F-JJTH/aeropi/www/v1/settings.txt

{"map":{"display":{"asi":true,"alt":true,"compass":true,"track":true},"overlays":{"vac":{"app":false,"lnd":true}},"layer":"oaci"},"efis":{"asi":{"tickspacing":6,"source":"gps","speed":{"vne":260,"vno":170,"vfe":110,"vso":65,"vs":90},"color":{"vne":"red","caution":"orange","normal":"green","flaps":"white"}},"alt":{"tickspacing":6,"maxalt":25000,"qnh":1018,"source":"baro"},"ai":{"color":{"ground":"#BF8144","sky":"#4C78A9"}},"compass":{"magneticdeclinaison":0,"source":"gps"},"attitude":{"pitchoffset":24.9,"rolloffset":-0.25},"timezone":{"summer":false,"offset":1},"etaType":"wp","dstType":"wp"},"general":{"lastposition":{"lat":44.11122,"lng":5.107401667},"unit":{"altitude":"ft","elevation":"ft","distance":"nm","speed":"kmh"}}}
