F-JJTH/aeropi/resources/LM2596 BUCK DC DC module schematic.jpg

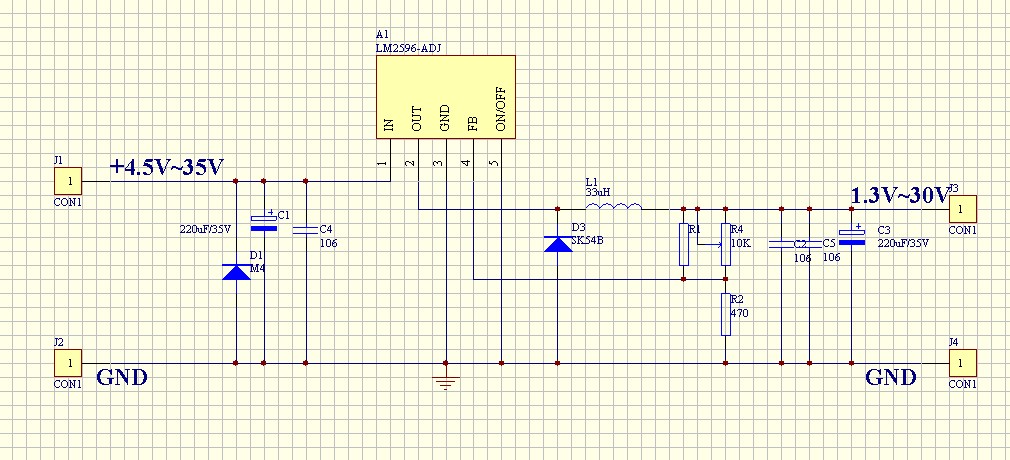
resources/LM2596 BUCK DC DC module schematic.jpg
