F-JJTH/aeropi/resources/circuit/aeroPi.ods

Reference | Value | Footprint | Datasheet | Mouser Part No. | Dispo
U3 | BME280 | aeroPi:BME280 |  |  | OK
U6 | FGPMMOPA6H | aeroPi:PA6H |  |  | OK
BT1 | Battery_Cell | Battery_Holders:Keystone_3000_1x12mm-CoinCell |  |  | OK
C1 | 0.1u | Capacitors_SMD:C_0603 |  |  | OK | https://www.aliexpress.com/item/0603-SMD-Capacitor-assorted-kit-36values-20pcs-720pcs-1pF-10uF-Samples-Kit-electronic-diy-kit/32817046315.html
C5 | 0.1u | Capacitors_SMD:C_0603 |  |  | OK
C13 | 0.1u | Capacitors_SMD:C_0603 |  |  | OK
C12 | 0.1u | Capacitors_SMD:C_0603 |  |  | OK
C11 | 0.1u | Capacitors_SMD:C_0603 |  |  | OK
C19 | 0.1u | Capacitors_SMD:C_0603 |  |  | OK
C4 | 0.1u | Capacitors_SMD:C_0603 |  | 810-C1005X5R1H104K | OK
C17 | 10n | Capacitors_SMD:C_0603 |  |  | OK
C20 | 10n | Capacitors_SMD:C_0603 |  |  | OK
C10 | 10n | Capacitors_SMD:C_0603 |  |  | OK
C9 | 10u | Capacitors_SMD:C_0603 |  |  | OK
C7 | 10u | Capacitors_SMD:C_0603 |  |  | OK
C3 | 10u | Capacitors_SMD:C_0603 |  |  | OK
C14 | 1u | Capacitors_SMD:C_0603 |  |  | OK
C16 | 1u | Capacitors_SMD:C_0603 |  |  | OK
C24 | 22n | Capacitors_SMD:C_0603 |  |  | OK
C21 | 470p | Capacitors_SMD:C_0603 |  |  | OK
C23 | 47p | Capacitors_SMD:C_0603 |  |  | OK
J1 | CONN_COAXIAL | Connectors_Molex:Molex_Microcoaxial_RF |  |  | OK
J2 | DB15_FEMALE | Connectors:DB15FC |  |  | OK | https://www.aliexpress.com/item/10pcs-DB15-D-SUB-Angle-Angled-15-Pin-Female-PCB-Mount-Socket-Connector/32709683735.html
D2 | 3D FIX | Diodes_SMD:D_0603 |  |  | OK
D4 | Diode | Diodes_SMD:D_SOD-323 |  |  | OK | https://www.aliexpress.com/item/New-1N4007-SOD-323-Silkscreen-T7-Rectifier-Diode-1A-1000V-4007-SOD323/32814032254.html
D5 | 5.6V | Diodes_SMD:D_SOD-323 |  |  | OK | https://www.aliexpress.com/item/New-Patch-Zener-Diode-BZT52C5V6S-5-6V-W9-Silkscreen-SOD-323-0805-Volume/32813876507.html
U7 | MPU-9250 | Housings_DFN_QFN:QFN-24_3x3mm_Pitch0.4mm |  |  | OK
U12 | LM358 | Housings_SOIC:SOIC-8_3.9x4.9mm_Pitch1.27mm |  |  | OK
U9 | ADS7828 | Housings_SSOP:TSSOP-16_4.4x5mm_Pitch0.65mm |  |  | OK
P1 | CONN_01X02 | Pin_Headers:Pin_Header_Straight_1x02_Pitch2.54mm |  |  | OK
P2 | CONN_01X02 | Pin_Headers:Pin_Header_Straight_1x02_Pitch2.54mm |  | 651-1904383 | OK
P4 | CONN_01X02 | Pin_Headers:Pin_Header_Straight_1x02_Pitch2.54mm |  | 651-1904383 | OK
J4 | CONN_01X04 | Pin_Headers:Pin_Header_Straight_1x04_Pitch2.54mm |  |  | OK
R20 | 220 | Resistors_SMD:R_0603 |  |  | OK | https://www.aliexpress.com/item/Free-shipping-0603-SMD-Resistor-Kit-1-10ohm-to-910Kohm-80-values-25pcs-2000pcs-Chip-Resistor/32694000352.html
R15 | 220 | Resistors_SMD:R_0603 |  |  | OK
R23 | 220 | Resistors_SMD:R_0603 |  |  | OK
R13 | 470 | Resistors_SMD:R_0603 |  |  | OK
R16 | 100k | Resistors_SMD:R_0603 |  |  | OK
R26 | 100k | Resistors_SMD:R_0603 |  |  | OK
R21 | 10k | Resistors_SMD:R_0603 |  |  | OK
R22 | 10k | Resistors_SMD:R_0603 |  |  | OK
R24 | 10k | Resistors_SMD:R_0603 |  |  | OK
R25 | 10k | Resistors_SMD:R_0603 |  |  | OK
R30 | 10k | Resistors_SMD:R_0603 |  |  | OK
R31 | 10k | Resistors_SMD:R_0603 |  |  | OK
R28 | 10k | Resistors_SMD:R_0603 |  |  | OK
R29 | 10k | Resistors_SMD:R_0603 |  |  | OK
R14 | 10k | Resistors_SMD:R_0603 |  |  | OK
R27 | 10k | Resistors_SMD:R_0603 |  |  | OK
R11 | 10k | Resistors_SMD:R_0603 |  | 71-CRCW0402-10K-E3 | OK
R1 | 1k | Resistors_SMD:R_0603 |  | 754-RR0510P-102D | OK
R3 | 3.9k | Resistors_SMD:R_0603 |  | 71-CRCW04023K90FKED | OK
R5 | 3.9k | Resistors_SMD:R_0603 |  | 71-CRCW04023K90FKED | OK
R17 | 47k | Resistors_SMD:R_0603 |  |  | OK
R12 | 47k | Resistors_SMD:R_0603 |  | 667-ERJ-2RKF4702X | OK
R19 | 51k | Resistors_SMD:R_0603 |  |  | OK
JP1 | JUMPER | Resistors_SMD:R_0603 |  |  | OK
L2 | Ferrite | Resistors_SMD:R_0805 |  |  | OK
U8 | Airspeed | SMD_Packages:SOIC-8-N |  |  | OK
U11 | MAP Pressure | SMD_Packages:SOIC-8-N |  |  | OK
Q2 | BSS138 | TO_SOT_Packages_SMD:SOT-23 |  |  | OK
Q3 | BSS138 | TO_SOT_Packages_SMD:SOT-23 |  |  | OK
Q5 | BSS138 | TO_SOT_Packages_SMD:SOT-23 |  |  | OK
Q4 | BSS138 | TO_SOT_Packages_SMD:SOT-23 |  |  | OK
Q1 | BSS138 | TO_SOT_Packages_SMD:SOT-23 |  | 621-DMG2305UX-13 | OK
U1 | MIC5219-3.3BM5 | TO_SOT_Packages_SMD:SOT-23-5 |  |  | OK | https://www.aliexpress.com/item/10PCS-MIC5219-3-3BM5-MIC5219-3-3-MIC5219-SOT23-5/32240921827.html
P3 | Raspberry_Pi_+_Conn | w_pin_strip:pin_socket_20x2 |  | 517-30340-6002 | OK
U2 | CAT24C32HU4I-GT3 | w_smd_dil:tssop-8 |  | 698-CAT24C32YI-GT3 | OK
U5 | DMMT5401 | w_smd_trans:sot23-6 |  | 621-DMMT5401-7-F | OK | https://www.aliexpress.com/item/FREE-SHIPPING-DMMT5401-7-F-DMMT5401-150V-0-2A-SOT26-50PCS/32799505824.html
