F-JJTH/aeropi/www/utils/basulm_1130.csv

Obsolète | Code terrain | Toponyme | Type | Date creation | Dernière modification | Date validation | Position | Latitude | Longitude | Altitude | Consignes | Nombre de pistes | Nature première piste | Axe préférentiel première piste | Largeur première piste | Longueur première piste | Orientation première piste | Nature deuxième piste | Axe préférentiel deuxième piste | Largeur deuxième piste | Longueur deuxième piste | Orientation deuxième piste | Radio | Carburant | Facilités | Facilités en clair | Email de contact | Téléphone | Informations complémentaires
 | LF0121 | La Tranclière | Base ULM Accès privé | 8/03/2011 | 18/02/2017 | 19/02/2017 | 46.095759195808945, 5.286019507934611 | N 46 05 45 | E 005 17 10 | 820 ft | Tour de piste impératif du côté autoroute.Ne pas voler au dessus du village de la Tranclière.Brume presque toujours dégagée. | 1 | herbe | '36 | 40 | 640 | '18-36 | herbe |  |  |  | 'Inconnue | 123.5 | à 4.5 kms | 6,4 | Restauration à proximité, Gîte à proximité | roger.emeriat@wanadoo.fr | +33 4 74 46 84 34 | Attention région très brumeuse altiport de Corlier à 15 km presque toujours dégagéTél du terrain 04 74 39 19 77Village le plus proche essence, Hôtels Pont D'ain à 4, 5 km.Auberge du Mas Pommier à Druillat direction, Pont d'Ain tel 04 74 39 17 40
 | LF0125 | Lavours | Base ULM Autorisation OBLIGATOIRE | 8/03/2011 | 18/02/2017 | 19/02/2017 | 45.795718117737, 5.773954322753866 | N 45 47 45 | E 005 46 26 | 768 ft | TDP à l'EstEviter les villages en rouge sur la photofaire la vent-arrière sur le Rhône.Attention aux rouleaux par vent de travers | 1 | herbe |  | 20 | 450 | '01-19 | herbe |  |  |  | 'Inconnue | 123.5 |  |  |  |  | +33 4 79 42 11 57 | attention, base Hydro ULM club de Lavours à proximité
 | LF0151 | Corbonod Seyssel | Aérodrome Privé Avec Restrictions Autorisation OBLIGATOIRE | 6/09/2011 | 7/10/2017 | 9/10/2017 | 45.961435318008235, 5.817990303039551 | N 45 57 41 | E 005 49 05 | 1175 ft | Arrivée dans axe de la piste puis, du centre vent arrière main gauche Suivre le plan imperatif (photo jointe) | 1 | dur | '01 | 15 | 400 | '01-19 | herbe |  |  |  | 'Inconnue | 123.5 |  | 6,4 | Restauration à proximité, Gîte à proximité | dudunoyer@yahoo.fr | +33 6 07 38 20 15 | PPR obligatoire pour tous, ULM et avion (arrêté préfectoral). Contacter le Pdt de l'AAC gestionnaire.Radio obligatoire pour tous + qualif montagne souhaitée pour avion. Interdit ULM classe 1Survol interdit à l'Est du Rhône entre Seyssel et Culoz: Zone Biotope Natura 2000Interdit en école sauf découverte du terrain pour nouveau locataire . .Radio 123.5 car piste légèrement convexe.Camping 1.5 KMResto + hôtel : 2Km
 | LF0152 | Crottet Le Bief | Base ULM Autorisation OBLIGATOIRE | 2/12/2011 | 18/02/2017 | 19/02/2017 | 46.28512660120123, 4.886040687561035 | N 46 17 06 | E 004 53 10 | 597 ft | Atterrissage en 19Décollage en 01 uniquementTDP à l'Est, intégration vent arrière 19 par le travers du seuil 01 afin d'éviter le survol des habitations au Sud. | 1 | herbe | '19 | 10 | 320 | '01-19 | herbe |  |  |  | 'Inconnue | Auto info 123.500 |  |  |  | club.ulm.crottet@gmail.com | +33 3 85 31 59 99 | Tél. Club: 03 85 31 59 99Tél. mobile : 06.52.38.01.88
 | LF0153 | Izenave | Base ULM Accès privé | 8/03/2011 | 18/02/2017 | 19/02/2017 | 46.027364325662, 5.524019645507792 | N 46 01 39 | E 005 31 26 | 2280 ft | Piste située en contrebas à l'est de l'altisurface de CORLIER qui est à survoler après auto-information en 130.00. Il est préférable d'appeler avant Pierre PELISSON pour consignes. Accueil chaleureux garanti. | 1 | herbe |  | 20 | 300 | '16-34 | herbe |  |  |  | 'Inconnue | 130.00 |  |  |  |  | +33 4 74 76 30 63 | AD - LFJD Corlier à proximité
 | LF0154 | Polliat | Base ULM Autorisation OBLIGATOIRE | 8/03/2011 | 26/12/2015 | 23/02/2016 | 46.25588282694129, 5.149563785736063 | N 46 15 21 | E 005 08 58 | 718 ft |  | 1 | herbe |  | 20 | 400 | '16-34 | herbe |  |  |  | 'Inconnue | 123.5 |  |  |  | alainbenonnier@orange.fr | +33 6 11 32 68 47
oui | LF0155 | Sergy | Base ULM fermée définitivement | 8/03/2011 | 7/07/2015 | 24/08/2017 | 46.25377556022431, 6.015897735412636 | N 46 15 14 | E 006 00 57 | 1509 ft | Plateforme fermée (temporairement), son utilisation est strictement interdite. A 2,3km la frontière suisse: ULMs interdits en Suisse ! A 500m au SE, la limite de la CTR de classe 'D' de Genève.... A 800m au Nord, un petit lac qui est le point de report 'N | 1 | herbe |  |  | 500 | '04-22 | herbe |  |  |  | 'Inconnue |  |  |  | invalid | vbujard@freesurf.ch | +41 78 711 21 35 | Consultez: http://www.agcna.org/images/Arr.VFR.jpg. Plateforme située le long de l'ancienne voie unique ferrée qui allait jadis de Bellegarde (Ain) à Nyon (Vaud).
 | LF0157 | Mionnay | Base ULM Privé Avec Restrictions Autorisation OBLIGATOIRE | 28/10/2011 | 20/03/2017 | 22/03/2017 | 45.90046192366156, 4.896061420440674 | N 45 54 02 | E 004 53 46 | 900 ft | TDP Ouest (Coté autoroute) 1300 ft ATTENTION CONTACT PREALABLE ET AUTORISATION ECRITE OBLIGATOIREterrain courtFortes turbulences possibles en courte finale 19 | 1 | herbe | '01 | 40 | 230 | '01-19 | herbe |  |  |  | 'Inconnue | 123.500 | non |  |  | eric.delachambre@orange.fr | +33 6 80 53 32 48 | Plateforme difficileCONTACT PREALABLE ET AUTORISATION ECRITE OBLIGATOIRE
 | LF0158 | Rhône Lavours | HydroSurface Libre Ouvert aux ULM Autorisation OBLIGATOIRE | 26/12/2011 | 9/04/2017 | 11/04/2017 | 45.81087630653, 5.781319903369194 | N 45 48 39 | E 005 46 53 | 767 ft | Surveiller trafic fluvial et plaisance.Lignes haute tension au-dessus du barrage. Le survol à basse altitude de la réserve naturelle du Marais de Lavours et de l'ile Malourdie à proximité de la plate forme est interdit. | 1 | eau |  |  |  | 'omnidir | herbe |  |  |  | 'Inconnue | Auto-info 123.5 |  | 3 | Restauration sur place | Carton_r@hotmail.com | +33 4 79 42 11 57 | Ponton du restaurant disponibleHydroULM Club de Lavours.L'hydrosurface est réservée aux ULMHydro.
 | LF0159 | Montrevel en Bresse | HydroSurface Libre Ouvert aux ULM Autorisation OBLIGATOIRE | 11/04/2012 | 29/03/2016 | 31/03/2016 | 46.344989833094, 5.142219161987327 | N 46 20 42 | E 005 08 32 | 620 ft |  | 1 | eau |  |  | 1000 | 'omnidir | herbe |  |  |  | 'Inconnue | Auto-info 123.5 |  | 3 | Restauration sur place |  | +33 4 74 42 72 88
 | LF0160 | Tallissieu | Aérodrome Privé Ouvert aux ULM | 14/12/2013 | 28/08/2017 | 30/08/2017 | 45.871696857606, 5.726961498355877 | N 45 52 18 | E 005 43 37 | 1433 ft | main gauche à 300 ft | 1 | herbe | '34 | 10 | 150 | '16-34 | herbe |  |  |  | 'Inconnue |  |  |  | invalid |  | +33 6 69 19 20 64 | Aérodrome privé de type altisurface.Aérologie difficile, même quand c'est calme ! plateforme supérieure étroite, bon état de surface mais devers à gauche dans le sens atterrissage, éviter le survol des riverains.
 | LF0221 | Azur Ulm | Base ULM Accès privé | 26/07/2011 | 20/10/2017 | 22/10/2017 | 49.461067531545, 3.8483798503875732 | N 49 27 40 | E 003 50 54 | 240 ft | Piste 'technique' pour les débutants. En montée vers le Nord.Aérologie parfois 'déconcertante' sur les 2 finales.Tour de piste à 700 ft QNH à l'Est des installations.Merci de ne pas survoler le village de CORBENY. | 1 | herbe |  | 20 | 235 | '18-36 | herbe |  |  |  | 'Inconnue | auto-info 123.5 | Non | 6,2,4,5 | Restauration à proximité, Hangar possible, Gîte à proximité, Camping possible | contact@azur-ulm.fr | +33 6 18 57 94 56 | Arnaud GILOTIN, propriétaire-gestionnaire est instructeur paramoteur, pendulaire, multiaxe, autogire.Contacter Arnaud au 06.18.57.94.56Consignes sur www.azur-ulm.frPour le hangar contacter Arnaud.
 | LF0223 | Mosloy | Règles spécifiques d'accès | 27/04/2011 | 20/08/2017 | 21/08/2017 | 49.174761423663, 3.154671284357846 | N 49 10 29 | E 003 09 17 | 453 ft | Téléphoner au gestionnaire (06 82 31 98 82) pour connaitre l'état de la piste avant de se poser, sauf urgence ou cas de force majeure.Posez plutôt en partie haute de la piste 11 (meilleur état) | 1 | herbe | '29 | 50 | 350 | '11-29 | herbe |  |  |  | 'Inconnue | 123.5 | A 5 kms Super U | 6,4,5 | Restauration à proximité, Gîte à proximité, Camping possible | ofjpeca@orange.fr | +33 3 23 85 24 02 | Piste située au sud, et parallèle au hameau de Mosloy.Propriétaire très sympa, abris (hangar) possible.Village à visiter, ancien château
 | LF0225 | Ployart | Base ULM Accès privé | 23/10/2011 | 22/12/2015 | 2/01/2016 | 49.503888888889, 3.7380555555555475 | N 49 30 14 | E 003 44 17 | 580 ft |  | 1 | herbe |  | 40 | 450 | '05-23 | herbe |  |  |  | 'Inconnue | auto-info 123.5
 | LF0226 | Brochot | Aérodrome Privé Ouvert aux ULM | 8/03/2011 | 25/12/2015 | 17/02/2016 | 48.976617705649, 3.373195474868794 | N 48 58 36 | E 003 22 24 | 574 ft | Tour de piste au NordEviter le survol du Village | 1 | herbe |  | 30 | 300 | '07-25 | herbe |  |  |  | 'Inconnue | Auto info 123.5 | Sur demande | 2,4,5 | Hangar possible, Gîte à proximité, Camping possible | champagne.petit@orange.fr | +33 6 80 65 93 74 | Téléphoner avant visite ULM bienvenus
oui | LF0251 | Besny-Loizy | Base ULM fermée définitivement | 8/03/2011 | 16/12/2013 | 17/12/2013 | 49.586389, 3.575833 | N 49 35 11 | E 003 34 33 | 262 ft | ATTENTION. PLATEFORME REMISE EN CULTURE QUI N'EXISTE PLUS. | 1 | herbe |  |  | 340 | '13-31 | herbe |  |  |  | 'Inconnue
 | LF0253 | Neuflieux | Base ULM Autorisation OBLIGATOIRE | 23/10/2011 | 22/12/2015 | 30/12/2015 | 49.6110714430628, 3.1485486030578613 | N 49 36 40 | E 003 08 55 | 195 ft |  | 2 | herbe |  | 20 | 200 | '17-35 | herbe |  | 20 | 200 | '06-24 | auto-info 123.5 |  |  |  | ulm@chauny.com | +33 6 75 64 54 02
oui | LF0255 | Thiérache - Vigneux | Base ULM fermée définitivement | 23/10/2011 | 23/10/2011 | 12/12/2013 | 49.728529529831, 4.008035659790039 | N 49 43 43 | E 004 00 29 | 600 ft | Circuit au sud à 500ft QFE de préférence la 26 qui est en légère montée.TERRAIN FERME | 1 | herbe |  | 0 | 600 | '08-26 |  |  |  |  |  | auto-info 123.5 |  |  |  |  | +33 6 60 12 43 54 | TERRAIN FERME.
 | LF0256 | Corbeny | Base ULM Autorisation OBLIGATOIRE | 8/03/2011 | 22/12/2015 | 30/12/2015 | 49.45763852316789, 3.8545103227538675 | N 49 27 27 | E 003 51 16 | 230 ft | Strict PPR : plateforme privée. Il s'agit d'un terrain privatif, avec un accès strictement réservé (donc accès réservé aux personnes autorisées par le propriétaire). | 1 | herbe |  |  | 400 | '18-36 | herbe |  |  |  | 'Inconnue |  |  |  |  |  |  | Ne pas confondre avec azur ulm à 500 m au Nord Ouest
 | LF0257 | Taillefontaine | Base ULM Autorisation OBLIGATOIRE | 23/10/2011 | 21/05/2017 | 22/05/2017 | 49.30708209517026, 3.0651940687865817 | N 49 18 25 | E 003 03 55 | 475 ft |  | 1 | herbe |  | 25 | 600 | '03-21 | herbe |  |  |  | 'Inconnue | auto-info 123.5 |  |  |  |  | +33 3 23 96 00 11
 | LF0258 | La Flamengrie | Base ULM Accès privé | 5/07/2011 | 22/12/2015 | 30/12/2015 | 50.000250186864, 3.944821357727051 | N 50 00 01 | E 003 56 41 | 642 ft | en 01 : arbres et haieen 19 : route et haie | 1 | herbe | '01 | 40 | 300 | '01-19 | herbe |  |  |  | 'Inconnue | 123.45 |  |  |  |  | +33 3 23 97 23 12 | Téléphoner avant de venir. Très accueillant.
 | LF0259 | Base Ulm du Val de l'Ailette | Base ULM Accès privé | 3/03/2014 | 22/12/2015 | 30/12/2015 | 49.56744269009908, 3.2303074391684206 | N 49 34 03 | E 003 13 49 | 184 ft | verticale 300m solcircuit de piste par l'est, à 150 m sol, côté hangarAu sud des installations,le seuil de piste est décalé , il se situe à 105 m de la route. | 1 | herbe |  |  | 250 | '18-36 | herbe |  |  |  | 'Inconnue |  |  |  |  |  | +33 6 88 18 07 66
 | LF0324 | Veauce | Base ULM Autorisation OBLIGATOIRE | 23/10/2011 | 29/08/2017 | 30/08/2017 | 46.173333333333, 3.0588888888888732 | N 46 10 24 | E 003 03 32 | 1570 ft | Plateforme privée. C'est ce qui reste de l'ancien aérodrome (pour avions) de Veauce. | 1 | herbe |  | 30 | 300 | '12-30 | herbe |  |  |  | 'Inconnue | auto-info 123.5 |  |  | invalid | nicole_lagoutte@orange.fr | +33 6 81 91 79 07
oui | LF0352 | Deneuille les Chanteille | Base ULM fermée définitivement | 8/03/2011 | 16/06/2012 | 17/12/2013 | 46.25046204786897, 3.145910232788083 | N 46 15 02 | E 003 08 45 | 1105 ft | Plateforme privée occasionnelle, PPR à Mr Berton Alain, phone: 04 70 56 61 90. | 1 | herbe |  |  |  | '18-36 | herbe |  |  |  | 'Inconnue |  |  |  |  |  | +33 4 70 56 61 90
 | LF0353 | Saint Fargeol Les Fougères | EPISODIQUE | 23/10/2011 | 22/02/2016 | 28/02/2016 | 46.141666666667, 2.6113888888888823 | N 46 08 30 | E 002 36 41 | 1706 ft | Seuil à 200m au sud du hangar au 30 ouestchamp agri : si manche air et balises posées, atterrissage possible. Faire un passage bas pour assurerMaison seule à 500m à l'ouest.tél. 06 20 35 05 24 avant si possible ! | 1 | herbe |  | 50 | 280 | '01-19 | herbe |  |  |  | 'Inconnue | Auto info 123.5 |  | 6 | Restauration à proximité | jm.ducros@wanado.fr | +33 1 06 20 35 05 24 | Possibilité de poser à partir de juin (herbe basse) tél. auparavant Resto à 4 km. Zone de vol basse altitude R-143.
 | LF0354 | Verneuil en Bourbonnais | Base ULM Autorisation OBLIGATOIRE | 23/10/2011 | 24/12/2015 | 19/01/2016 | 46.359903509900356, 3.268334505293069 | N 46 21 36 | E 003 16 06 | 885 ft |  | 1 | herbe |  | 20 | 250 | '02-20 | herbe |  |  |  | 'Inconnue | auto-info 123.5 |  |  |  |  | +33 4 70 45 36 16 | site : à 800m au nord du carrefour D34/D18, en bordure est de la D18.
 | LF0355 | Banelle | Base ULM Autorisation OBLIGATOIRE | 8/03/2011 | 13/09/2015 | 3/10/2015 | 46.125213945438745, 3.2869030343932764 | N 46 07 31 | E 003 17 13 | 355 ft | Seuil décalé de 50m cote nord car route proximité entrée de piste. Circuit de piste recommandé à l'est . | 1 | herbe |  | 20 | 300 | '01-19 | herbe |  |  |  | 'Inconnue | Auto-info 123.5
 | LF0369 | La Tuilière | Aérodrome Privé Ouvert aux ULM | 23/10/2011 | 24/12/2015 | 19/01/2016 | 46.532689906287835, 3.1183697265785213 | N 46 31 58 | E 003 07 06 | 860 ft | Atterrissage obligatoire en 20 face au bois, à cause du léger dénivelé et de la hauteur des arbres. Attention : piste situé dans le couloir LF-R144 (800-2000ft ASFC). Consulter l'activité avant de venir. | 1 | herbe | '20 | 20 | 550 | '02-20 | herbe |  |  |  | 'Inconnue | 123.5 | SP95 (réserver) |  |  | domaine-la-tuiliere@orange.fr | +33 4 70 46 53 59 | Webcam : http://domainelatuiliere.noip.me:1651Station méteo sur place :http://www.weatherlink.com/user/tuiliere03/index.php?view=main&headers=1
 | LF0421 | Clamensane les 3 Fontaines | AltiSurface temporairement fermée. | 8/03/2011 | 4/09/2017 | 5/09/2017 | 44.314318784384, 6.071526201036249 | N 44 18 52 | E 006 04 17 | 2933 ft | Atterrissage en 22, décollage en 04Piste 22 en pente montante de 13% sur les 200 premiers mètresLes 200m restants sont quasi horizontauxLe haut de la piste est à 2945ft. Attention à la vélisuface de La-Motte-du-Caire toute proche dans la vallée. | 1 | herbe | '22 | 20 | 400 | '04-22 | herbe |  |  |  | 'Inconnue | 123.5 |  | 3,4,5 | Restauration sur place, Gîte à proximité, Camping possible | les-3-fontaines@wanadoo.fr | +33 4 92 68 36 16 | Avions : Qualification Montagne obligatoire.ULM : Libre d'accès.PILOTES ULM : Pour votre sécurité et pour obtenir les dernières consignes, veuillez contacter le PNVM (Pôle National Vol Montagne) au 0698282850 ou 0683512668.PPR au propriétaire (Mr Bruhl) exploitant le centre de loisirstél 04 92 68 36 16 fax: 04 92 68 38 90Conditions particulières pour les pilotes:Accès WIFI
oui | LF0422 | Plateau de l'Alp | Altisurface fermée | 8/03/2011 | 6/12/2013 | 10/12/2013 | 44.350556, 6.724166999999966 | N 44 21 02 | E 006 43 27 | 7150 ft |  | 1 | neige |  |  | 600 | '12-30 |  |  |  |  |  |  |  |  |  |  | +33 4 92 62 60 75
 | LF0426 | Thorame Haute Les Serres | AltiSurface en service | 8/03/2011 | 27/02/2016 | 29/02/2016 | 44.12305555555555, 6.559999999999945 | N 44 07 23 | E 006 33 36 | 6129 ft |  | 1 | herbe | '31 |  |  | '13-31 | herbe |  |  |  | 'Inconnue |  |  |  |  |  | +33 4 92 62 60 75 | Avions : Qualification Montagne requise.ULM : Libre d'accès.PILOTES ULM : Pour votre sécurité et pour obtenir les dernières consignes, veuillez contacter le PNVM (Pôle National Vol Montagne) au 0698282850 ou 0683512668.
 | LF0429 | Sainte Croix sur Verdon | Aérodrome Privé Ouvert aux ULM | 8/03/2011 | 30/08/2017 | 31/08/2017 | 43.778675716043, 6.159635219573829 | N 43 46 43 | E 006 09 35 | 2190 ft | circuits obligatoirement à l'Est -- ne jamais survoler le petit bois des grandes antennes RMC -- 4 lignes électriques à 500m au N/O -- seuils décalés cause clôture électrique -- environnement sensible : Parc Regional -- survol campings, maisons interdit | 1 | herbe |  | 30 | 650 | '13-31 | herbe |  |  |  | 'Inconnue | 123.5 |  | 6,4,5 | Restauration à proximité, Gîte à proximité, Camping possible | aeromartin@free.fr | +33 6 80 40 97 08 | Aérodrome privé, PPR obligatoire au locataire du champ, Mr André Martin, Président de l'Aéro-Club du Lys, club de Motoplaneurs basé sur l'aérodrome de Persan-Beaumont LFPA, mobile 06 80 40 97 08.site internet : http://www.aeroclub-sainte-croix-du-verdon.comRoute de Ste-Croix à Moustiers traverser la ferme des Roux (située à l'écart de cette route), au delà: 150m à droite: la piste
 | LF0430 | Seyne les Alpes | Aérodrome Privé Avec Restrictions Autorisation OBLIGATOIRE | 8/03/2011 | 26/12/2015 | 22/02/2016 | 44.341944, 6.372778000000039 | N 44 20 31 | E 006 22 22 | 3937 ft |  | 1 | herbe |  | 50 | 900 | '13-31 | herbe |  |  |  | 'Inconnue |  |  |  |  |  | +33 2 92 35 25 13 | Aérodrome privé, exclusivement réservé au vol à voile. Utilisation du treuil.
 | LF0431 | La Motte du Caire | Aérodrome Privé Avec Restrictions Autorisation OBLIGATOIRE | 8/03/2011 | 19/12/2015 | 27/12/2015 | 44.322860248510864, 6.031285560851984 | N 44 19 22 | E 006 01 53 | 2132 ft | Aérodrome privé, exclusivement réservé au vol à voile. Utilisation du treuil. | 1 | herbe | '36 | 50 | 1170 | '18-36 | herbe |  |  |  | 'Inconnue | 123.5 |  |  |  | cvvmc04@wanadoo.fr | +33 4 92 68 35 11 | Aérodrome privé, réservé exclusivement au Vol à Voile. Aucun aéronef à moteur n'est autorisé à décoller. Les lancements s'effectuent exclusivement au treuil. Un pilote de planeur qui atterrit à La Motte du Caire devra effectuer un vol de double avec un instructeur avant d'être autorisé à décoller son planeur même s'il a déjà une pratique du décollage au treuil.
 | LF0434 | Thorame Haute Les Serres 2 | AltiSurface en service | 8/03/2011 | 27/02/2016 | 29/02/2016 | 44.115, 6.538610999999946 | N 44 06 54 | E 006 32 19 | 6398 ft |  | 2 | herbe |  | 20 | 350 | '02-20 | herbe |  | 20 | 300 | '05-23 |  |  |  |  |  | +33 4 92 62 60 75 | Avions : Qualification Montagne requise. Contactez l'AFPM pour de plus amples renseignements sur ce terrain.ULM : Libre d'accès. Pilotes, pour votre sécurité et pour obtenir les dernières consignes, veuillez contacter le PNVM (Pôle National Vol Montagne) au 06 98 28 28 50 ou 06 83 51 26 68.
 | LF0451 | Hippodrome Oraison | Base ULM Accès privé | 4/10/2011 | 9/06/2017 | 11/06/2017 | 43.92143620352292, 5.904078483581543 | N 43 55 17 | E 005 54 15 | 1100 ft | Activité Aéromodélisme, faire verticale 450ft pour se faire voir, tour de piste obligatoire coté Ouest sur la Durance. Emplacement biroute à gauche en entrée de piste face Nord. L'axe de piste est délimité par 4 plaques blanches. Radio 123.50 | 1 | herbe | '36 | 10 | 150 | '18-36 | herbe |  |  |  | 'Inconnue | Auto-info 123.5 | à 200m | 6 | Restauration à proximité | lemasdetheo@gmail.com | +33 6 32 59 34 15 | 250m utilisable le matin face Nord par brise descendante. 150m l'après midi en face Sud compte tenu des obstacles (ligne HT et hangar).Activité aéromodélisme, il est impératif de faire une verticale afin de se signaler.Piste fermée sur Arrêté Préfectoral pour courses hippiques:Dates à retenir pour 2017 : 2 juillet 2017, 3 septembre 2017.
 | LF0452 | Ségriès | Base ULM accès libre Utilisation EPISODIQUE | 8/03/2011 | 26/12/2015 | 22/02/2016 | 43.86777800000001, 6.178256767211906 | N 43 52 04 | E 006 10 42 | 2657 ft | Attention, piste dans le TdP de Puimoisson !! ... | 1 | herbe |  | 20 | 400 | '06-24 | herbe |  |  |  | 'Inconnue | Auto info 123.5
 | LF0453 | Cruis Mas Des Grailles | Base ULM Accès privé | 27/09/2011 | 26/05/2016 | 27/05/2016 | 44.060283097367, 5.853009223937988 | N 44 03 37 | E 005 51 11 | 2270 ft | Terrain ULM de type altisurface.PPR : Contact préalable obligatoire, merci.L'atterrissage se fait obligatoirement en 35, la piste a une pente de 6 %. Possibilité de forts rabattants, en été, l'après midi. | 1 | herbe | '35 | 8 | 300 | '17-35 | herbe |  |  |  | 'Inconnue | 123.5 |  | 6 | Restauration à proximité | masdesgrailles@gmail.com | +33 4 92 77 04 83 | Le mas des Grailles est un Gîte de France, pourvu d'une piste ULM de 300mChambres avec petit déjeuners, ou gite en gestion libre pour plusieurs jours.Restaurants 1 ou 3 km .
 | LF0456 | Banon | AltiSurface en service | 8/03/2012 | 23/08/2017 | 24/08/2017 | 44.07228112077565, 5.639221763610976 | N 44 04 20 | E 005 38 21 | 3723 ft | Tour de piste main gauche, atterrissage face au nord, décollage face au sud,aérologie délicate.Ne pas utiliser la piste est-ouest pour cause de nuisances et son état de surface. | 1 | herbe | '35 | 15 | 500 | '17-35 | herbe |  |  |  | 'Inconnue | 130.00 | néant |  | invalid | pierrelouisbremond@gmail.com | +33 4 92 73 21 09 | Avions : Qualification Montagne requise.PILOTES ULM : Pour votre sécurité et pour obtenir les dernières consignes, veuillez contacter le PNVM (Pôle National Vol Montagne) au 0698282850 ou 0683512668.Localité la plus proche (Banon) à 6 km à pied.
 | LF0458 | Thorame-Haute Chamatte | AltiSurface en service | 13/04/2015 | 6/02/2016 | 25/02/2016 | 44.139722222222225, 6.548333333333403 | N 44 08 23 | E 006 32 54 | 6827 ft |  | 1 | neige |  | 20 | 350 | '01-19 | herbe |  |  |  | 'Inconnue |  |  |  |  |  | +33 4 92 62 60 75 | Avions : Qualification Montagne requise. Contactez l'AFPM pour de plus amples renseignements sur ce terrain.ULM : Libre d'accès. Pilotes, pour votre sécurité et pour obtenir les dernières consignes, veuillez contacter le PNVM (Pôle National Vol Montagne) au 06 98 28 28 50 ou 06 83 51 26 68.
 | LF0459 | Thorame Basse | Base ULM ouverte tous types | 1/12/2013 | 26/12/2015 | 22/02/2016 | 44.076944444444, 6.47361111111104 | N 44 04 37 | E 006 28 25 | 3609 ft | Terrain de type altisurface situé à 300m au NW du hameau de la-BâtieAtterrissage en 31, tour de piste côté NETalus au seuil 31, fossé au bout de champ, rotors et turbulence par vent de NW. | 1 | herbe | '31 | 20 | 300 | '13-31 | herbe |  |  |  | 'Inconnue
oui | LF0522 | Col Saint Jean | Altisurface fermée | 10/04/2011 | 6/12/2013 | 10/12/2013 | 44.413889, 6.373056 | N 44 24 50 | E 006 22 23 | 6201 ft | Altisurface utilisable en hiver par neige avec skis. Présence fréquente de skieurs et de randonneurs. | 1 | neige | '07 | 25 | 450 | '07-25 |  |  |  |  |  |  |  |  |  |  | +33 4 92 05 04 36
 | LF0523 | Glacier Lombard | AltiSurface en service | 8/03/2011 | 27/02/2016 | 29/02/2016 | 45.108333333333334, 6.322222222222194 | N 45 06 30 | E 006 19 20 | 10695 ft | Reco E en W. Approche verticale Torrent de Maurian puis N Aiguille de Goléon.Finale cap 310. Remise des gaz impossible en courte finale. | 1 | neige |  |  |  | '13-31 | herbe |  |  |  | 'Inconnue |  |  |  |  |  |  | Avions : Qualification Montagne obligatoireULM : Libre d'accèsPILOTES ULM : Pour votre sécurité et pour obtenir les dernières consignes, veuillez contacter le PNVM (Pôle National Vol Montagne) au 06982828 ou le Président du club au 0609681122
 | LF0524 | Grand Terrus | AltiSurface en service | 8/03/2011 | 28/08/2017 | 30/08/2017 | 44.422777777778, 5.644166666666706 | N 44 25 22 | E 005 38 39 | 2871 ft | Piste de montagne : pente 15 %atterrissage en 02 décollage en 20. Seuil de piste 02 à 2700'. Arbres et ligne électrique en courte finale 02. Tour de piste main droite,clotures éléctriques autour du terrain protection contre les sangliers | 1 | herbe | '02 | 25 | 295 | '02-20 | herbe |  |  |  | 'Inconnue |  |  |  | invalid |  | +33 4 92 62 60 75 | Avions : Qualification Montagne obligatoireULM : Libre d'accèsPILOTES ULM : Pour votre sécurité et pour obtenir les dernières consignes, veuillez contacter le PNVM (Pôle National Vol Montagne) au 0698282850 ou 0683512668.
oui | LF0535 | Le Buzon Gap | Base ULM fermée définitivement | 8/03/2011 | 8/03/2011 | 2/03/2014 | 44.603333, 6.106111 | N 44 36 12 | E 006 06 22 |  |  | 1 | herbe |  |  |  | 'Inconnue | herbe |  |  |  | 'Inconnue
 | LF0538 | Saint Etienne en Devoluy | AltiSurface en service | 11/07/2011 | 26/12/2015 | 22/02/2016 | 44.66803430605305, 5.90482365078401 | N 44 40 05 | E 005 54 17 | 6201 ft | Tour de piste 21 à main droite. Piste fort caillouteuse : dégâts possibles à l'aéronef (volets, hélice, profondeur)Pente de 10 à 17%, bas de la pente 6037', sommet 6201'. Après décollage en 03, virage à droite en passant au Nord de Super-Dévoluy. | 1 | terre | '21 | 40 | 445 | '03-21 | herbe |  |  |  | 'Inconnue |  |  | 4 | Gîte à proximité |  |  | Avions : Qualification Montagne obligatoireULM : Libre d'accèsPILOTES ULM : Pour votre sécurité et pour obtenir les dernières consignes, veuillez contacter le PNVM (Pôle National Vol Montagne) au 0698282850 ou 0683512668.Live webcams de la station : http://www.ledevoluy.com/fr/direct-devoluy/webcam.htmlChalet pour la nuit à disposition des membres de l'AFPM
 | LF0551 | Crots | Base ULM Autorisation OBLIGATOIRE | 8/03/2011 | 26/12/2015 | 22/02/2016 | 44.53657313242666, 6.43500720962345 | N 44 32 12 | E 006 26 06 | 2600 ft |  | 1 | terre |  | 40 | 450 | '06-24 | herbe |  |  |  | 'Inconnue | 123.500 |  |  |  | rolland.jame@wanadoo.fr | +33 4 92 43 40 82 | Contact et informationsDominique Morettidoumemoretti@gmail.comPort: 06 52 39 42 48
 | LF0553 | Colombe d'Eyguians | AltiSurface en service | 23/07/2012 | 7/11/2015 | 9/11/2015 | 44.365007359327, 5.786721801757835 | N 44 21 54 | E 005 47 12 | 2410 ft | Pente 10% en montée sur 04.Atterrissage en 04Décollage en 22 | 1 | terre | '04 | 25 | 320 | '04-22 | herbe |  |  |  | 'Inconnue | 130.00 |  |  |  |  | +33 4 92 62 60 75 | Avions : Qualification Montagne requise.ULM : Libre d'accès.PILOTES ULM : Pour votre sécurité et pour obtenir les dernières consignes, veuillez contacter le PNVM (Pôle National Vol Montagne) au 0698282850 ou 0683512668.(Nota: La longueur utile de la piste est de 280m)
 | LF0621 | Isola 2000 | AltiSurface en service | 8/03/2011 | 18/07/2016 | 23/07/2016 | 44.171667, 7.163055999999983 | N 44 10 18 | E 007 09 47 | 7620 ft | Tours de piste main droite, en restant au dessus de la vallée, sans aller sur la crête au nord (frontière), la branche finale est donc courte, atterrissage en 17, décollage en 35. Seuil de piste 17 à gauche d'un petit lac et du téléski du Plateau. | 1 | herbe | '17 | 20 | 250 | '17-35 | herbe |  |  |  | 'Inconnue | 130.00 |  |  |  |  | +33 4 93 23 14 78 | Altisurface située à 1km au Sud d'Isola 2000, Live Webcams : http://www.webcamski.com/interfaces/isola/interface.php?pk_interface=61&m=images&r=zooms Territoire devenu français en 1947.Qualification Montagne requise pour les avions.Libre d'accès pour les ULM.PILOTES ULM : Pour votre sécurité et pour obtenir les dernières consignes, veuillez contacter le PNVM (Pôle National Vol Montagne) au 0698282850 ou 0683512668.
 | LF0651 | Juan Les Pins | HydroSurface Libre Ouvert aux ULM Autorisation OBLIGATOIRE | 8/03/2011 | 27/02/2016 | 29/02/2016 | 43.565547558903006, 7.102468582031181 | N 43 33 56 | E 007 06 09 |  | Plan d'eau uniquement accessible aux hydro ulm et à eux seuls. Des renseignements utiles sont a prendre au site internet suivant www.ulm-fayence.comSe munir d'une carte aéronautique et d'une radio. | 1 | eau |  | 0 | 0 | 'omnidir | herbe |  |  |  | 'Inconnue | Auto-info 123.5 |  | 6 | Restauration à proximité | pascalesautel@hotmail.com | +33 6 09 52 03 80 | Attention la mairie d'Antibes refuse que l'on utilise ses chenaux.
 | LF0652 | Cipières Alpes d'Azur ULM | AltiSurface en service | 8/03/2011 | 15/10/2017 | 17/10/2017 | 43.779102294802, 6.862965551559455 | N 43 46 45 | E 006 51 47 | 3723 ft | ULM et avions tour de piste différents, voir fiche altisurface. .LIGNE HAUTE TENSION au Sud et 800m avant le seuil de piste dans l'axe. turbulences possibles en finale | 1 | herbe | '09 | 18 | 380 | '09-27 | herbe |  |  |  | 'Inconnue | 130.00 | non | 5 | Camping possible | aropion@wanadoo.fr | +33 6 99 54 53 33 | Altisurface accessible aux pilotes avion qualifiés montagne.Pour les ULM formation montagne conseillée.PILOTES ULM : Pour votre sécurité et pour obtenir les dernières consignes, veuillez contacter le PNVM (Pôle National Vol Montagne) au 06982828 ou le Président du club au 0699545333Se référer à la fiche de piste éditée par AFPM mise a jour août 2017Webcam : http://www.solarcam.fr/ALPES_DAZUR_ULM/Pioupiou 275, tel 09 72 47 71 41
 | LF0654 | Valberg | AltiSurface en service | 8/03/2011 | 7/11/2015 | 10/11/2015 | 44.106944444444, 6.939444444444462 | N 44 06 25 | E 006 56 22 | 5680 ft | Seuil décalé car piste rallongée mais l'herbe pousse... Arrivée par les gorges de Daluis. Ne pas survoler la station de Valberg ne pas survoler la bergerie au nord de l'altisurface. limité à 2 tours de piste. | 1 | terre | '14 | 35 | 410 | '14-32 | herbe |  |  |  | 'Inconnue |  |  |  |  |  | +33 6 09 51 25 78 | Avions : Qualification Montagne requise.ULM : Libre d'accès.PILOTES ULM : Pour votre sécurité et pour obtenir les dernières consignes, veuillez contacter le PNVM (Pôle National Vol Montagne) au 0698282850 ou 0683512668.
oui | LF0721 | Annonay | Base ULM fermée définitivement | 8/03/2011 | 24/06/2015 | 17/07/2015 | 45.209444, 4.669444 | N 45 12 34 | E 004 40 10 | 1148 ft |  | 1 | herbe |  |  | 350 | 'Inconnue | herbe |  |  |  | 'Inconnue
oui | LF0722 | Gilhoc sur Ormèze | Base ULM fermée définitivement | 8/03/2011 | 24/06/2015 | 17/07/2015 | 44.97286149033867, 4.6612564047545675 | N 44 58 22 | E 004 39 41 | 2145 ft | suite visite sur place de 'pillou'hangar servant d'étable, ligne Electrique travers centre piste, fort deversapparemment jamais activedangereuse | 1 | herbe |  |  |  | 'Inconnue | herbe |  |  |  | 'Inconnue
 | LF0723 | Notre-Dame-des-Neiges-Abbaye | AltiSurface en service | 8/03/2011 | 30/10/2015 | 1/11/2015 | 44.600669640398, 3.9267480317382706 | N 44 36 02 | E 003 55 36 | 3760 ft |  | 1 | herbe | '35 | 25 | 300 | '17-35 | herbe |  |  |  | 'Inconnue |  |  |  |  |  | +33 4 66 69 00 90 | Avions : Qualification Montagne requise.ULM : Libre d'accès.PILOTES ULM : Pour votre sécurité et pour obtenir les dernières consignes, veuillez contacter le PNVM (Pôle National Vol Montagne) au 0698282850 ou 0683512668.
oui | LF0724 | Mont Gerbier de Jonc | Altisurface fermée | 8/03/2011 | 5/04/2015 | 28/11/2016 | 44.84790023284271, 4.194184608459409 | N 44 50 52 | E 004 11 39 | 4300 ft | ATT en 32, DEC en 14 TDP main gauchePente : 100 m à 15% + 150 m à 10% +170 m à 4% - attention au bétailpiste définitivement fermée source AFPM 01-2015 | 1 | herbe | '32 | 25 | 520 | '14-32 | herbe |  |  |  | 'Inconnue | 130.00 |  | 6,4 | Restauration à proximité, Gîte à proximité |  | +33 4 75 38 80 34 | Il est indispensable de téléphoner avant d'utiliser cette piste car présence possible d'animaux sur la piste.Avions : Qualification Montagne requise.ULM : Libre d'accès.Restauration et gite sur sur réservation à M. Jarlutsource AFPM 07-01ALa piste est définitivement fermée source AFPM 01-2015
 | LF0725 | Le Bez | AltiSurface en service | 8/03/2011 | 8/09/2015 | 21/09/2015 | 44.63372418472167, 4.046093753936702 | N 44 38 01 | E 004 02 46 | 4320 ft | Main gauche. Décollage 05, atterrissage 23. Pente 18% régulier. Sol naturel non aménagé. | 1 | herbe |  | 25 | 320 | '05-23 | herbe |  |  |  | 'Inconnue | 130.00 |  | 6,4 | Restauration à proximité, Gîte à proximité |  | +33 6 86 98 14 81 | Avions : Qualification Montagne requise.ULM : Libre d'accès.PILOTES ULM : Pour votre sécurité et pour obtenir les dernières consignes, veuillez contacter le PNVM (Pôle National Vol Montagne) au 0698282850 ou 0683512668.Auberge du Bez (500 m ): 04 66 46 60 54
oui | LF0751 | Echamps | Base ULM Autorisation OBLIGATOIRE | 8/03/2011 | 8/03/2011 | 13/01/2014 | 44.8475, 4.194999999999936 | N 44 50 51 | E 004 11 42 | 3772 ft | Tour de piste à gauche, atterrissage en 33, décollage en 15,Pente montante de 17% sur les premiers 100m après le seuil 33, puis la pente diminue et s'annule. | 1 | herbe | '33 | 25 | 500 | '15-33 | herbe |  |  |  | 'Inconnue | 130.000 |  | 1 | Atelier ULM |  | +33 4 45 38 80 34 | PPR obligatoire car du bétail peut paître Mont Gerbier-de-Jonc, Domaine de Villevieille, indiquée sur la carte Michelin au 1/200 Terrain de type altisurfacehttp://www.jeuneloiremezenc.com/aphp/prncs.php?numress=R00053 http://www.sourcesetvolcans-ardeche.com/hebergement_chambres.aspx?Id=675
 | LF0752 | Saint Sauveur de Cruzière | Base ULM fermée définitivement | 8/03/2011 | 23/05/2017 | 25/05/2017 | 44.2667622269815, 4.258169218246394 | N 44 16 00 | E 004 15 29 | 480 ft | Piste orientée 13/31, la 31 recommandée à l'atterrissage (semi-montante). Dégager par le nord au décollage, éviter le survol des habitations. Contact radio obligatoire à Orange approche pour le décollage. | 1 | herbe | '31 | 40 | 400 | '13-31 | herbe |  |  |  | 'Inconnue | 123.5 |  | 4 | Gîte à proximité | aschoer@nordnet.fr | +33 4 75 36 00 22 | PPR :Téléphoner au propriétaire pour l'accueil et connaitre l'état de la piste. Située dans la zone d'Orange R55B. Piste dans la partie la plus méridionale du département de l'Ardèche.à 1,5km, gîte dans Mas provençal avec piste appartenant à Armand Schoer.gîtes uniquement location à la semaine. Pas de repas sur placeSite internet du gîte - www.larbrequichante.comDe St Jean de Maruéjols, prendre la D350-A direction St Geniès
 | LF0753 | Deyras Saint Victor | Base ULM Accès limité Autorisation OBLIGATOIRE | 15/03/2015 | 9/09/2017 | 11/09/2017 | 45.093272319456, 4.706864452362083 | N 45 05 36 | E 004 42 25 | 1425 ft | préf 34: VAR. à L'EST, base av village, long. finale adapt. à votre finesse pour éviter virage dessus ligne ERDF.TDP répétés, passages bas, survols habitation INTERDITS Piste encadrée/vergers, fort gradient vent. montée vers le Nord + dévers vers l'Est. | 1 | herbe | '34 | 40 | 341 | '16-34 | herbe |  |  |  | 'Inconnue | 123.5 | Non | 6,4,5 | Restauration à proximité, Gîte à proximité, Camping possible | airdeschoix@gmail.com | +33 6 08 78 87 09 | Respect impératif des consignes de TDP. Fort rabattants et gradient en courte finale 34 prise de vitesse impérative et décaler le seuil au nord. Repère futs blancs à la mi-piste: remise de gaz si pas posé ou stop si pas décollé.
oui | LF0823 | Givet | Base ULM Accès privé | 8/03/2011 | 8/03/2011 | 28/02/2014 | 50.136111, 4.823333000000048 | N 50 08 10 | E 004 49 24 |  |  | 1 | herbe |  |  |  | 'Inconnue | herbe |  |  |  | 'Inconnue
 | LF0851 | Avaux - Les Bourdons | Base ULM Autorisation OBLIGATOIRE | 8/03/2011 | 23/12/2015 | 5/01/2016 | 49.480556, 4.0750000000000455 | N 49 28 50 | E 004 04 30 | 374 ft | PPR: demande préalable Tour de piste par le NordObstacle: antenne rouge et blanche de mesures des vents, au Nord Ouest du QFU 11. | 1 | herbe |  | 20 | 430 | '11-29 | herbe |  |  |  | 'Inconnue |  | essence à 6 kms |  |  | gacoin.jean.marieclaire@wanadoo.fr | +33 6 23 25 33 83 | Plateforme située sur la commune d'Asfeld.pour utilisation : Mr J. Gacoin au 03 24 72 94 07 Accès : du centre du bourg d'Avaux, prendre dir. Nord rue Léo Lagrange, continuer tout droit à 2.5 kms
 | LF0921 | Aleu | AltiSurface en service | 8/03/2011 | 23/11/2016 | 24/11/2016 | 42.90035366895571, 1.2752682209014665 | N 42 54 01 | E 001 16 31 | 3445 ft | Piste situé au sommet du Taus (1069m), concave de 11 à 12%, atterrissage en 10, décollage en 28. Utilisable en toutes saisons (sauf neige). Attention : possibilité d'ornières profondes, vérification nécessaire à pied de la viabilité de cette surface. | 2 | herbe | '10 | 15 | 250 | '10-28 | herbe |  | 10 | 115 | '17-35 | Auto info 130.000 | Aucun |  |  | danielserres@sfr.fr | +33 6 88 23 79 26 | Avions : Qualification Montagne requise.ULM : Libre d'accès.La deuxième piste 17/35 est en cours d'aménagement par les bénévoles (été 2016). Elle est surtout destinée aux décollages.Notre bénévole Jean-Louis Vidal (06 78 78 94 64) est le plus au courant de l'état de la plate-forme.En haut sur la plate forme, on est le long d'un talus vertical.Attention aux grandes envergures.
 | LF0922 | Artigat - Martin Gu'air | Base ULM Autorisation OBLIGATOIRE | 10/09/2011 | 25/12/2015 | 16/02/2016 | 43.146777013176, 1.43996000289917 | N 43 08 48 | E 001 26 24 | 730 ft | Seuils de pistes bien dégagés. Évitez de survoler le pâté de maison à l'ouest. | 1 | herbe |  | 25 | 200 | '16-34 | herbe |  |  |  | 'Inconnue |  |  |  |  |  | +33 6 72 21 92 57 | Ulm Ariege serviceFigarol Pierre.06 08 94 19 34
oui | LF0923 | Bethmale | Aérodrome fermé. | 8/03/2011 | 25/12/2015 | 23/09/2016 | 42.883522365886, 1.0812115899352648 | N 42 53 01 | E 001 04 52 | 3960 ft | situé sur une crête | 1 | herbe |  |  | 230 | '09-27 | herbe |  |  |  | 'Inconnue |  |  |  |  |  | +33 5 61 66 65 23
 | LF0924 | La Plagne Bouirex | AltiSurface en service | 8/03/2011 | 17/10/2015 | 22/10/2015 | 42.866667, 1.138333 | N 42 52 00 | E 001 08 18 | 5249 ft | Piste peu en pente, mais dévers sensible à droite à l'atterrissage. Trous de sangliers et taupinières.Présence d'une bosse 30 mètres après l'entrée de piste, il est préférable de toucher après. Une rubalise en haut de la piste tient lieu de biroute. | 1 | herbe | '28 | 20 | 200 | '08-26 | herbe |  |  |  | 'Inconnue |  |  |  |  |  | +33 6 78 78 94 64 | Avions : Qualification Montagne requise.ULM : Libre d'accès.PILOTES ULM : Pour votre sécurité et pour obtenir les dernières consignes, veuillez contacter le PNVM (Pôle National Vol Montagne) au 0698282850 ou 0683512668.Notre bénévole Jean-Louis Vidal (06 78 78 94 64) est le plus au courant de l'état de la plate-forme, sur laquelle il travaille assidûment.
 | LF0925 | Villeneuve du Latou | Aérodrome Privé Ouvert aux ULM | 9/07/2011 | 25/12/2015 | 16/02/2016 | 43.204409420925614, 1.4191460609436035 | N 43 12 16 | E 001 25 09 | 1330 ft | Aérodrome privé réservé à l'utilisation du propriétaire de sa famille et de ses invités. | 1 | herbe |  | 0 | 300 | '05-23 | herbe |  |  |  | 'Inconnue |  |  |  |  |  | +33 5 61 34 93 96 | Aérodrome privé réservé à l'utilisation du propriétaire de sa famille et de ses invités.
 | LF0926 | Cérizols | Hélistation privée. Autorisation OBLIGATOIRE | 8/03/2011 | 25/12/2015 | 16/02/2016 | 43.128888888889, 1.0694444444445708 | N 43 07 44 | E 001 04 10 |  | EXCLUSIVEMENT RESERVE AUX BALLONSaires agréées par l'Aviation Civile à CERIZOLS (09) ou LAFFITE-TOUPIERE (31), sont pour le moment les terrains d'où nous décollons | 1 | herbe |  |  | 200 | 'omnidir | herbe |  |  |  | 'Inconnue |  |  |  |  | contact@ballon-bleu-horizon.fr | +33 6 98 19 30 00 | TERRAIN DE LA SOCIETE 'BALLON BLEU HORIZON'INTERDIT AUX ULMRESERVE AUX BALLONS
 | LF0927 | Troye d'Ariège | Base ULM Accès privé | 17/07/2011 | 25/12/2015 | 16/02/2016 | 43.02004293475569, 1.8775087594985962 | N 43 01 12 | E 001 52 39 | 1377 ft | Tour de piste au sud. | 1 | herbe |  | 30 | 220 | '11-29 | herbe |  |  |  | 'Inconnue | 123.550 |  |  |  | partagair@gmail.com | +33 6 88 50 60 85
 | LF0928 | Ferme de Bon repos - Régat | Base ULM ouverte tous types | 8/03/2011 | 21/09/2016 | 22/09/2016 | 42.983909248608, 1.8935475767211756 | N 42 59 02 | E 001 53 37 | 1341 ft | Nous n'avons pas de fréquence Sol. En vol local notre fréquence est 123.450 Mhz.Par vent faible, Décollage, privilégier piste 10 en légère descente.et 28 pour atterrissage10 longer la colline par le sud. Att. ligne ULM rapide expérience exigé | 1 | herbe | '10 | 30 | 400 | '10-28 | herbe |  |  |  | 'Inconnue |  | Dépannage | 6,4,5 | Restauration à proximité, Gîte à proximité, Camping possible | funrunner3000@sfr.fr | +33 6 47 03 57 92 | Si possible, par politesse, prévenir pour être accueillis ou dépannés en carburant.Resto en été, weekend hors saison et Gite à LERAN 2 km. Camping et restauration au lac de Montbel à 5 kms en été. Camping possible sur le terrain sans commodités.Si vous n'êtes pas trop nombreux, possibilité transport et organisation des repas sur demande (demander Laurent 06 84 52 42 53).
 | LF0951 | Sarrat | Base ULM Autorisation OBLIGATOIRE | 8/03/2011 | 25/12/2015 | 14/10/2017 | 43.20859536023596, 1.708676322753945 | N 43 12 31 | E 001 42 31 | 846 ft | Par le sud Ligne PTT à 40 mètres seuil de piste ESTAttention : le terrain est très près de la D59, raccourcir la finale en 11. | 1 | herbe |  | 30 | 300 | '11-29 | herbe |  |  |  | 'Inconnue | 123.500 |  |  | invalid | gaston.dejean@orange.fr | +33 5 61 69 41 91 | Aéromodélisme sur site (activité 9075, plafond 500ft) et à proximité (activité [en cours], plafond 500ft ASFC)
 | LF0952 | Fabas | AltiSurface en service | 27/05/2013 | 22/10/2015 | 24/10/2015 | 43.110407844557, 1.1159371058146235 | N 43 06 37 | E 001 06 57 | 1299 ft | Tour de piste au sud, main gauche.Atterrissage possible uniquement en 31. Pente montante entre 1 et 6 %.Ligne électrique surplombant le seuil 13 et le haut de la plate-forme. | 1 | herbe | '31 | 20 | 400 | '13-31 | herbe |  |  |  | 'Inconnue | 130.00 | Aucun |  |  |  | +33 5 61 04 60 19 | Avions : Qualification Montagne requise.ULM : Libre d'accès.PILOTES ULM : Pour votre sécurité et pour obtenir les dernières consignes, veuillez contacter le PNVM (Pôle National Vol Montagne) au 0698282850 ou 0683512668.Se renseigner sur le fauchage avant de se poser.
 | LF0953 | Ustou | AltiSurface en service | 4/12/2013 | 25/12/2015 | 16/02/2016 | 42.781388833333, 1.2258328333334703 | N 42 46 53 | E 001 13 33 | 5896 ft |  | 1 | neige |  | 30 | 250 | '16-34 | herbe |  |  |  | 'Inconnue |  |  |  |  |  | +33 6 78 78 94 64 | Avions : Qualification Montagne requise.ULM : Libre d'accès.PILOTES ULM : Pour votre sécurité et pour obtenir les dernières consignes, veuillez contacter le PNVM (Pôle National Vol Montagne) au 0698282850 ou 0683512668.
 | LF0954 | Ercé | Base ULM ouverte tous types | 4/02/2014 | 11/02/2017 | 13/02/2017 | 42.851111111111, 1.2972222222222172 | N 42 51 04 | E 001 17 50 | 3000 ft | Piste de type altisurface.Après passage parallèle à la piste pour vérifier la présence éventuelle d'animaux, suivre l'axe de la vallée pour s'intégrer en longue finale 13.Possibilité de remise des gaz pour dégagement vers la vallée. | 1 | herbe | '13 | 20 | 280 | '13-31 | herbe |  |  |  | 'Inconnue | 130.00 |  | 4 | Gîte à proximité | c.koch@klima.fr | +33 6 25 89 70 84 | Piste ULM (INTERDITE AUX AVIONS)Expérience Montagne impérative.Très bon état de surface. Axe de la piste décalé. Faire une approche avec du moteur jusqu'au seuil de piste. Pente de 5% sur la première partie de la piste puis de 15% sur les 100 derniers mètres. Nos gîtes: (http://ariege-gite.com). Nous fournissons un véhicule pour les locataires arrivés par ulm.
 | LF1021 | Montardoise | Aérodrome Privé Ouvert aux ULM | 22/09/2011 | 24/12/2015 | 26/01/2016 | 48.468027334654145, 4.1977643966674805 | N 48 28 05 | E 004 11 52 | 580 ft | Tour de piste au Sud avions 700 ft ULM 500 ft Le seuil 24 est préférentiel (piste en pente). | 1 | herbe | '24 | 40 | 800 | '05-23 | herbe |  |  |  | 'Inconnue | auto-info 123.5 |  |  |  |  | +33 3 25 37 50 28 | PPR par tél. 03 25 37 50 28 - fax 03 25 37 50 27
 | LF1022 | Ville sur Arce | Aérodrome Privé Ouvert aux ULM | 8/03/2011 | 24/12/2015 | 26/01/2016 | 48.088211340842, 4.4359163438721225 | N 48 05 18 | E 004 26 09 | 910 ft |  | 1 | herbe |  |  | 650 | '11-29 | herbe |  |  |  | 'Inconnue |  |  |  |  |  | +33 3 25 38 76 46
oui | LF1052 | Plancy - La Caroline | Base ULM Autorisation OBLIGATOIRE | 9/03/2011 | 9/03/2011 | 0/00/0000 | 48.588056, 3.993333 | N 48 35 17 | E 003 59 36 | 276 ft |  | 1
 | LF1054 | Viapres le petit | Base ULM Autorisation OBLIGATOIRE | 22/09/2011 | 5/08/2015 | 25/08/2015 | 48.572778, 4.035556 | N 48 34 22 | E 004 02 08 | 250 ft |  | 1 | herbe |  | 0 | 850 | '02-20 | herbe |  |  |  | 'Inconnue | 123.5 |  |  |  | dmaitrot@gmail.com | +33 3 25 37 71 09 | Attention : Nouvelle Plateforme, pas encore validee ...
 | LF1055 | Romilly | Base ULM Autorisation OBLIGATOIRE | 25/09/2011 | 24/12/2015 | 26/01/2016 | 48.500113859894, 3.7542343139648438 | N 48 30 00 | E 003 45 15 | 256 ft | TDP au sud 500 ft. Attention: paramoteurs majoritaires sur la plateforme. Évitez le survol des communes avoisinantes.Aéromodélisme à 800m au sud-est de la piste: 1500 ft ASFC | 1 | herbe |  | 40 | 350 | '10-28 | herbe |  |  |  | 'Inconnue | 123.5 | 95:600m,98:2 km | 6,2,5 | Restauration à proximité, Hangar possible, Camping possible | ulm.romilly@free.fr | +33 6 60 50 70 83 | Avoir autorisation du président ou son représentant légal. PPR obligatoire, demande sur le site internet du club.(http://altitude10000.free.fr) ATTENTION, importants travaux autour de la plateforme.
 | LF1056 | Amance | HydroSurface Restreinte Autorisation OBLIGATOIRE | 1/06/2014 | 24/02/2016 | 29/02/2016 | 48.350833333333, 4.5049999999999955 | N 48 21 03 | E 004 30 18 | 430 ft | Eviter survol barrage et villages voisins.L'arrêté précise : Bande d'envol : forme rectangulaire de 150 m par 40 m orientée sensiblement 050°/230° inscrite dans une zone de 600 m de diamètre. | 1 | eau |  | 40 | 150 | '05-23 | herbe |  |  |  | 'Inconnue | Auto info 123.5 |  | 3,4,5 | Restauration sur place, Gîte à proximité, Camping possible | aube.ulm@wanadoo.fr | +33 6 08 24 19 06 | Autorisation requise auprès du responsable de l'école Aube ULM-Ecole des Lacs : Salvatore Rusciani. Posé à Brienne-le-Château préalable pour briefing spécifique.Ouverture avril à octobre.Cale dans le port de Dienville, large et accessible pour remontée à sec.Sur place : restauration, Camping avec possibilité location bungalows.
 | LF1123 | Baraigne | Base ULM Accès privé | 2/08/2011 | 25/12/2015 | 4/02/2016 | 43.323429352646, 1.833643913269043 | N 43 19 24 | E 001 50 01 | 920 ft | Tour de piste au sud, éviter le survol des villages de Baraigne et Molleville.Vent fréquent. Fortes turbulences par vent d'autan piste 11 | 1 | herbe |  | 15 | 280 | '11-29 | herbe |  |  |  | 'Inconnue | 123.45 |  | 6 | Restauration à proximité | ballester.pc@orange.fr | +33 6 49 20 46 77 | Extrémité piste 11 inclinée, prudence !Turbulences piste 11 par vent d'autan.Prudence renforcée si arrosage des terrains agricoles en prolongement pistes en raison des rampes et tuyauteries.
 | LF1125 | Nébias | Base ULM Autorisation OBLIGATOIRE | 8/03/2011 | 22/05/2017 | 24/05/2017 | 42.89174527056504, 2.123718399471727 | N 42 53 30 | E 002 07 25 | 1830 ft | Tour de piste au sud des installations non survol du village. Aérodrome à usage restreint PUIVERT (123.50) à proximité. | 1 | herbe |  | 25 | 370 | '11-29 | herbe |  |  |  | 'Inconnue | Auto info 123.50 |  | 6,4 | Restauration à proximité, Gîte à proximité | bostvironnois.m@orange.fr |  | La piste est à 800m du village.
 | LF1151 | Fleury d'Aude | Base ULM Accès privé | 28/09/2011 | 25/12/2015 | 4/02/2016 | 43.21356380866496, 3.129965469572312 | N 43 12 49 | E 003 07 48 | 100 ft | Eviter le survol à basse altitude des domaines et de la zone industrielle de Fleury.La Base est implantée au sud de la TMA 7 de Montpellier (zone D 1500/FL 115).Verticale installations à 1400ft QNH avant intégration en tour de piste à 600 ft QNH | 2 | herbe | '30 | 20 | 320 | '12-30 | herbe |  | 15 | 270 | '14-32 | 123.5 | NON |  |  | michel-tomas@orange.fr | +33 5 61 76 38 91 | Intégration verticale terrain à 1400ft/QNH, rejoindre début vent arrière dans l'ouest du tour de piste, descendre à 600ft/QNH en virage retour vers vent arrière (voir photos 2 et 3)Avant de venir vous poser, informez le propriétaire gestionnaire pour autorisation et conseils (voir infos administratives).Les pistes sont bordées de fossés, soyez prudents.Évitez le survol des domaines et de la zone artisanale.
 | LF1153 | Limoux | Base ULM Autorisation OBLIGATOIRE | 8/03/2011 | 25/12/2015 | 4/02/2016 | 43.057088147281, 2.226425216918983 | N 43 03 26 | E 002 13 35 | 660 ft | Tours de piste côté Est. Ne pas survoler la ville. Attention fortes turbulences par vent d'ouest. | 1 | herbe |  | 40 | 300 | '01-19 | herbe |  |  |  | 'Inconnue | 123.450 |  |  |  |  | +33 6 62 21 23 90
 | LF1156 | Ulm Saint Couat | Base ULM Accès privé | 15/08/2011 | 13/02/2016 | 15/02/2016 | 43.211181528418, 2.64646053314209 | N 43 12 40 | E 002 38 47 | 307 ft | Tour de piste 500ft AAL (800 ft QNH)au NordPas de survol d'agglomérations ou d'habitation isolée. Reconnaissance verticale 1000 ft AAL (1300 ft QNH) obligatoire. Approches directes interdites. Auto information radio recommandée | 1 | herbe |  | 20 | 240 | '08-26 | herbe |  |  |  | 'Inconnue | 123.5 | Sur demande | 2,5,1 | Hangar possible, Camping possible, Atelier ULM | jeanpierre.ferchal@nordnet.fr | +33 4 68 77 51 16 | Avant de venir : prévenir Mr FERCHAL Jean-Pierre, propriétaire gestionnaire (voir infos administratives).Le site est très agréable. Atelier mécanique sur place.
oui | LF1157 | Quéribus 900 | Base ULM fermée définitivement | 4/04/2012 | 25/12/2015 | 19/06/2016 | 42.85125228048874, 2.5893644735548316 | N 42 51 05 | E 002 35 22 | 950 ft |  | 1 | terre |  | 22 | 215 | '14-32 | herbe |  |  |  | 'Inconnue | Auto-info 123.5 |  |  |  |  | +33 6 28 63 55 26 | Attention, très difficile d'accès (encaissé au fond de la vallée).Impératif : Se renseigner auprès du gestionnaire sur l'état de la piste avant de venir.
 | LF1158 | Beaugaillard | Aérodrome Privé Ouvert aux ULM | 23/05/2014 | 25/12/2015 | 4/02/2016 | 43.178611111111, 1.951666666666597 | N 43 10 43 | E 001 57 06 | 930 ft | Circuit à 700 ft sol. Ce terrain est situé sous la R46 N1.Inutilisable pendant les heures d'activité de la zone.Eviter le survol des zones habitées cerclées de rouge sur la carte. | 1 | herbe |  | 30 | 600 | '16-34 | herbe |  |  |  | 'Inconnue |  | Aucun | 2 | Hangar possible |  | +33 4 68 24 74 18 | Accord impératif du propriétaire Mr Gabriel Blanc.
 | LF1159 | Argeliers | Base ULM Privé Avec Restrictions Autorisation OBLIGATOIRE | 9/08/2014 | 19/03/2017 | 12/10/2017 | 43.308333333333, 2.8933333333333167 | N 43 18 30 | E 002 53 36 | 140 ft | Le circuit d'aérodrome s'effectue impérativement au sud de la piste et à une hauteur de 500 ft ASFCLa plate forme ULM est située dans un espace aérien de classe G, mais sous la zone TBA R46 E2 dont les limites vont de 800 ft ASFC à 2800 ft QNH. | 1 | herbe |  | 20 | 400 | '09-27 | herbe |  |  |  | 'Inconnue | 123.5 auto information | non | 6,4,5,1 | Restauration à proximité, Gîte à proximité, Camping possible, Atelier ULM | jp.sedent@free.fr | +33 4 68 65 34 93 | De classe UA, la plateforme d'Argeliers est réservée aux membres des associations ULM 'Les Ailes Argeliésoises' et Aéromodélisme 'Les Ailes du Sud' (activité 9546) ainsi qu'à leurs invités autorisés.Intense activité parapentiste à proximité de la piste : voir et éviter !Survol des habitations d'Argeliers interdit en dessous de 1700ft ASFC.Piste ULM fermée lorsque les zones E1 et E2 de la R46 sont actives.Consultez le site du SIA avant le vol.
 | LF1222 | La Brousse Golinhac | Aérodrome Privé Ouvert aux ULM | 8/03/2011 | 10/12/2016 | 12/12/2016 | 44.581002244498, 2.591360481506399 | N 44 34 52 | E 002 35 29 | 2185 ft | La piste présentant un dénivelé d'environ 5%, par vent nul ou faible l'atterrissage se fera en 31.la piste est en bordure Est (et non Ouest) du chemin. | 1 | herbe | '31 | 25 | 550 | '13-31 | herbe |  |  |  | 'Inconnue |  |  | 4 | Gîte à proximité | airmike@wanadoo.fr | +33 5 65 44 63 79 | A 500 m à l'est du hameau de la Brousse, au lieu-dit 'La Lande'Hébergement 'cabanes' dans les arbres à 300 mhttp://www.lescabanesdelo.fr/ réservation 06 71 62 32 40 - lescabanesdelo@gmail.com
oui | LF1224 | Saint Rome du Tarn | Base ULM fermée définitivement | 8/03/2011 | 8/03/2011 | 12/12/2013 | 44.038056, 2.903332999999975 | N 44 02 17 | E 002 54 12 | 1818 ft |  | 1 | herbe |  | 0 | 350 | 'Inconnue |  |  |  |  |  |  |  |  |  | campingdelacascade@wanadoo.fr | +33 6 08 98 16 91
 | LF1225 | Graissac le Faula | Aérodrome Privé Ouvert aux ULM | 8/03/2011 | 18/07/2016 | 21/07/2016 | 44.770830202424534, 2.788560074096722 | N 44 46 15 | E 002 47 19 | 2800 ft | Aérodrome privé de type altisurface.Att. 13 - Déco. 31 - TDP main GauchePas d'atterrissage si pas de manche à air (piste non praticable)Attention :seuil 13. ligne PTT seuil 31.Ligne HT à 300 m au sud | 1 | herbe | '13 | 20 | 550 | '13-31 | herbe |  |  |  | 'Inconnue | 123.5 |  |  |  | emazard@club-internet.fr | +33 5 65 66 43 66 | PPR obligatoire + contact la veille pour vérifier la disponibilité de la piste.Possibilité de visiter le moulin à eau du XVème siècle sur place.
 | LF1226 | Thérondels Douzalbats | Aérodrome Privé Ouvert aux ULM | 8/03/2011 | 24/09/2016 | 25/09/2016 | 44.892996521416, 2.718152740722644 | N 44 53 35 | E 002 43 05 | 3068 ft | Tour de piste de préférence au sud face au hangaratterrissage 08 main droitedécollage en 26 | 1 | herbe | '08 | 75 | 600 | '08-26 | herbe |  |  |  | 'Inconnue |  |  | 6,2,4 | Restauration à proximité, Hangar possible, Gîte à proximité |  | +33 6 11 81 88 50 | pente 3 %voie militaire basse altitude fréquents (R593)gite et repas chez mr Jean-François Miquel à 4 km membre du clubAiles du Carladez tél 05 65 66 02 72 fax 05 65 66 19 84(au 20/09/2016 , fermeture pour 3 mois )
 | LF1231 | Villefranche de Panat | HydroSurface Restreinte Autorisation OBLIGATOIRE | 8/03/2011 | 12/03/2016 | 14/03/2016 | 44.09926473604485, 2.6951764603271613 | N 44 05 57 | E 002 41 43 | 2385 ft | Eviter survol habitations et camping | 1 | eau |  |  |  | 'omnidir | herbe |  |  |  | 'Inconnue | Auto-info 123.5 | SP95/98 500m | 3,4 | Restauration sur place, Gîte à proximité | paul.dellac@wanadoo.fr | +33 6 76 08 34 79 | Ponton et plage disponibles, slip étroit réservé Wheed de l'association Air des Lacs.Accès réservé usagers ou aéronefs autorisés par gestionnaire Paul Dellac.Vérifier auprès gestionnaire si niveau du barrage compatible avec activité avant tout vol.Gîte pour 6 personnes disponible à proximité, renseignements auprès de l'association Air des Lacs.Bar restaurant sur place au bord du lac ouvert en saison.
 | LF1232 | Ste Croix | Base ULM Autorisation OBLIGATOIRE | 17/08/2011 | 19/12/2015 | 27/12/2015 | 44.413888888889, 1.9433333333333849 | N 44 24 50 | E 001 56 36 | 1128 ft |  | 1 | herbe |  | 0 | 265 | '12-30 | herbe |  |  |  | 'Inconnue |  |  |  |  | Marie-josee.ricard@wanadoo.fr
 | LF1233 | Sarrans Cantoin | Base ULM Autorisation OBLIGATOIRE | 18/05/2011 | 24/09/2016 | 26/09/2016 | 44.82610843303149, 2.8432059288024902 | N 44 49 34 | E 002 50 36 | 3140 ft | Merci de bien respecter les seuils de pistes décalés.Merci de faire le tour de piste par le nord Attention à l'activation de la LF-R590B | 1 | herbe | '08 | 30 | 460 | '08-26 | herbe |  |  |  | 'Inconnue | Auto info 123.5 | SP98 S/demande | 6,2,4,5 | Restauration à proximité, Hangar possible, Gîte à proximité, Camping possible | basc@sfr.fr | +33 6 78 37 72 44 | Nous pouvons vous proposer de l?essence sur demande.Hangar possibleIl y a une table de pique nique avec un barbecueOn peut vous proposer des vélos pour de petits déplacements (restaurants, épicerie à 1500 mètres, gite à partir de 500 mètres).Ecole d'attelage de l'AubracNicolas et Pascale Perrain +33 6 88 12 30 34Pour plus d'infos, n'hésitez pas contacter Olivier au 06.78.377.244 ou à consulter www.basc.fr
 | LF1251 | Bozouls | Base ULM Autorisation OBLIGATOIRE | 25/08/2011 | 24/08/2017 | 26/08/2017 | 44.478112739021185, 2.747279405593872 | N 44 28 41 | E 002 44 50 | 1991 ft | Tour de piste au nord entre 600 et 800Ft/sol éviter de survoler les villages à basse altitude.Roulage sur les pistes et taxiway uniquement (sinon risque de crevaison). | 2 | herbe |  | 25 | 375 | '11-29 | herbe | '36 | 22 | 210 | '18-36 |  | sur demande | 3,2,4,5 | Restauration sur place, Hangar possible, Gîte à proximité, Camping possible | laissac.utilitaire@wanadoo.fr | +33 06 80 26 65 31 | Restauration et gîtes en ville (Bozouls).Si vous voulez ravitailler en carburant : prévenir par téléphone.
 | LF1254 | Saint Félix de Lunel | Base ULM Autorisation OBLIGATOIRE | 8/03/2011 | 18/07/2016 | 22/07/2016 | 44.562558342778, 2.5420103227538675 | N 44 33 45 | E 002 32 31 | 1900 ft | Contact téléphonique OBLIGATOIREAtterrissage uniquement en 18Expérience montagne indispensableTour de piste à l'Est. | 1 | herbe | '18 | 50 | 290 | '18-36 | herbe |  |  |  | 'Inconnue |  |  | 6 | Restauration à proximité |  | +33 5 65 44 64 90 | Plateforme privée, PPR à Mr Didier Quintard, Maison longue,12320 St-Félix-de-Lunelphone : 05 65 44 64 90.
 | LF1255 | Barrage de Pareloup | HydroSurface Restreinte Autorisation OBLIGATOIRE | 1/08/2011 | 25/02/2016 | 29/02/2016 | 44.207865351665, 2.722806930541992 | N 44 12 28 | E 002 43 22 | 2635 ft | Accès réservé aux pilotes ayant obtenu l'accord du gestionnaire Paul Dellac.Forte activité nautique en saison.Vérifier niveau lac avant tout amerrissage. | 1 | eau |  | 0 | 0 | 'omnidir | herbe |  |  |  | 'Inconnue | auto-info 123.5 |  | 3 | Restauration sur place | paul.dellac@wanadoo.fr | +33 6 76 08 34 79
 | LF1301 | Martigues-Henri Fabre | HydroSurface Restreinte Autorisation OBLIGATOIRE | 11/11/2013 | 27/02/2016 | 29/02/2016 | 43.420833333333334, 5.077777777777783 | N 43 25 15 | E 005 04 40 |  |  | 1 | eau |  |  | 1000 | 'omnidir | herbe |  |  |  | 'Inconnue |  |  | 6 | Restauration à proximité | yves.kerherve@hydroclubdefrance.fr |  | Interdit aux aéronefs non autorisés par l'Hydro-Club de France suivant le protocole SNA-SSE/Mairie de Martigues. Demande à adreser à Yves Kerhervé (mail rubrique 'infos administratives').Transpondeur et radio obligatoires.
oui | LF1351 | Tarascon | Base ULM Fermée temporairement | 8/03/2011 | 7/07/2015 | 6/08/2015 | 43.779167, 4.688889 | N 43 46 45 | E 004 41 20 |  |  | 1 | herbe |  |  |  | 'Inconnue | herbe |  |  |  | 'Inconnue
 | LF1352 | Jouques Bèdes | Base ULM Accès limité Autorisation OBLIGATOIRE | 27/07/2011 | 16/06/2017 | 17/06/2017 | 43.66141709774461, 5.686849056879737 | N 43 39 41 | E 005 41 13 | 1378 ft | TdP 02 & 20 main gauche.Ligne HT à 680 m du seuil 20, venir à la hauteur de la ligne, le pylône est dans l?axe pour la finale.En finale 20 ne pas avoir peur de descendre dans la trouée des arbres.En 02, seuil décalé, poser juste avant la bosse. | 1 | herbe | '20 | 30 | 360 | '02-20 | herbe |  |  |  | 'Inconnue | Auto-info 123.500 | Non | 4,5 | Gîte à proximité, Camping possible | chrispiccioli@aol.com | +33 6 98 28 28 50 | Cause voisinage, nbre de mouvements limités. Contact OBLIGATOIRE avec le gestionnaire avant utilisation au 06 98 28 28 50 (Christian PICCIOLI, APUJ).06 03 68 08 17 (André ADAOUST, propriétaire)Attention: Zone P10 Cadarache à proximité. Pénétration interdite (voir cartes aéronautiques).Éviter le survol de la ferme de la Grande Séouve (vignoble, voir photos).Pour pilotes confirmés, utilisation de la piste sous leur entière responsabilité.
 | LF1353 | La Ciotat | HydroSurface Restreinte Autorisation OBLIGATOIRE | 7/06/2012 | 27/02/2016 | 29/02/2016 | 43.173717155752, 5.641388888888855 | N 43 10 25 | E 005 38 29 |  |  | 2 | eau |  |  | 1500 | 'omnidir | eau |  |  | 1500 | 'omnidir | Auto info 123.500 |  |  |  | charles.schmitt@bbox.fr |  | Contacter Charles Schmitt avant toute utilisation.Ne pas pénétrer la zone des 300m du rivage.
 | LF1354 | Meyrargues | Base ULM Privé Avec Restrictions Autorisation OBLIGATOIRE | 9/07/2014 | 16/06/2017 | 17/06/2017 | 43.65258903944826, 5.525111571417938 | N 43 39 09 | E 005 31 30 | 650 ft | Tour de piste au Nord pour les deux QFU.Si activité paramoteur en cours atterrissage interdit sauf si contact établi avec paramotoristes, si des voiles sont au sol faire un.passage verticale et début de vent arrière pour indiquer vos intentions | 1 | herbe | '27 | 25 | 400 | '09-27 | herbe |  |  |  | 'Inconnue | 123.5 |  | 6,4 | Restauration à proximité, Gîte à proximité | chrispiccioli@aol.com | +33 6 98 28 28 50 | Haie d'arbres avec trouée de 20m de large à l'entrée de piste 09. Seuil décalé de 20m au QFU 09. Après atterrissage en 27 soit remonter la piste soit dégager par la droite en longeant la piste pour venir vers le parking.Ligne HT à 500m au Nord de la piste, parallèle à celle ci et à l'autoroute.SECOURS : Sapeurs à Meyrargues (3Km) tél 18 ou112 coordonnées DFCI KD 44 K7/5.Gendarmerie à PEYROLLES (5Km).Essence et vélos possibles sur PPR.
 | LF1355 | Marseille Hydro | HydroSurface Réglementé Ouvert aux ULM Utilisation EPISODIQUE | 24/08/2015 | 27/02/2016 | 29/02/2016 | 43.299090809831, 5.3476119995117415 | N 43 17 57 | E 005 20 51 |  |  | 1 | eau |  | 1000 | 1000 | 'omnidir | herbe |  |  |  | 'Inconnue |  |  | 3,6,4 | Restauration sur place, Restauration à proximité, Gîte à proximité | jfmonier@hydroclubdefrance.fr | +33 6 70 27 50 40 | Usage occasionnel, réservé aux participants de manifestations aériennes, interdit le reste du temps.Contacter le gestionnaire pour plus d'information.
 | LF1422 | Bonneville la Louvet | Base ULM Autorisation OBLIGATOIRE | 6/07/2011 | 23/04/2017 | 24/04/2017 | 49.263435841602, 0.3717219829559326 | N 49 15 48 | E 000 22 18 | 361 ft | Piste en légère montée vers l'Est. Utiliser la '09' en priorité. Parking au seuil de la 09Participation aux frais d'entretien de la plateforme : 5 euros (interdit) | 1 | herbe |  | 0 | 300 | '08-26 | herbe |  |  |  | 'Inconnue | auto-info 123.5 |  |  |  | claude.billiau@yahoo.fr | +33 2 31 65 43 55 | PPR : Téléphoner obligatoirement avant à Claude BILLIAU pour prévenir de votre passage : 02.31.65.43.55.
oui | LF1423 | Les Goudris | Base ULM fermée définitivement | 11/10/2011 | 18/12/2013 | 24/04/2014 | 48.972893240438, -0.4210853576660156 | N 48 58 22 | W 000 25 16 | 574 ft | piste légèrement montante en 20. Ne pas survoler le village atterrir uniquement direction nord ligne téléphone au seuil de piste 20 | 1 | herbe | '20 | 25 | 230 | '02-20 | herbe |  |  |  | 'Inconnue | 123.5 | 5 km |  |  |  | +33 2 31 82 21 02
 | LF1451 | Courseulles sur Mer | Base ULM Autorisation OBLIGATOIRE | 3/08/2011 | 17/08/2016 | 19/08/2016 | 49.314136253969, -0.4532071534423494 | N 49 18 51 | W 000 27 12 | 150 ft | Tour de piste au sud. Piste 09-27 de 360m en légère montée au début.QFU préférentiel 09. above). Circuits to the South at 500'sfc. 3 grass runways, with little or no wind, use rwy 09. Petrol station 600 meters 24hrs/a day with a pin card. | 2 | herbe | '09 | 0 | 350 | '09-27 | herbe |  | 0 | 200 | '06-24 | 123.5 | à proximité | 6 | Restauration à proximité | martial.hulmel@wanadoo.fr | +33 6 75 02 48 14 | Tel si possible à Martial HULMEL (06 75 02 41 18) pour annoncer votre passage. Zone sensible car touristique (beaucoup de résidences secondaires), soyez discrets. Survol de Courseulles interdit. Respectez la hauteur de vol sur les plages. Ne pas approcher de trop près la commune de Reviers (au sud-ouest de la base), en ne passant pas au sud des lagunages.Participation aux frais d'entretien de la plateforme : 5 euros (interdit)
 | LF1452 | La Boissière | Aérodrome Privé Avec Restrictions Autorisation OBLIGATOIRE | 8/03/2011 | 4/06/2017 | 6/06/2017 | 49.125, 0.14250000000004093 | N 49 07 30 | E 000 08 33 | 540 ft |  | 1 | herbe |  | 20 | 900 | '04-22 | herbe |  |  |  | 'Inconnue |  |  |  |  |  | +33 9 77 84 93 65 | Stricte autorisation préalable du propriétaire pour venir y atterrir. Un aérodrome privé est une 'propriété privée'. Tous ceux qui respectent rigoureusement ces consignes y seront fort bien accueillis.fax 09 77 84 93 65
 | LF1454 | Rouvres | Base ULM Autorisation OBLIGATOIRE | 8/03/2011 | 15/11/2015 | 22/11/2015 | 49.019909074562, -0.19828818518067237 | N 49 01 12 | W 000 11 54 | 345 ft | Tours de piste côté est, hangar, manche à air. | 1 | herbe |  |  | 280 | '02-20 | herbe |  |  |  | 'Inconnue |  |  |  |  |  | +33 2 31 78 11 48 | Propriétaire Mr Pierre Michel, 14190 St-Sylvain, phone: 02 31 78 11 48. Visiteurs ULM bienvenus.
oui | LF1455 | Victot Bouttemont | !! Type de terrain mal défini !! | 24/06/2012 | 1/03/2014 | 3/03/2014 | 49.16771991092875, 0.00025281906130203424 | N 49 10 04 | E 000 00 01 | 33 ft | Cet aérodrome privé n'existe plus, le propriétaire a vendu son domaine. | 1 | herbe | '24 | 30 | 1000 | '06-24 | herbe |  |  |  | 'Inconnue | 123.5 |  |  |  |  |  | Cet aérodrome n'existe plus, le propriétaire a vendu son domaine.
 | LF1456 | Omaha Beach | Base ULM Accès privé | 22/06/2015 | 30/01/2016 | 25/02/2016 | 49.353137534727, -0.8428861414947733 | N 49 21 11 | W 000 50 34 | 203 ft | Tour de Piste 800 Pieds QNH à l'Est des installations.Survol du Cimetière Militaire Américain à proximité à l'ouest interdit en dessous de 3000 Pieds QNH (Rassemblement de personnes).Seuil décalé en 35, arbres au Sud. | 1 | herbe | '35 | 20 | 240 | '17-35 | herbe |  |  |  | 'Inconnue | 123.500 MHz |  | 3,6,2,4,5 | Restauration sur place, Restauration à proximité, Hangar possible, Gîte à proximité, Camping possible | cavalomaha@aol.com | +33 6 89 66 52 41 | Ecole de Pilotage 3axes autogire Travail Aérien LIBAIRTY AIR CLUB 07 83 22 87 97
 | LF1457 | ZTN AIR | Base ULM Autorisation OBLIGATOIRE | 21/08/2016 | 25/08/2016 | 27/08/2016 | 49.031505248916, 0.036048495800741875 | N 49 01 53 | E 000 02 10 | 102 ft | Tour de piste au sud quelle que soit la piste utilisée | 1 | herbe | '31 | 20 | 300 | '13-31 | herbe |  |  |  | 'Inconnue | nil | nil |  |  | yberl@wanadoo.fr | +33 6 30 09 56 96 | SUR AUTORISATION PRÉALABLE SEULEMENT tour de piste impératif au sud quelle que soit la piste utilisée
oui | LF1521 | La Taillade | Altisurface fermée | 8/03/2011 | 6/12/2013 | 10/12/2013 | 44.891667, 2.956944444444389 | N 44 53 30 | E 002 57 25 | 2913 ft | Atterrissage en 23 par un tour de piste par la droite (côté Ouest). Approche et courte finale au cap 220 (donc de travers) puisque l'espace est dégagé, et à l'arrondi prendre à gauche pour l'axe 23. Pente montante en 23 sur 215m de 9 à 18%. | 1 | herbe | '21 | 30 | 255 | '05-23 |  |  |  |  |  |  |  |  |  |  | +33 4 71 23 80 13 | PPR à Mr Christophe Brun, la Taillade, 15260 Neuveglise, phone: 04 71 23 80 13, fax: ~23 86 94. Par la PPR, bien se renseigner sur la praticabilité (état de surface variable) de l'altisurface qui est d'utilisation délicate Superbe et magnifique endroit, isolé de tout, surplombant de 220m les gorges de la Truyère...
 | LF1522 | Trizac | Base ULM fermée temporairement | 8/03/2011 | 14/09/2015 | 4/10/2015 | 45.268333, 2.548055999999974 | N 45 16 06 | E 002 32 53 | 3300 ft | non praticable beaucoup de rats taupiers | 1 | herbe |  |  | 390 | '13-31 | herbe |  |  |  | 'Inconnue |  |  |  |  |  | +33 4 71 40 35 57
oui | LF1524 | Landeyrat Les Chamasses | Base ULM fermée définitivement | 8/03/2011 | 2/07/2015 | 24/07/2015 | 45.284167, 2.858333 | N 45 17 03 | E 002 51 30 | 3739 ft |  | 1 | herbe |  |  | 300 | 'Inconnue | herbe |  |  |  | 'Inconnue |  |  |  |  |  |  | pas évident sur Google Earth ?!? grande prairie
 | LF1525 | Polminhac | Base ULM Autorisation OBLIGATOIRE | 8/03/2011 | 10/11/2015 | 4/12/2015 | 44.942710294183, 2.57757320237738 | N 44 56 34 | E 002 34 39 | 2090 ft |  | 1 | herbe |  |  |  | '04-22 | herbe |  |  |  | 'Inconnue |  |  |  |  |  | +33 6 35 34 09 63
oui | LF1551 | Sion Le Vigean | Base ULM fermée définitivement | 9/03/2011 | 9/03/2011 | 18/03/2013 | 45.220556, 2.384166999999934 | N 45 13 14 | E 002 23 03 | 2460 ft |  | 1 | herbe |  |  |  | '00-00
 | LF1552 | Le Peuch | Aérodrome Privé Ouvert aux ULM | 6/11/2011 | 24/12/2015 | 19/01/2016 | 44.9002447598591, 3.10656055026584 | N 44 54 01 | E 003 06 24 | 3000 ft | Atterrissage en 35, décollage en 17. | 1 | herbe | '35 | 20 | 300 | '17-35 | herbe |  |  |  | 'Inconnue | Auto-info 123.5 |  |  |  |  | +33 6 71 92 10 65 | Alexandre Portal accueille chaleureusement avions et ULM qui lui ont téléphoné au 04 71 23 58 48 ou 06 71 92 10 65
 | LF1553 | Le Bruel | Base ULM Accès privé | 12/11/2011 | 23/08/2017 | 24/08/2017 | 44.742953649707, 2.2003555297851562 | N 44 44 35 | E 002 12 01 | 1427 ft | Atterrissage obligatoire en 36. Décollage obligatoire en 18. | 1 | herbe | '36 |  | 300 | '18-36 | herbe |  |  |  | 'Inconnue | 123.5 | Non |  | invalid |  | +33 6 23 20 03 43 | Déclivité montante de 7% dans le sens atterrissage Sud-Nord.Information à l'avance du propriétaire recommandée au 06 23 20 03 43
oui | LF1622 | Confolens | Base ULM fermée définitivement | 8/03/2011 | 25/11/2013 | 10/12/2013 | 46.024722, 0.6666669999999613 | N 46 01 29 | E 000 40 00 |  | Un pilote signale qu'il n'a pas retrouve cette plate-forme lors d'un vol récent ! ... | 1 | herbe |  | 0 | 570 | 'Inconnue
oui | LF1623 | Massignac | Base ULM Accès privé | 9/03/2011 | 9/03/2011 | 25/09/2012 | 45.766667, .641667 | N 45 46 00 | E 000 38 30 | ft |  | 1 | herbe |  |  | 840 | '00-00
oui | LF1624 | Parzac | Aérodrome Privé Interdit aux ULM Autorisation OBLIGATOIRE | 8/03/2011 | 8/03/2011 | 7/12/2013 | 45.908056, .45 | N 45 54 29 | E 000 27 00 | 480 ft | Aérodrome réservé au propriétaire compte tenu des restrictions mentionnées à la rubrique 'Piste' | 1 | herbe |  |  | 300 | '11-29 |  |  |  |  |  |  |  |  |  | jmgdu@club-internet.fr | +33 6 12 79 04 11
 | LF1625 | Pillac | Base ULM Accès privé | 29/06/2011 | 26/12/2015 | 21/02/2016 | 45.33176941035283, 0.1847076416015625 | N 45 19 54 | E 000 11 05 | 335 ft | Piste ULM privée en montée et légèrement ondulée. Utiliser comme une altisurface. Atterrissage en 15Décollage en 33. Située sous la R49A (Cognac), plafond 3000ft AMSL | 1 | herbe | '15 | 40 | 320 | '15-33 | herbe |  |  |  | 'Inconnue | Auto info 123.500 |  |  |  | lesvergersdumarais@wanadoo.fr | +33 6 80 83 11 29
 | LF1627 | Saint Maurice | Aérodrome Privé Ouvert aux ULM | 8/03/2011 | 6/09/2017 | 8/09/2017 | 45.96672665888322, 0.7396928941650458 | N 45 58 00 | E 000 44 23 | 755 ft | Tour de piste préférentiel 'main gauche'Turbulences possibles QFU 18 liées à la proximité d'arbresPiste en légère montée face au nordRisque obstacles gibier hors zone balisée (280m en 2017)Terrain agricole (fourrage) donc OK après les foins ! | 1 | herbe | '36 | 28 | 600 | '18-36 | herbe |  |  |  | 'Inconnue | Auto-info 123.5 | SP 98 dépannage |  | invalid | le.rhus@wanadoo.fr | +33 6 40 09 44 84 | Aérodrome privé : (PPR) autorisation préalable obligatoire ... sauf emergency évidemment !ATTENTION hors zone balisée, il y a des risques d'obstacles liés au gibier (lièvre, sanglier, cervidés, ...) : contact préalable avec le gestionnaire de l'aérodrome indispensable.Essence SP98 éventuellement disponible sous réserve de préavis. Station située à 12km.
 | LF1628 | Saint Même Les Carrières | Aérodrome Privé Ouvert aux ULM | 4/07/2011 | 21/12/2016 | 22/12/2016 | 45.632255850683, -0.1572418212890625 | N 45 37 56 | W 000 09 26 | 82 ft | Aérodrome situé à la limite de la CTR de classe D de Cognac. Activité TLJ même Base 709 active - Contacter 122.55Voir 'Observations'Tour de piste 12-30 côté SudPiste 01-19 réservée aux ULM et Paramoteurs (seuil 01) | 2 | herbe | '30 | 30 | 500 | '12-30 | herbe |  | 20 | 240 | '01-19 | Auto-info 123.50 | SP 98 |  |  | guy.chanrond@gmail.com | +33 5 45 81 97 11 | Autorisation par courriel guy.chanrond@gmail.com ou 06 63 34 49 57 qui envoie la procédure détaillée. Attention : travaux en cours de marquage de la piste.Contacter Cognac Approche 122.55 avant de pénétrer la CTR (D)- Base active : Entrée et Sortie : Verticale Châteauneuf à 500 ft maxi - Radio 122.55- Base inactive : Verticale terrain 1000 ft AAL - Intégration standard - Radio 123.50DANGER : Dolmen à 20 mètres nord de la piste 12-30
 | LF1629 | Saint Coutant | Base ULM Autorisation OBLIGATOIRE | 2/09/2011 | 26/12/2015 | 21/02/2016 | 46.018963066678, 0.433136522769928 | N 46 01 08 | E 000 25 59 | 600 ft |  | 1 | herbe | '21 | 15 | 330 | '03-21 | herbe |  |  |  | 'Inconnue | non |  |  |  | jmgdu@club-internet.fr | +33 6 12 79 04 11
oui | LF1630 | Messeux | Base ULM Autorisation OBLIGATOIRE | 8/03/2011 | 23/10/2015 | 3/11/2015 | 46.03531766076659, 0.3534217301635181 | N 46 02 07 | E 000 21 12 | 541 ft | Approches dégagées. Pistes courtes mais en bon état. | 1 | herbe |  |  | 230 | '13-31 | herbe |  |  |  | 'Inconnue |  |  |  |  |  |  | Pas évident sur google earth au 09.09.2015
 | LF1631 | Le Luquet | Base ULM Autorisation OBLIGATOIRE | 13/07/2011 | 26/12/2015 | 21/02/2016 | 45.6432245720101, 0.33116698265075684 | N 45 38 36 | E 000 19 52 | 400 ft | PPR : CONTACT PREALABLE IMPERATIF Jean Paul Bonnoron tél :06 70 64 23 97 Survol des habitations à éviter. Attention à la turbulence du hangar par vent d'ouest.Formation paramoteur sur la base,vérifier si piste libre. | 1 | herbe |  | 20 | 260 | '04-22 | herbe |  |  |  | 'Inconnue | Auto-info 123.5 |  |  |  | Bonnoron.jeanpaul@wanadoo.fr | +33 6 70 64 23 97
 | LF1651 | Aignes et Puyperoux | Base ULM Autorisation OBLIGATOIRE | 7/11/2011 | 17/06/2017 | 19/06/2017 | 45.46166577080965, 0.1578211784362793 | N 45 27 42 | E 000 09 28 | 619 ft | Atterrissage en 31 attention turbulences par vent de SO à N et présence d'arbres dans l'axe de piste (15 à 20 m). Piste 31 en légère descente. Tour de piste au sud à 500 pieds | 1 | herbe | '31 | 30 | 350 | '13-31 | herbe |  |  |  | 'Inconnue | auto-info 123.5 |  |  |  | baillyjf-adi@hotmail.fr | +33 9 53 28 50 97 | Terrain situé dans la LF-R 49A Cognac. Ecole de pilotage et entrainement à la votige. Plancher 900m ASL. Plafond FL 065. Activité en semaine. Contact : Cognac App 122.55.J F BAILLY (Président) 06 07 22 79 86ULM 3 axesChristophe BOREAU05 45 97 55 87 ou06 79 04 02 18Téléphone du terrain: 05 45 60 39 21.contact : alainpineau@wanadoo.fr
 | LF1652 | Brettes | Base ULM Autorisation OBLIGATOIRE | 30/06/2011 | 23/12/2015 | 5/01/2016 | 46.01124742433, 0.05255767459107119 | N 46 00 40 | E 000 03 09 | 400 ft | Vérifier l'état de la piste avant de se poser ligne électrique à l'EST en approche 25 'prudence'Piste facilement inondable après fortes pluiesÉviter impérativement le survol des habitations et du village d'Empures situé au nord du terrain. | 1 | herbe | '07 | 15 | 350 | '07-25 | herbe |  |  |  | 'Inconnue | 123.5 |  | 2 | Hangar possible | ericbaudillon@gmail.com | +33 6 51 45 56 59 | Base école ULMInstructeurs: Jean Francois PERRIER +33687154466Éviter le survol du village d'Empuré situé au nord des installations.
 | LF1653 | Saint Ciers | Base ULM Autorisation OBLIGATOIRE | 27/08/2011 | 21/12/2016 | 23/12/2016 | 45.85056482435938, 0.26517391204833984 | N 45 51 02 | E 000 15 55 | 314 ft | Tour de piste standard 500 ft.à main gauche pour la 23 et main droite pour la 05. | 1 | herbe |  | 30 | 480 | '05-23 | herbe |  |  |  | 'Inconnue | 123.55 |  | 2,1 | Hangar possible, Atelier ULM | eric.changeur@orange.fr | +33 5 45 22 22 33 | Haut-lieu de l'autogire à l'ouest de la France.Importateur des Autogires Ela Aviation.2 Instructeurs Champion du monde AutogireSiege de la Ste ROTAVIA, atelier entretien des Autogires ELA et Magny avec pièces d'origine (ancien importateur Magny).Siège du GYRO CLUB ULM CHARENTAIS
 | LF1654 | Belzagot | Aérodrome Privé Ouvert aux ULM | 1/06/2014 | 21/10/2017 | 23/10/2017 | 45.35678263258917, 0.10980805291069373 | N 45 21 24 | E 000 06 35 | 210 ft |  | 1 | herbe | '35 | 25 | 720 | '17-35 | herbe |  |  |  | 'Inconnue |  |  |  | invalid | champrose@neuf.fr | +33 6 20 14 24 31 | Monsieur Daniel Guionnet est décédé il y a un an.Le restaurant le Gasteropode est fermé.La piste existe toujours mais est à 12 Kms d'un village.
 | LF1655 | CHENOMMET | Base ULM Autorisation OBLIGATOIRE | 31/10/2015 | 24/08/2017 | 25/08/2017 | 45.9259800896402, 0.2613089179992585 | N 45 55 34 | E 000 15 41 | 330 ft | Tour de piste au Nord / Nord-Est à main gauche pour la 13 et à main droite pour la 31Pour la 31, seuil décalé à 150 m de la Départementale 102.Pensez à la Zone Réglementée LF-R49A2 utilisée par la BA 709 de Cognac | 1 | herbe | '31 | 18 | 250 | '13-31 | herbe |  |  |  | 'Inconnue | 123.500 | NON | 4,5 | Gîte à proximité, Camping possible | philippe.esteban@sfr.fr | +33 6 03 01 97 04 | - Accès par la route : 6 kms de la N10, sortie Les Maisons Rouges, direction AUNAC-sur-CHARENTE dans cette commune prendre direction COUTURE par la D102, arrivé sur le plateau, troisième route à gauche après la déchetterie.- SASU GIROMECA : +33 6 03 01 97 04 / sur devis convoyage ULM ttes distances, 100KE d'assur. ts risk pour ULM confié / réseau MagniGyro / CNFTE Niv.I - II pour Rotax.- RdV baptême de l'air : Anne TEILLET +33 6 80 18 64 34
oui | LF1721 | Archiac | Base ULM Autorisation OBLIGATOIRE | 8/03/2011 | 16/09/2015 | 3/11/2015 | 45.516667, -0.35000000000002274 | N 45 31 00 | W 000 21 00 |  |  | 1 | herbe |  |  | 350 | '05-23 | herbe |  |  |  | 'Inconnue |  |  |  |  |  |  | pas évident sur google earth au 17 sept. 2015
oui | LF1723 | Fontenet | Base ULM fermée définitivement | 9/03/2011 | 12/03/2013 | 12/03/2013 | 45.899722, -.45 | N 45 53 59 | W 000 27 00 | ft |  | 1 | herbe |  |  | 400 | '00-00
 | LF1726 | Jarnac Champagne | Base ULM Accès privé | 25/08/2011 | 26/12/2015 | 21/02/2016 | 45.55973719389, -0.41782379150390625 | N 45 33 35 | W 000 25 04 | 200 ft | Sud | 1 | herbe |  | 20 | 240 | '09-27 | herbe |  |  |  | 'Inconnue |  |  |  |  | daniel.archereau@wanadoo.fr | +33 5 46 49 53 37 | Propriétaire joignable au 05 46 49 53 37
 | LF1727 | Nantillé | Base ULM Autorisation OBLIGATOIRE | 28/10/2011 | 23/05/2016 | 25/05/2016 | 45.845555555556, -0.47833333333335304 | N 45 50 44 | W 000 28 42 | 134 ft | Tour de piste à l'est à 150 mètres sol (500 pieds AGL)Attention, au seuil de piste 04, par vent de travers sous l'influence du bois.Fossé de drainage le long de la piste côté est. Bien respecter le marquage qui le signale. | 1 | herbe | '22 | 25 | 400 | '04-22 | herbe |  |  |  | 'Inconnue | 123.500 |  | 2 | Hangar possible | lesailesdelavoieromaine@orange.fr | +33 5 46 58 25 82 | Hangar possible pour les visiteurs.contacter Jean Claude Guiberteau au 05 46 58 25 82 ou au 06 48 83 63 13
 | LF1751 | Corme Ecluse | Base ULM Autorisation OBLIGATOIRE | 7/11/2011 | 23/12/2015 | 5/01/2016 | 45.620760898908, -0.8512580394744873 | N 45 37 15 | W 000 51 05 | 98 ft | Survol des habitations à éviter donc tour de piste assez court | 1 | herbe |  | 20 | 360 | '11-29 | herbe |  |  |  | 'Inconnue | Auto-info 123.5 |  |  |  | air-ocean@royan-ulm.fr | +33 6 11 97 09 26
 | LF1752 | Aigrefeuille d'Aunis | Base ULM Autorisation OBLIGATOIRE | 14/08/2011 | 21/01/2016 | 23/01/2016 | 46.127195778419, -0.9515833854675293 | N 46 07 38 | W 000 57 06 | 110 ft |  | 1 | herbe |  | 25 | 370 | '10-28 | herbe |  |  |  | 'Inconnue | 123.5 |  |  |  | promoterre@wanadoo.fr | +33 5 46 35 66 47 | Live Webcam : à 4km dans le NNW : http://www.meteo17aunis.fr/pages/webcam.php
 | LF1753 | Le Thou | Base ULM Autorisation OBLIGATOIRE | 8/09/2011 | 24/08/2017 | 25/08/2017 | 46.086016227673, -0.9437298774719238 | N 46 05 10 | W 000 56 37 | 89 ft | Tour de piste à 150 m/solPiste 21 : seuil décalé de 150m.Bois à l'W et ligne électrifiée SNCF en entrée de piste. Attention aux rabattants par vent d'W.En cas de fort vent de travers selon l'ULM, prendre piste de secours. | 2 | herbe | '03 | 40 | 400 | '03-21 | herbe | '21 | 20 | 280 | '12-30 | 123.550 | Sur demande |  | invalid | guy.bourasseau@Wanadoo.fr | +33 6 52 71 86 49
 | LF1755 | Courçon Eol'Aunis | Base ULM Autorisation OBLIGATOIRE | 26/10/2011 | 23/12/2015 | 4/01/2016 | 46.248197977298, -0.8303368091583252 | N 46 14 54 | W 000 49 49 | 39 ft | Tour de piste au Nord impératif.QFU préférentiel : 28.Présence fréquente de paramoteurs.Évitez le survol des habitations. | 1 | herbe | '28 | 20 | 290 | '10-28 | herbe |  |  |  | 'Inconnue | 123.55 |  | 2 | Hangar possible | bernard.drappeau@gmail.com | +33 06 78 59 35 16
 | LF1756 | Bourcefranc | HydroSurface Restreinte Autorisation OBLIGATOIRE | 2/01/2012 | 25/02/2016 | 29/02/2016 | 45.872040673689, -1.1312316894531023 | N 45 52 19 | W 001 07 52 |  |  | 1 | eau |  |  |  | 'omnidir | herbe |  |  |  | 'Inconnue | Auto-info 123.5 |  |  |  |  |  | Utilisation restreinte : réservée exclusivement par arrêté à messieurs Chevrollier et Gaschet.
 | LF1757 | Arvert | Base Paramoteurs Réglementé Avec Restrictions Autorisation OBLIGATOIRE | 6/04/2015 | 23/12/2015 | 4/01/2016 | 45.750277777777775, -1.102065555555555 | N 45 45 01 | W 001 06 07 | 13 ft |  | 1 | herbe |  | 80 | 80 | 'omnidir | herbe |  |  |  | 'Inconnue |  |  |  |  | contact@paramote.com | +33 6 60 80 14 73 | Base restreinte à une règlementation. Voir sur site www.paramote.comterrain de 2 ha : 120 X 170 m
 | LF1821 | Coust Colombiers | Aérodrome Privé Ouvert aux ULM | 19/06/2011 | 24/12/2015 | 25/01/2016 | 46.679139159221, 2.574380071428095 | N 46 40 45 | E 002 34 28 | 720 ft |  | 1 | herbe |  | 20 | 480 | '06-24 | herbe |  |  |  | 'Inconnue |  |  |  |  |  | +33 2 48 63 51 36 | PPR au propriétaireMr Albert Lacombe (propriétaire d'un RV6 F-POLI basé ici)tél 02 48 63 51 36 de 21:00 à 22:00
 | LF1822 | Guilly | Aérodrome Privé Ouvert aux ULM | 8/03/2011 | 24/12/2015 | 25/01/2016 | 47.148333333333, 2.5988889999999856 | N 47 08 54 | E 002 35 56 | 574 ft | Piste située dans la CTR d'AVORD.Contact radio obligatoire à 5 mn du terrain, sur 119.7 ou 122.10Ne pas dépasser une hauteur de 500ft à moins de 5 minutes du terrain. | 1 | herbe |  | 20 | 900 | '18-36 | herbe |  |  |  | 'Inconnue |  |  |  |  | copilote@hotmail.com | +33 6 18 05 46 38
 | LF1826 | Sury en Vaux | Base ULM ouverte tous types | 24/07/2011 | 21/01/2017 | 23/01/2017 | 47.38082231076487, 2.7825450897216797 | N 47 22 51 | E 002 46 57 | 1000 ft | Piste 08 en montée. Circuit au N à 150m/sol après verticale 300m/sol Le hangar est en bordure de la route D57. Verticale avant intégration impérative, si activité montgolfière atterrissage INTERDIT. | 1 | herbe |  | 40 | 300 | '08-26 | herbe |  |  |  | 'Inconnue | auto-info 123.5 | sur demande | 6,2,5 | Restauration à proximité, Hangar possible, Camping possible | venoize@free.fr | +33 6 10 85 64 43 | 7kms au NO de Sancerre entre Sury-en-Vaux et Subligny sur la D57.Essence possible en téléphonant au +33 6 08 97 96 05Hangar possible pour un Giro.La photo 1 a été prise en direction du Nord Ouest. La photo 2 en direction du NordVols d'initiation en Savannah et en Montgolfière informations ici:http://aeroplumsancerrois.wixsite.com/ulm-sancerre
 | LF1852 | Dun sur Auron | Base ULM Autorisation OBLIGATOIRE | 8/03/2011 | 24/12/2015 | 25/01/2016 | 46.8761829589709, 2.503506611114517 | N 46 52 34 | E 002 30 13 | 515 ft | Plateforme sous les zones LF-R20 A2 contact Avord App. 119.7 et LF-R 139.Située dans les marais de Contres, la partie basse du terrain est spongieuse aprés de forte pluies. Il est déconseillé d'utiliser la 01-09. Prévenir de votre visite. | 2 | herbe |  | 20 | 350 | '15-33 | herbe |  | 20 | 250 | '01-19 | Auto-info 123.5 |  |  |  | t.mazzocato@laposte.net | +33 6 14 63 28 93 | Le club s'appelle ULM of BLUEBERRY.
 | LF1853 | Sainte Thorette | Base ULM Autorisation OBLIGATOIRE | 6/10/2011 | 24/12/2015 | 25/01/2016 | 47.075960148623, 2.2140026092529297 | N 47 04 33 | E 002 12 50 | 400 ft | Ligne EDF à l'ouest de la piste. Voir consignes sur le site web. Seuil décalé de 50m en 06 | 1 | herbe |  | 20 | 350 | '06-24 | herbe |  |  |  | 'Inconnue | 123.5 |  |  |  | club@abul.asso.fr | +33 2 48 57 13 95 | Attention un arroseur peut être en travers de la piste l'été, téléphonez au préalable.Ecolage, un appareil peut être en tour de piste.
 | LF1854 | Saint Christophe | Base ULM Autorisation OBLIGATOIRE | 8/11/2011 | 29/10/2017 | 31/10/2017 | 46.581135725756766, 2.4044409285651227 | N 46 34 52 | E 002 24 16 | 880 ft | Piste toute proche de la LF-R 139 CHER (800/3000Ft)et sous la LF-R20B3 (plancher 3000 Ft)Tour de piste vers l'EstEviter au maximum le survol des habitations proches | 1 | herbe |  | 25 | 200 | '03-21 | herbe |  |  |  | 'Inconnue | Auto-info 123.5 |  |  | invalid | herveulm@aol.com | +33 6 11 12 43 23 | CONTACTER M. H. BEAUX pour consignes particulières.
 | LF1856 | Jouet sur l'Aubois | Base ULM Accès privé | 30/11/2011 | 28/10/2017 | 30/10/2017 | 47.0423390066636, 2.9951047897338867 | N 47 02 32 | E 002 59 42 | 640 ft | Tour de piste au sud , éviter le survol des habitations.Axe 25 : Approche par l'est (repère: cimetière) Piste en légère montée sur 200m, reste 80m.Axe 07 : Approche par l'ouest (repère:route et maisons) Seuil décalé, légère descente sur 200m utilisable | 1 | herbe | '25 | 20 | 280 | '07-25 | herbe |  |  |  | 'Inconnue | 123.45 | A proximité | 6,5 | Restauration à proximité, Camping possible | georges.parent@orange.fr | +33 6 80 00 06 08 | PPR: Autorisation du gestionnaire obligatoire.La piste étant très proche des habitations, veillez à ne pas causer de nuisances sonores ou autres aux riverains.Dans le bourg de Jouet, à 500m, on trouve tous commerces (super marché, carburant, pharmacie, médecin, restaurants et même gendarmerie).En cas d'arrivée imprévue (en secours), toujours prévenir le gestionnaire au 06 80 00 06 08 ou 06 63 33 57 84.
 | LF1921 | Eyburie | Base ULM Accès privé | 8/03/2011 | 6/12/2015 | 11/12/2015 | 45.485396119162, 1.64504291534422 | N 45 29 07 | E 001 38 42 | 1316 ft |  | 1 | herbe |  |  | 270 | '03-21 | herbe |  |  |  | 'Inconnue |  |  | 6,4 | Restauration à proximité, Gîte à proximité |  | +33 5 55 73 06 77
 | LF1923 | Peyrelevade | Aérodrome Privé Ouvert aux ULM | 5/09/2011 | 13/08/2016 | 15/08/2016 | 45.707647767609, 2.0325565338134766 | N 45 42 28 | E 002 01 57 | 2493 ft | Décollage masse max : virage à droite au QFU 34virage à gauche au QFU 16 conseilléTour de piste main gauche.Après pluie et dégel, ne pas sortir du bitume. | 1 | dur |  | 18 | 750 | '16-34 | herbe |  |  |  | 'Inconnue |  | A 900 Mètres | 6,2,4 | Restauration à proximité, Hangar possible, Gîte à proximité | contact@lesailesdepeyrelevade.fr | +33 6 63 92 77 80 | Aérodrome réservé aux adhérents de l'AssociationRenseignements , et adhésion : www.lesailesdepeyrelevade.fr
 | LF1926 | Lagarde Enval | Aérodrome Privé Ouvert aux ULM | 8/03/2011 | 18/07/2016 | 22/07/2016 | 45.17720321996853, 1.8027827989501555 | N 45 10 38 | E 001 48 10 | 1600 ft | Atterrissage 22 - Décollage 04 - Tour de piste côté Sud Profil : 4 % moyen, irrégulier Deux lignes électriques HT convergentes: l'une au NE à 370m du seuil 22, l'autre au Sud à proximité même de l'aérodrome. - passer verticale du poteau à l'atterrissage - décollage en virant à droite - Turbulences en finale par vent fort, mais piste non turbulente à l'abri des arbres. Atterrissage dangereux par vent de N.E. Remise de Gaz Impossible | 1 | herbe | '22 | 10 | 380 | '04-22 | herbe |  |  |  | 'Inconnue |  |  |  |  |  | +33 5 55 27 12 10 | Observations : stationnement impérativement à côté du hangar - arbres à 5m du bord de piste, donnant la fausse impression de resserrement de la piste
 | LF1927 | Troches-Pompadour | Base ULM Accès privé | 5/09/2011 | 8/11/2015 | 9/11/2015 | 45.40805436177, 1.4202296733856201 | N 45 24 29 | E 001 25 13 | 1368 ft |  | 1 | herbe |  | 30 | 580 | '02-20 | herbe |  |  |  | 'Inconnue | Auto info 123.500 |  |  |  |  | +33 5 55 73 34 17
 | LF1929 | Saint Cernin de Larche | Aérodrome Privé Ouvert aux ULM | 21/07/2011 | 5/03/2016 | 8/03/2016 | 45.10772670364524, 1.410670280456543 | N 45 06 28 | E 001 24 38 | 331 ft | Aérodrome privé : PPR obligatoire.Etabli le long de la rive gauche de la Couze. | 1 | herbe |  | 0 | 450 | '01-19 | herbe |  |  |  | 'Inconnue | auto-info 123.5 |  |  |  |  |  | Du bourg de St-Cernin, prendre un chemin au NW direction le hameau de Chazat
 | LF1930 | Variéras | Base ULM Accès privé Utilisation EPISODIQUE | 28/09/2011 | 9/11/2017 | 11/11/2017 | 45.610555555556, 1.9927777777777465 | N 45 36 38 | E 001 59 34 | 2755 ft | Plateforme réservée uniquement et strictement à l?usage du propriétaire. Pour des raisons de sécurité aucun invité ne peut être accueilli. | 1 | herbe | '23 | 20 | 240 | '05-23 | herbe |  |  |  | 'Inconnue | 130.0 |  |  | invalid | joeltravers@aol.com | +33 5 55 95 56 71 | Plateforme réservée uniquement et strictement à l?usage du propriétaire. Pour des raisons de sécurité aucun invité ne peut être accueilli.
 | LF1951 | Les Chansèves | Base ULM Autorisation OBLIGATOIRE | 17/07/2011 | 5/03/2016 | 8/03/2016 | 45.090096003822, 1.8553590774536133 | N 45 05 24 | E 001 51 19 | 1550 ft | Seuils décalés 14/32 pour la piste en dur (32 en surplomb et arbres hauts en 14)Attention à l'activité vol libre importante à la belle saison (treuillé, remorqué, cerf volants, simulateurs de vol delta). | 2 | dur | '32 | 10 | 740 | '14-32 | herbe |  | 50 | 210 | '14-32 | Auto-info 123.5 |  |  |  | mail@vollibrecorreze.com | +33 6 20 27 35 43 | La photo ci-dessous a été prise en direction du sud.
 | LF1952 | Lagleygeolle | Aérodrome Privé Ouvert aux ULM | 21/04/2011 | 25/12/2015 | 5/02/2016 | 45.080172554894, 1.6733551025390625 | N 45 04 49 | E 001 40 24 | 1380 ft | PPR : Autorisation du propriétaire obligatoire.Éviter survol centre de naturiste Puy Bousquet (dans les pins) ainsi que château du Theil (axe décollage 07)Atterrissage obligatoire : 25 | 2 | herbe | '07 | 20 | 430 | '07-25 | herbe |  | 20 | 305 | '02-20 | 130.00 | Sur demande | 6,4 | Restauration à proximité, Gîte à proximité | cognac.bernard@gmail.com | +33 6 08 00 06 07 | Chambres d'hôte à 2kms la douce France tel 06 88 65 69 95 ou 05 55 84 39 59Guy vient vous chercher.Restauration et hotels à Meyssac et Collonges à 3 kms
 | LF1953 | Pérols sur Vézère | AltiSurface en service | 19/08/2014 | 25/12/2015 | 5/02/2016 | 45.587342383981, 2.0132379457685374 | N 45 35 14 | E 002 00 48 | 2800 ft | Tour de Piste Main Gauche.ATR en 23, DL en 07 | 1 | terre | '23 |  | 250 | '05-23 | herbe |  |  |  | 'Inconnue | 130.000 |  |  |  |  | +33 5 55 93 09 50 | Altisurface interdite du 15 mars au 31 juillet.Attention à la piste ULM de Variéras 3 km au NNO.Avions : Qualification Montagne requise.ULM : Libre d'accès.PILOTES ULM : Pour votre sécurité et pour obtenir les dernières consignes, veuillez contacter le PNVM (Pôle National Vol Montagne) au 0698282850 ou 0683512668.
 | LF1954 | Savignoux | Base ULM Accès privé | 23/04/2015 | 25/12/2015 | 5/02/2016 | 45.01259457724309, 1.7818073412577178 | N 45 00 45 | E 001 46 55 | 886 ft | longueur de la piste goudron = 200 mlongueur de la piste réelle herbe + goudron = 400 m | 1 | dur | '14 | 14 | 400 | '14-32 | herbe |  |  |  | 'Inconnue |  |  | 3,4,1 | Restauration sur place, Gîte à proximité, Atelier ULM | gmenoire@gmail.com | +33 6 77 13 53 47
 | LF2022 | Cargèse | Base ULM Réglementé Utilisation EPISODIQUE | 7/05/2011 | 24/11/2015 | 26/11/2015 | 42.175559766249, 8.608949834631403 | N 42 10 32 | E 008 36 32 | 17 ft | TDP en main droite en 22 et gauche 04Attention ligne téléphone seuil 22 et arbre seuil 04 | 1 | herbe |  | 30 | 300 | '04-22 | herbe |  |  |  | 'Inconnue | 123.45 | Nil | 6,4,5 | Restauration à proximité, Gîte à proximité, Camping possible | corsicasky@hotmail.fr | +33 6 16 50 17 34 | Terrain agricole (bovins) ouvert du 15 juin au 30 septembre.terrain accidenté à proscrire aux ulm rapide et aux trains fragiles.il est impératif de téléphoner à l'exploitant.l'exploitant décline toutes responsabilités en cas d'accident.
 | LF2023 | Aghione Casone | Base ULM Autorisation OBLIGATOIRE | 31/10/2012 | 24/12/2015 | 26/01/2016 | 42.101816063011, 9.415381874658237 | N 42 06 07 | E 009 24 55 | 206 ft |  | 1 | herbe |  | 70 | 220 | 'omnidir | herbe |  |  |  | 'Inconnue | Auto-info 123.5 |  |  |  | airscapades@wanadoo.fr | +33 6 75 43 87 15
oui | LF2051 | Cavallo | Base ULM Accès privé | 9/04/2011 | 20/08/2017 | 21/08/2017 | 41.368152621206235, 9.260674198394781 | N 41 22 05 | E 009 15 38 | 20 ft |  | 1 | terre |  | 0 | 700 | '09-27 | herbe |  |  |  | 'Inconnue |  |  |  | invalid |  | +33 4 95 70 03 82 | Ancien aérodrome désormais classé en piste ulm et fréquenté uniquement par des hélicoptères.Atterrissage sans autorisation très fortement déconseillé.Autorisation probablement impossible à obtenir auprès de l'Association Syndicale Libre Ile de Cavallo (04 95 70 03 82)Piste non entretenue avec de nombreux cailloux.
 | LF2121 | Auxey Duresses | Aérodrome Privé Ouvert aux ULM | 8/03/2011 | 24/12/2015 | 20/01/2016 | 46.998889443479, 4.735131089952233 | N 46 59 56 | E 004 44 06 | 1378 ft | Auxey: prononcez 'aussé' comme Auxerre se prononce 'au-ssère' ! Aérodrome privé. http://domaine.roy.free.fr/terroir31.html. | 1 | herbe |  |  | 800 | '05-23 | herbe |  |  |  | 'Inconnue |  |  |  |  |  | +33 3 83 21 22 51 | PPR au propriétaire récoltant-négociant : la GAEC des frères Roy phone 03 83 21 22 51 fax : 03 80 21 23 71 ou Vincent Roy 03 80 21 22 37ou Dominique Roy 03 80 21 23 75Visite des caves et dégustation, terroir 'Côtes de Beaune.
 | LF2122 | Chaume et Courchamp | Aérodrome Privé Ouvert aux ULM | 8/03/2011 | 30/04/2017 | 2/05/2017 | 47.574920382643, 5.350986103179935 | N 47 34 30 | E 005 21 04 | 930 ft | PPR : Aérodrome privé réservé au propriétaire et aux amis du propriétaire ainsi qu'a ceux ayant l'autorisation d'atterrissageAttention piste montante côté 23 et descendante côté 05 (...), pente moyenne. | 1 | herbe | '23 |  | 600 | '05-23 | herbe |  |  |  | 'Inconnue |  |  |  |  |  | +33 3 80 75 83 15 | En hiver, attention, de nombreux trous sont causés par les sangliers.
 | LF2123 | Dampierre et Flée | Base ULM Accès privé | 8/03/2011 | 8/06/2017 | 10/06/2017 | 47.4773921467244, 5.358383613769547 | N 47 28 39 | E 005 21 30 | 751 ft | Tour de piste à l'Ouest. | 1 | herbe | '20 | 25 | 530 | '02-20 | herbe |  |  |  | 'Inconnue | 123.50 |  |  |  | jean-louis.chabeuf@orange.fr | +33 6 10 97 76 14 | Terrain privé réservé aux appareil basés.Visites des aéronefs non basés possible après autorisation du gestionnaire par e-mail et sous l'entière responsabilité des pilotes visiteurs. Écolage interdit par arrêté préfectoral.
oui | LF2124 | Nantoux Les Vignes Naudin | Base ULM fermée définitivement | 9/11/2011 | 29/03/2012 | 30/03/2012 | 47.0111113, 4.793951900000025 | N 47 00 40 | E 004 47 38 | 1164 ft | piste en pente de 5% - atterrissage en 30seuil décalé de 50m en 30 cause clotûreposition GPS exacte: mi-piste N47°01'26' - E04°45'25' | 1 | herbe | '30 | 0 | 350 | '12-30 |  |  |  |  |  | Auto-info 123.5 |  |  |  |  | +33 6 86 93 13 07 | Le propriétaire Jean MICHELOT est décédé.Le domaine viticole a été vendu.Une reconnaissance pédestre ne m'a pas permis de trouver le terrain aux coordonnées indiquées.Le terrain n'existe probablement plus.
 | LF2127 | Chazan | Base ULM Autorisation OBLIGATOIRE | 8/03/2011 | 24/12/2015 | 20/01/2016 | 47.215698231049, 4.904163331985501 | N 47 12 57 | E 004 54 15 | 1516 ft |  | 1 | herbe |  |  | 200 | '15-33 | herbe |  |  |  | 'Inconnue | Auto info 123.500 |  | 2,4 | Hangar possible, Gîte à proximité
oui | LF2131 | Sombernon Vielmoulin | Base ULM fermée définitivement | 8/03/2011 | 16/11/2014 | 17/07/2015 | 47.329167, 4.658333 | N 47 19 45 | E 004 39 30 | 1476 ft | Au 1/1/2007, plus d'activités,plus de manche a air,plus d'entretien de piste. Piste le long de la route (D9) Haie d'environ 2m au seuil de la 29. A 1500m à l'Est, zone très chargée en lignes très hautes tensions EDF convergeant à un gros centre de répartition. | 1 | herbe |  |  | 300 | '11-29 | herbe |  |  |  | 'Inconnue |  |  |  |  |  | +33 3 80 41 56 94
 | LF2132 | Souhil | Base ULM Accès privé | 8/11/2011 | 30/04/2017 | 2/05/2017 | 47.922614362855136, 4.768656492233276 | N 47 55 21 | E 004 46 07 | 792 ft | ATTENTION : ligne haute tension en entrée de piste 02 | 1 | herbe |  | 0 | 360 | '02-20 | herbe |  |  |  | 'Inconnue | Auto-info 123.5 |  |  |  |  | +33 3 80 93 52 02
 | LF2134 | Recey Le Mont de Lucey | Base ULM Accès limité Autorisation OBLIGATOIRE | 8/11/2011 | 24/12/2015 | 20/01/2016 | 47.79406507426282, 4.855115936523475 | N 47 47 39 | E 004 51 18 | 1300 ft | 05 préférentielle à l'atterrissage (piste montante + dévers au seuil 05) Marques de distance restante en centaine de mètres (3,2,1) à gauche en 05Atterrissage 23 délicat forte pente & obstacles & fortes turbulences par vent du Sud) Déco 23 préférable | 1 | herbe | '05 | 20 | 400 | '05-23 | herbe |  |  |  | 'Inconnue | Auto-info 123.5 |  |  |  | francoislescure@free.fr |  | Plateforme située dans la R45-A (du sol à 800 ft sol) - RESPECTER les conditions de pénétration. Tél 0800 24 54 66.
 | LF2151 | Saint Jean de Losne | Base ULM Autorisation OBLIGATOIRE | 8/03/2011 | 24/12/2015 | 20/01/2016 | 47.073582445961435, 5.2661568148193965 | N 47 04 25 | E 005 15 58 | 600 ft | Intégration 500 ft, Tour de piste à l'ouestParticularité : Pas de survol des habitations, zone de Dijon-Longvic : contact radio obligatoire la semaine pour transiter. | 1 | herbe |  |  | 380 | '16-34 | herbe |  |  |  | 'Inconnue |  |  |  |  |  | +33 6 75 90 50 63 | contact avec le président :Roland SAUVINportable 06 75 90 50 63
 | LF2161 | Château La Chassagne | Aérodrome privé fermé temporairement. | 8/03/2011 | 24/12/2015 | 20/01/2016 | 47.309444444444, 4.819444444444571 | N 47 18 34 | E 004 49 10 | 1118 ft | terrain fermé en 2015 et 2016 | 1 | herbe |  | 50 | 800 | '06-24 | herbe |  |  |  | 'Inconnue |  | néant |  |  | info@chassagne.com | +33 3 80 49 76 00 | Pour raison de travaux programmés en 2015 et en 2016, la plateforme est fermée.
 | LF2162 | Saint-Romain | Aérodrome Privé Ouvert aux ULM | 8/03/2011 | 24/12/2015 | 20/01/2016 | 47.017018107603, 4.699597439236072 | N 47 01 01 | E 004 41 59 | 1850 ft | Aérodrome privé. | 1 | herbe |  | 30 | 750 | '04-22 | herbe |  |  |  | 'Inconnue |  |  |  |  | buisson.construction@free.fr | +33 6 61 35 75 50 | PPR au propriétaire, habitant à côté de sa piste, M Vard, 0380216846 ou M Buisson: 03 80 216312 ou 0661357550. - Renseignements + carte VAC : http://www.saintromain.free.fr/index.php?mod=page&ac=page&id_page=1
 | LF2163 | Nantoux | Aérodrome Privé Ouvert aux ULM | 8/03/2013 | 20/12/2015 | 27/12/2015 | 47.024037837072, 4.757297879742396 | N 47 01 27 | E 004 45 26 | 1138 ft | Seuil décalé de 50m en 30 cause clôture.Ne pas survoler le hameau.Tour de piste main droite.Atterrissage préférentiel QFU 30.pente montante de 5% en 30Décollage QFU 12 | 1 | herbe | '30 | 10 | 350 | '12-30 | herbe |  |  |  | 'Inconnue | 123.500 | Non | 5 | Camping possible | vincentdancer@free.fr | +33 6 10 26 46 31 | Vents dominant W à NSoleil gênant en fin d'après midiPPR au propriétaire Vincent Dancer
 | LF2164 | Blanot | Base ULM Accès privé | 17/11/2013 | 10/11/2015 | 15/11/2015 | 47.173886651354, 4.233631396823512 | N 47 10 26 | E 004 14 01 | 1575 ft | Piste située dans la R45B, de type altisurface montant en 24.Tour de piste à l'ouest. Expérience montagne recommandée.Profil 24 :145m en rampe de 10%50m en rampe de 5%110m à plat orienté 25, en terre battue avec des cailloux. | 1 | herbe | '24 | 18 | 305 | '06-24 | herbe |  |  |  | 'Inconnue |  | sur réservation | 4 | Gîte à proximité | t.tm@me.com | +33 6 68 04 34 34 | Accès uniquement après accord téléphonique.
 | LF2221 | Kerfot la Paimpolaise | Base ULM Autorisation OBLIGATOIRE | 30/06/2011 | 24/12/2015 | 21/01/2016 | 48.723882415411, -3.027055263519287 | N 48 43 26 | W 003 01 37 | 308 ft | Téléphone impératif avant venir : visite possible de sangliers.Tour de piste à l'Ouest. Branche vent AR à l'Ouest du village Yvias. Etape de Base 33 verticale station. | 1 | herbe |  | 10 | 330 | '15-33 | herbe |  |  |  | 'Inconnue | 130 | NIL |  |  |  | +33 6 09 83 33 27 | Les tours de piste sont interdits avant 9h, entre 12h et 15h, après 19h30. Nous évitons d'utiliser la plate forme pendant ces horaires pour garder de bons contacts avec nos riverains..Voir Metar et Taf de St Brieuc LFRT et Lannion LFRO pour la météo localeRisque de brume de mer en été par vent E - NE.
oui | LF2222 | Lamballe La Poterie | Base ULM fermée définitivement | 8/03/2011 | 21/04/2014 | 24/04/2014 | 48.48683227317263, -2.4497580528259277 | N 48 29 13 | W 002 26 59 | 312 ft |  | 1 | herbe |  | 0 | 350 | '09-27 | herbe |  |  |  | 'Inconnue |  |  |  |  | jj.treps@wanadoo.fr | +33 2 96 72 34 28 | Plateforme ULM fermée. Le Club est transféré à Saint Brieuc LFRT.Éoliennes installées sur la plate forme.
oui | LF2224 | Locarn | Base ULM fermée définitivement | 22/11/2015 | 3/09/2016 | 28/11/2016 | 48.33032290768465, -3.4469651222228936 | N 48 19 49 | W 003 26 49 | 500 ft | Piste fermé definitivement | 1 | herbe | '26 | 25 | 330 | '08-26 | herbe |  |  |  | 'Inconnue | 123.500 | Possibilité ! |  |  | jnbenoit@hotmail.fr | +33 6 51 08 24 02 | Piste fermé définitivement (retrait d'autorisation)
 | LF2321 | Évaux | Aérodrome Privé Ouvert aux ULM | 8/03/2011 | 25/12/2015 | 5/02/2016 | 46.16996160726178, 2.4308086931152957 | N 46 10 12 | E 002 25 51 | 1512 ft | Aérodrome privé. | 1 | herbe |  |  | 1250 | '14-32 | herbe |  |  |  | 'Inconnue |  |  |  |  |  | +33 5 55 82 12 36 | PPR à Janine Alajouanine, Château de Villemaleix, Chambon/Voueize tél : 05 55 82 12 36Aérodrome situé sur la commune de Chambon-sur-Voueize.Curiosité : A proximité de la piste, le fuselage (il manque les ailes, moteurs et hélices) de l'HD321 (1° vol en 1956) posé en catastrophe ici le 10 mai 1960 et donc jamais reparti !
oui | LF2322 | La Courtine | Base ULM fermée temporairement | 8/03/2011 | 10/11/2015 | 4/12/2015 | 45.716667, 2.243056000000024 | N 45 43 00 | E 002 14 35 | 2415 ft |  | 1 | herbe |  |  | 450 | 'Inconnue | herbe |  |  |  | 'Inconnue |  |  |  |  |  |  | pas évident sur google earth
 | LF2351 | Le Pommier | Base ULM Autorisation OBLIGATOIRE | 11/07/2011 | 27/05/2017 | 28/05/2017 | 46.1967734866317, 1.4527702331542969 | N 46 11 48 | E 001 27 10 | 1140 ft | Piste genre altiport, ne pas hésiter à plonger pour toucher vers le seuil, si impression d'être trop long, remettre les gaz et passer dans la trouée.Attention, l'été en soirée risque d'éblouissement.Interdite aux ailes basses (clôture de pâture l'été) | 2 | herbe | '21 | 20 | 200 | '03-21 | herbe | '28 | 12 | 300 | '10-28 | auto-info 123.5 |  |  |  | a.kemi@wanadoo.fr | +33 6 88 98 31 77 | Ne pas survoler les villages alentours.
 | LF2353 | Le Pouyollet Lizières | Règles spécifiques d'accès | 19/05/2011 | 25/12/2015 | 4/02/2016 | 46.212625390488, 1.5722465515136719 | N 46 12 45 | E 001 34 20 | 1380 ft | 03 piste montante.Tour de piste main gauche. Obstacles : ligne électrique en courte finale 03, arbres à droite de la piste en 03. Attention léger dévers gauche en 03. Piste délicate. | 1 | herbe | '03 | 20 | 150 | '03-21 | herbe |  |  |  | 'Inconnue |  |  |  |  | Lbfrf23@orange.fr | +33 6 80 10 96 33 | piste délicate par vent d'est. Le survol du village est a éviterSi pas de manche à air, piste fermée.
 | LF2421 | Augignac | Aérodrome Privé Ouvert aux ULM | 29/06/2011 | 17/11/2017 | 19/11/2017 | 45.562989777592, 0.7044553756713867 | N 45 33 47 | E 000 42 16 | 865 ft | ATR en 22: forte déclivité début de piste - Circuit par l'EstProfil piste: plat (50m) + 6,6% (150m) + 3,6% (325m)Piste étroite (20m). Éviter survol château Leygurat à 1km NE dans axe piste.Bosquets d'arbres abords pisteVent du Nord>10KT:ATT interdit | 2 | herbe | '22 | 20 | 525 | '04-22 | herbe |  | 20 | 300 | '04-22 | 123.50 | NON | 6,5 | Restauration à proximité, Camping possible | faure.albert12@gmail.com | +33 6 08 31 46 78 | PPR : Autorisation écrite obligatoire (prescrite par arrêté préfectoral) à demander au gestionnaire A. Faure : - tel : 06 08 31 46 78 ou 05 24 12 13 30 - email : faure.albert12@gmail.comPiste principale n°1: (525mx20m) ouverte à tous les pilotes autorisés. Piste n°2 (300mx20m) réservée formation EP/Ulm. Caractéristiques de la piste requièrent expérience et qualités aéronautiques nécessaires pour son utilisation.
 | LF2422 | Beaumont | Aérodrome Privé Ouvert aux ULM | 1/08/2011 | 24/12/2015 | 17/01/2016 | 44.765985503, 0.7246685028076172 | N 44 45 58 | E 000 43 29 | 508 ft |  | 1 | herbe |  | 0 | 370 | '03-21 | herbe |  |  |  | 'Inconnue | auto-info 123.5 |  |  |  |  | +33 5 53 22 35 15 | Mme Teyssieu Denise, le Tertre Blanc, 24440 Beaumont, phone : 05 53 22 35 15.
 | LF2423 | Condat sur Vézère | Aérodrome Privé Ouvert aux ULM | 1/08/2011 | 18/07/2016 | 20/07/2016 | 45.103758756295, 1.2150514125823975 | N 45 06 14 | E 001 12 54 | 499 ft | Tour de Piste à l'ouest, atterrissage uniquement en 35Décollage uniquement en 17. Attention ! La piste en herbe est fermée par arrêté préfectoral.Tour de piste à l'ouest 1000ft coté hangar | 1 | dur | '35 | 30 | 600 | '17-35 | herbe |  |  |  | 'Inconnue | auto-info 123.5 |  |  |  | rolmir@hotmail.fr | +33 6 29 72 17 98 | PPR obligatoire par phone: 06 29.72.17.98 Roland BoissierePour la piste en dur, Il s'agit de l'ancien aérodrome LFDZ, réouverte en décembre 2011 aux ULM et Avions.Piste 35 montante
 | LF2424 | Coursac | Aérodrome fermé. | 5/08/2011 | 25/11/2016 | 26/11/2016 | 45.110696804337, 0.6408356772528805 | N 45 06 39 | E 000 38 27 | 730 ft | Aérodrome fermé. Cette piste est un ancien aérodrome privé qui est désormais fermé à tout mouvement. L'atterrissage y est interdit sauf en cas de panne, bien entendu. Utile à connaître, ne pas supprimer cette fiche. | 1 | herbe | '30 | 8 | 550 | '12-30 | herbe |  |  |  | 'Inconnue |  |  |  |  |  |  | Aérodrome ferméTERRAIN DE SECOURS UNIQUEMENT
 | LF2426 | Eyrignac | Aérodrome Privé Ouvert aux ULM | 5/06/2011 | 18/07/2016 | 21/07/2016 | 44.943097580119, 1.312077171411147 | N 44 56 35 | E 001 18 43 | 820 ft | Attention, c?est une piste en pente mais qui ne présente pas de difficulté particulièreVisez le milieu de la piste, puis roulez avec du gaz jusqu?à la partie plane. Le décollage se fait en sens inverse bien sur et lui aussi ne présente aucune difficulté | 1 | herbe | '16 | 30 | 500 | '16-34 | herbe |  |  |  | 'Inconnue |  |  | 3 | Restauration sur place | eyrignac@perigord.com | +33 6 08 28 00 29 | Aérodrome privé.PPR obligatoire au proprio: le pilote visiteur doit lui envoyer quelques jours avant son départ pour cet aérodrome privé un fax (05 53 30 39 89) mentionnant les renseignements demandés pour la déclaration en préfecture, et obtenir du propriétaire son accord.Restaurant sur place. Possibilité de visite des jardins pour environ 8 EurosLes jardins d'Eyrignac sont mondialement connus pour la beauté de leurs jardins à la Française
 | LF2428 | Javerlhac | Aérodrome Privé Ouvert aux ULM | 15/08/2011 | 5/03/2016 | 8/03/2016 | 45.553817459108, 0.5585002899169922 | N 45 33 14 | E 000 33 31 | 633 ft | Atterrissage préférentiel en 23 après un tour de piste côté sud-estEviter le survol du bourg de JaverlhacLa piste a retrouvé sa longueur initiale. | 1 | herbe | '23 | 40 | 730 | '05-23 | herbe |  |  |  | 'Inconnue | auto-info 123.5 |  |  |  |  | +33 5 53 56 34 03 | Planeurs autorisés après contact Cognac App. 122.55
 | LF2430 | Lalinde | Aérodrome Privé Ouvert aux ULM | 10/11/2011 | 24/12/2015 | 17/01/2016 | 44.88087784031582, 0.7444095611572266 | N 44 52 51 | E 000 44 40 | 614 ft | Seuil décalé en 32 cause arbres | 1 | herbe | '32 | 0 | 420 | '14-32 | herbe |  |  |  | 'Inconnue | Auto-info 123.5 |  |  |  |  | +33 5 53 61 05 44 | PPR Obligatoire
 | LF2431 | Liorac sur Louyre | Aérodrome Privé Ouvert aux ULM | 8/03/2011 | 24/12/2015 | 17/01/2016 | 44.918889, 0.6455559999999423 | N 44 55 08 | E 000 38 44 | 518 ft | Aérodrome privé. PPR : Téléphoner pour autorisation de s'y poserPiste préférentielle 06 avec manche à air en légère montée jusqu'à mi pisteCircuit main gauche. Hangar au seuil 06, côté droit. | 1 | herbe | '06 |  | 450 | '06-24 | herbe |  |  |  | 'Inconnue |  |  |  |  | jm_dindart@hotmail.com
 | LF2432 | Pressignac Vicq Rebeyrotte | Aérodrome Privé Ouvert aux ULM | 1/08/2011 | 5/03/2016 | 8/03/2016 | 44.902866769771, 0.7479822635650635 | N 44 54 10 | E 000 44 53 | 643 ft | Tours de piste côté ouestAux abords du terrain, écoute et transmission radio obligatoire A/A (=auto information): 123,500 MHz L'aérodrome vu du ciel (photo prise côté vent arrière, en direction de l'est)(Copyright): | 1 | herbe | '19 | 35 | 850 | '01-19 | herbe |  |  |  | 'Inconnue | 123.5 |  | 3,4 | Restauration sur place, Gîte à proximité | thierry.roussel5@wanadoo.fr | +33 6 86 77 52 30 | PPR = Autorisation obligatoire avant d'atterrir06 86 77 52 30 : 05 53 61 13 87. ULM acceptés.Tout pilote (avion, ULM) désirant utiliser notre aérodrome doit adhérer à l'Aéro Club Ferme du Rebeyrotte, 24150 PRESSIGNAC VICQ, dont la cotisation est de 10e pour une année civile (01 janv au 31 déc). - Pour votre séjour, nous vous accueillons soit en chambres d?hôtes, soit en gite ruralSituation 130Km de Bordeaux
 | LF2433 | La Rochebeaucourt Argentine | Aérodrome Privé Ouvert aux ULM | 1/08/2011 | 24/12/2015 | 15/01/2016 | 45.46666218842367, 0.38750410079956055 | N 45 27 60 | E 000 23 15 | 468 ft | Tour de piste : hauteur 1000 pieds sol à l'OuestTour de Piste au Sud à 800 ft.Intégration verticale piste hauteur 1500 pieds solTerrain situé en bordure de la zone de Cognac (R49HB 3300ft/+) à contacter sur 122.55. | 1 | herbe |  | 40 | 750 | '13-31 | herbe |  |  |  | 'Inconnue | 123.5 | station à 1km |  |  | boyerlulu@aol.com | +33 6 18 50 09 56 | Ouvert toute l'année, vous pouvez vous poser sans préavis.Le survol des dômes verts au nord-ouest des installations est formellement interdit.La piste est située sur un plateau, attention les jours de vent ça bouge un peu.Un repère caractéristique est une énorme carrière à 3 km au sud-est.
 | LF2434 | Saint Crépin Carlucet | Aérodrome Privé Ouvert aux ULM | 1/08/2011 | 18/07/2016 | 21/07/2016 | 44.966953760047, 1.2507355213165283 | N 44 58 01 | E 001 15 03 | 840 ft | Trouée unique: atterrissage en 24 obligatoireDécollage en 06 Turbulences en entrée de pistePapi pour approche de nuit avec le balisage. | 1 | herbe | '24 | 20 | 500 | '06-24 | herbe |  |  |  | 'Inconnue | 123.50 |  |  |  | heliclubperigord@free.fr | +33 5 53 29 35 33
 | LF2436 | Saint Julien | Aérodrome Privé Ouvert aux ULM | 10/07/2011 | 5/03/2016 | 8/03/2016 | 44.728625538929, 0.44623374938964844 | N 44 43 43 | E 000 26 46 | 449 ft |  | 1 | herbe | '01 | 20 | 470 | '01-19 | herbe |  |  |  | 'Inconnue | auto-info 123.5 |  | 6 | Restauration à proximité |  | +33 5 53 58 43 89 | Comité d'Animation et Loisirs' Le Bourg '24500 Saint-Julien-d'EymetTél. : 06.07.83.47.55
 | LF2437 | Le Rigola Bourdeilles | Base ULM Autorisation OBLIGATOIRE | 17/07/2011 | 24/12/2015 | 15/01/2016 | 45.30391610952425, 0.596458911895752 | N 45 18 14 | E 000 35 47 | 580 ft | Tour de piste au SUD08-Atterrissage dangereux par vent FORT Nord/N.E (350° au 50°) : Rabattants causés par le bois26-Seuil décalé 150 m à cause de la route. Seuil au niveau du bâtiment toiture verte. Devant la piste,la ligne téléphonique EST ENTERRÉE | 1 | herbe | '08 | 20 | 450 | '08-26 | herbe |  |  |  | 'Inconnue | auto-info 123.5 | sur réservation | 3,6,4,5 | Restauration sur place, Restauration à proximité, Gîte à proximité, Camping possible | ulm.en-perigord-vert@live.fr | +33 6 09 30 49 87 | Avec participation aux frais : club house avec coin cuisine (couverts, vaisselle etc...), bloc sanitaire avec douche, lavabo, wc (important pour les dames !)
 | LF2438 | Bas Meygnaud Valeuil | Base ULM Accès privé | 1/08/2011 | 2/07/2016 | 4/07/2016 | 45.326926997455, 0.6364774703979492 | N 45 19 37 | E 000 38 11 | 405 ft | Vent dominants,SW-NW. Sol plat, peuplier de 30 m au SE , Attention ligne HT à 200 M SE. | 1 | herbe | '15 | 35 | 480 | '15-33 | herbe |  |  |  | 'Inconnue |  |  | 5 | Camping possible |  | +33 5 53 05 72 11 | contact André Ramond 05 53 05 72 11portable : 06 81 10 06 92
 | LF2443 | Peyrillac | Aérodrome Privé Ouvert aux ULM | 10/07/2011 | 18/07/2016 | 21/07/2016 | 44.89017456633, 1.4164316654205322 | N 44 53 25 | E 001 24 59 | 2950 ft | Atterrissage impératif en 01 (9% de pente régulière sur 400m puis plat sur les 50m restants)Décollage en 19, tour de piste à l'ouestArbres proches de la piste, débordant notamment à droite au seuil 01. | 1 | herbe | '01 | 20 | 450 | '01-19 | herbe |  |  |  | 'Inconnue | auto-info 123.5 |  |  |  |  | +33 5 53 28 36 62 | PPR à Mr Pierre Gachet, domaine de Ginestet, 24370 Peyrillac, phone: 05 53 28 36 62. Autorisation indispensable de la part du propriétaire.
 | LF2445 | Braulen | Base ULM fermée définitivement | 8/03/2011 | 3/07/2015 | 17/06/2017 | 44.86860347697753, 1.2899084206237603 | N 44 52 07 | E 001 17 24 |  |  | 1 | herbe |  |  |  | 'Inconnue | herbe |  |  |  | 'Inconnue |  |  |  |  |  |  | piste possible sur google earth !?!
 | LF2446 | Sud-Ouest Aéro-Loisirs | Base ULM Privé Avec Restrictions Autorisation OBLIGATOIRE | 6/06/2011 | 24/12/2015 | 15/01/2016 | 45.440463783446084, 1.2268118392868246 | N 45 26 26 | E 001 13 37 | 1148 ft | Piste située dans la R166BPrivilégier atterrissage en 05 (montante 3%) & décollage en 23Tour de piste : éviter survol habitations voisines | 1 | herbe | '05 | 30 | 250 | '05-23 | herbe |  |  |  | 'Inconnue | 123.5 |  |  |  | infos@soal.fr | +33 6 13 74 70 49 | Plateforme privée : autorisation OBLIGATOIRE !!!
 | LF2449 | Hautefaye | Base ULM Accès privé | 23/09/2011 | 12/05/2016 | 14/05/2016 | 45.545304869323, 0.49332261085510254 | N 45 32 43 | E 000 29 36 | 450 ft | La piste est longue mais présente de larges ondulations. On s'y fait très bien en étant prévenu.piste montante QFU 20 en fond de vallon.piste réservée à des pilotes expérimentés | 1 | herbe | '20 | 40 | 470 | '02-20 | herbe |  |  |  | 'Inconnue | AA 123.50 | Sur demande | 6,4,5 | Restauration à proximité, Gîte à proximité, Camping possible | lesjaubertins@orange.fr | +33 5 53 56 04 50 | PPR : Merci de bien vouloir prévenir à l'avance de votre arrivée. Camping sur place : 3 chalets dortoirs 4 personnes, un gite pour 4 personnes, 2 mobil home.
 | LF2452 | Sanet Agonac | Base ULM Autorisation OBLIGATOIRE | 8/03/2011 | 24/12/2015 | 15/01/2016 | 45.252602827063, 0.7630306931152973 | N 45 15 09 | E 000 45 47 | 546 ft |  | 1 | herbe |  |  | 200 | '01-19 | herbe |  |  |  | 'Inconnue |  |  |  |  |  | +33 6 80 93 57 84
 | LF2453 | Ferme Milhac- Oie en Périgord | Base ULM Privé Avec Restrictions Autorisation OBLIGATOIRE | 4/11/2011 | 31/10/2017 | 2/11/2017 | 45.11325410946, 0.9224224090576172 | N 45 06 48 | E 000 55 21 | 754 ft | Trouée unique type altiport: Atterr en 27 Décol en 09. Turbulences.Piste courte montante dans le sens atterr réservée aux pilotes expérimentés. Circuit de piste au SUD 700ft QFE. Ne pas survoler les riverains au nord de la piste: sensibles au bruit. | 1 | herbe | '27 | 20 | 150 | '09-27 | herbe |  |  |  | 'Inconnue | Auto-info 123.5 |  | 6,2,4,5 | Restauration à proximité, Hangar possible, Gîte à proximité, Camping possible | perigord.ulm@free.fr | +33 6 12 59 18 22 | PPR: Autorisation préalable nécessaire: AVANT de venir consulter les infos et photos de piste: http://milhacoie.free.fr/terraulm.php. Compléter et me retourner le 'protocole d'utilisation'. Ne pas survoler les riverains au nord de la piste (sensibles au bruit), Infos club ULM: http://perigord.ulm.free.frHébergements sur place (gites): http://milhacoie.free.fr/location.phpCamping à la ferme sur place: http://milhacoie.free.fr/camping.php
 | LF2454 | Terrasson le Bos | Base ULM Autorisation OBLIGATOIRE | 4/08/2011 | 24/12/2015 | 15/01/2016 | 45.134344193204, 1.3365554809570312 | N 45 08 04 | E 001 20 12 | 292 ft | Préférentielle en 35. Bien utiliser les passages pour le taxiway.La bande d'atterrissage peut être grasse après de fortes pluies en hiver. Éviter le survol à basse altitude de la zone située à l'est de la base. | 1 | herbe | '35 | 30 | 300 | '17-35 | herbe |  |  |  | 'Inconnue | Auto-info 123.5 | Sur demande |  |  | befichet@orange.fr | +33 6 81 28 63 79 | PPR par phone 06 81 28 63 79 - Association multi activités,La plate forme est très dynamique et accueille très souvent des manifestations, comme le Tour de France en 2004, et le trèfle d?aquitaine en 2005.Autres activités, spéléologie, VTT.Excellente ambiance dans l?équipe qui anime le club, allez visiter leur site internet.Une très bonne destination, bon accueil garanti.
 | LF2458 | Piste du Tartou | Base ULM Autorisation OBLIGATOIRE | 2/04/2011 | 24/12/2015 | 15/01/2016 | 45.650190875743, 0.5749261379241943 | N 45 39 01 | E 000 34 30 | 756 ft | Intégration 1000 ft AGLTour de piste 500 ft AGL | 1 | herbe | '13 | 20 | 330 | '13-31 | herbe |  |  |  | 'Inconnue | 123.5 | SP sur réservat | 3,4 | Restauration sur place, Gîte à proximité | contact@lesgitesdetartou.com | +33 5 53 56 49 06
 | LF2461 | Galinat Tamnies les Eyzies | Aérodrome Privé Ouvert aux ULM | 7/07/2011 | 5/03/2016 | 7/03/2016 | 44.991815853722, 1.1420631408691406 | N 44 59 31 | E 001 08 31 | 655 ft | Atterrissage impératif en 16 : 9% sur 60 m puis 4,2% sur 390 m. Tour de piste à l'est, Survol du village interdit, Point d'entrée : les deux châteaux d'eau, dernier virage à gauche For Brits : need some help ? Bob Thompson, phone 0553503028. | 1 | herbe | '16 | 20 | 450 | '16-34 | herbe |  |  |  | 'Inconnue | auto-info 123.5 |  |  |  | CEYRAL@aol.com | +33 6 88 33 34 66 | Aérodrome privé situé en bordure Nord du village de Galinat.De Montignac, Thonac et suivre étang de TAMNIESDe Sarlat, Tamnies, suivre Sergeac Montignac
 | LF2462 | Plazac | Base ULM Autorisation OBLIGATOIRE | 9/03/2011 | 3/12/2015 | 5/12/2015 | 45.02668229098331, 1.0142528306885135 | N 45 01 36 | E 001 00 51 | 700 ft | Piste ULM en herbe longueur 140 metres /30 mètres. Orientation 06-24 Atterrissage 24 uniquement, decoll. 06 | 1 | herbe | '24 | 30 | 140 | '06-24 | herbe |  |  |  | 'Inconnue |  |  |  |  | wimvoers@Gmail.com | +33 5 53 05 95 92
 | LF2463 | Thénac | Base ULM ouverte tous types | 9/07/2011 | 4/05/2017 | 5/05/2017 | 44.7453768833608, 0.3255879878997803 | N 44 44 43 | E 000 19 32 | 328 ft | Pour un atterrissage en 34 ou un décollage en 16 ne pas survoler la maison à l'est dans l'axe de la piste.piste enherbée terre très saine sous sol très filtrant | 1 | herbe |  | 30 | 400 | '16-34 | herbe |  |  |  | 'Inconnue | auto-info 123.5 |  | 6,2,4 | Restauration à proximité, Hangar possible, Gîte à proximité | martial.lajoux@nordnet.fr | +33 6 85 09 92 05 | piste privée appartenant à Martial et Marie LAJOUX ,'le pérou' 24240 Puyguilhem- THENAC tel: 06 85 09 92 05 - 06 09 96 86 76De préférence téléphonez avant, on vous accueillera toujours avec plaisir et simplicité. Nous sommes un petit groupe d'amis surnommé ' La patrouille de Thénac'. Evitez de survoler la maison en bout de piste à l'Est.
 | LF2465 | Le Pas de l'Aze | Base ULM Autorisation OBLIGATOIRE | 10/09/2011 | 19/09/2017 | 21/09/2017 | 45.220032226165, 0.47810912132263184 | N 45 13 12 | E 000 28 41 | 495 ft | Tour de piste au nord en évitant absolument le survol des habitations voisines.Piste à trouée unique : Poser en 11 (hangar à droite) avec seuil décalé à 170 m et déco en 29.Légère pente donc ne cherchez pas à poser court, vous avez tout votre temps. | 1 | herbe | '11 | 26 | 470 | '11-29 | herbe |  |  |  | 'Inconnue | 123.500 | sur demande | 6,4,5 | Restauration à proximité, Gîte à proximité, Camping possible | boudry.herve@sfr.fr | +33 6 09 83 20 99 | Piste privée, autorisation de poser obligatoire au 06 09 83 20 99 ou par mail boudry.herve@sfr.fr . Attention, piste très grasse par temps de pluie, veuillez contacter le propriétaire pour connaître les conditions avant de venir SVP.Piste sous la zone LF-R166B d'entrainement militaire à très basse altitude (RTBA) allant du sol à 2300ft ASFC. Horaires d'activation : http://www.sia.aviation-civile.gouv.fr ou tél vert : 0800 24 54 66.
 | LF2466 | Clissac | Base ULM Accès privé Utilisation EPISODIQUE | 25/07/2012 | 18/07/2016 | 21/07/2016 | 44.9103010876812, 1.2912751197815168 | N 44 54 37 | E 001 17 29 | 500 ft | Reservé exclusivement aux hélicoptères ulm - Hélisurface en herbe - se présenter au 360° - Usage restreint - | 1 | herbe | '36 | 30 | 150 | 'omnidir | herbe |  |  |  | 'Inconnue | Auto info 123.500 |  |  |  | hubert.laquieze498@orange.fr | +33 6 08 77 75 20 | HELISURFACE OCCASIONNELLE - contact au 06 08 77 75 20 au préalable -Hubert Laquieze
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
