F-JJTH/aeropi/resources/3d-model.stl

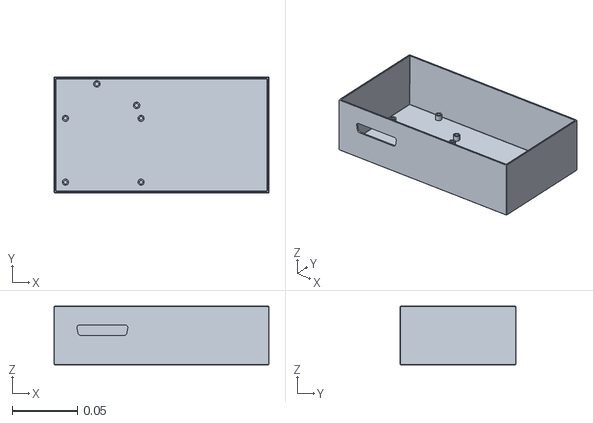
[picture p15: CAD file, 2017-10-20]
resources/3d-model.stl
0.165 x 0.089 x 0.045
