F-JJTH/aeropi/resources/3d-model-small.stl

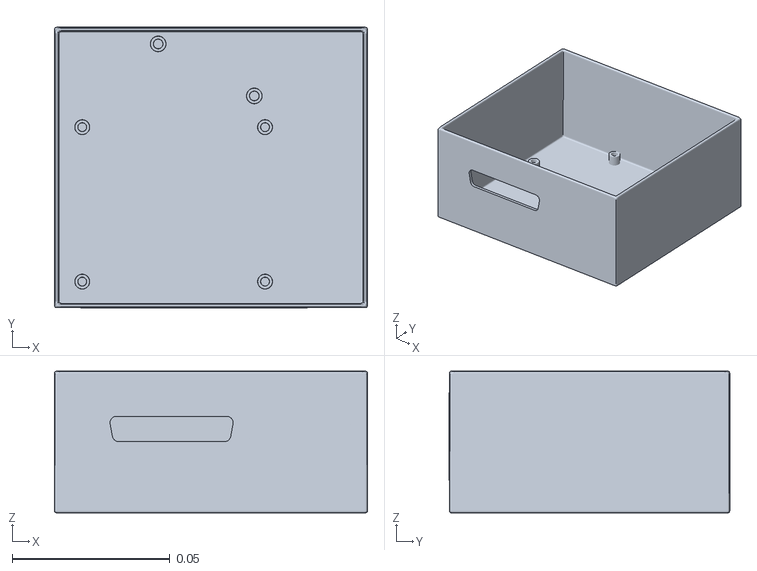
[picture p16: CAD file, 2017-10-20]
resources/3d-model-small.stl
0.0993 x 0.089 x 0.045
