F-JJTH/aeropi/(list of files, cad)

Other CAD files:
resources/mpxv5004dp.blend
