F-JJTH/aeropi/aeroPi.pdf

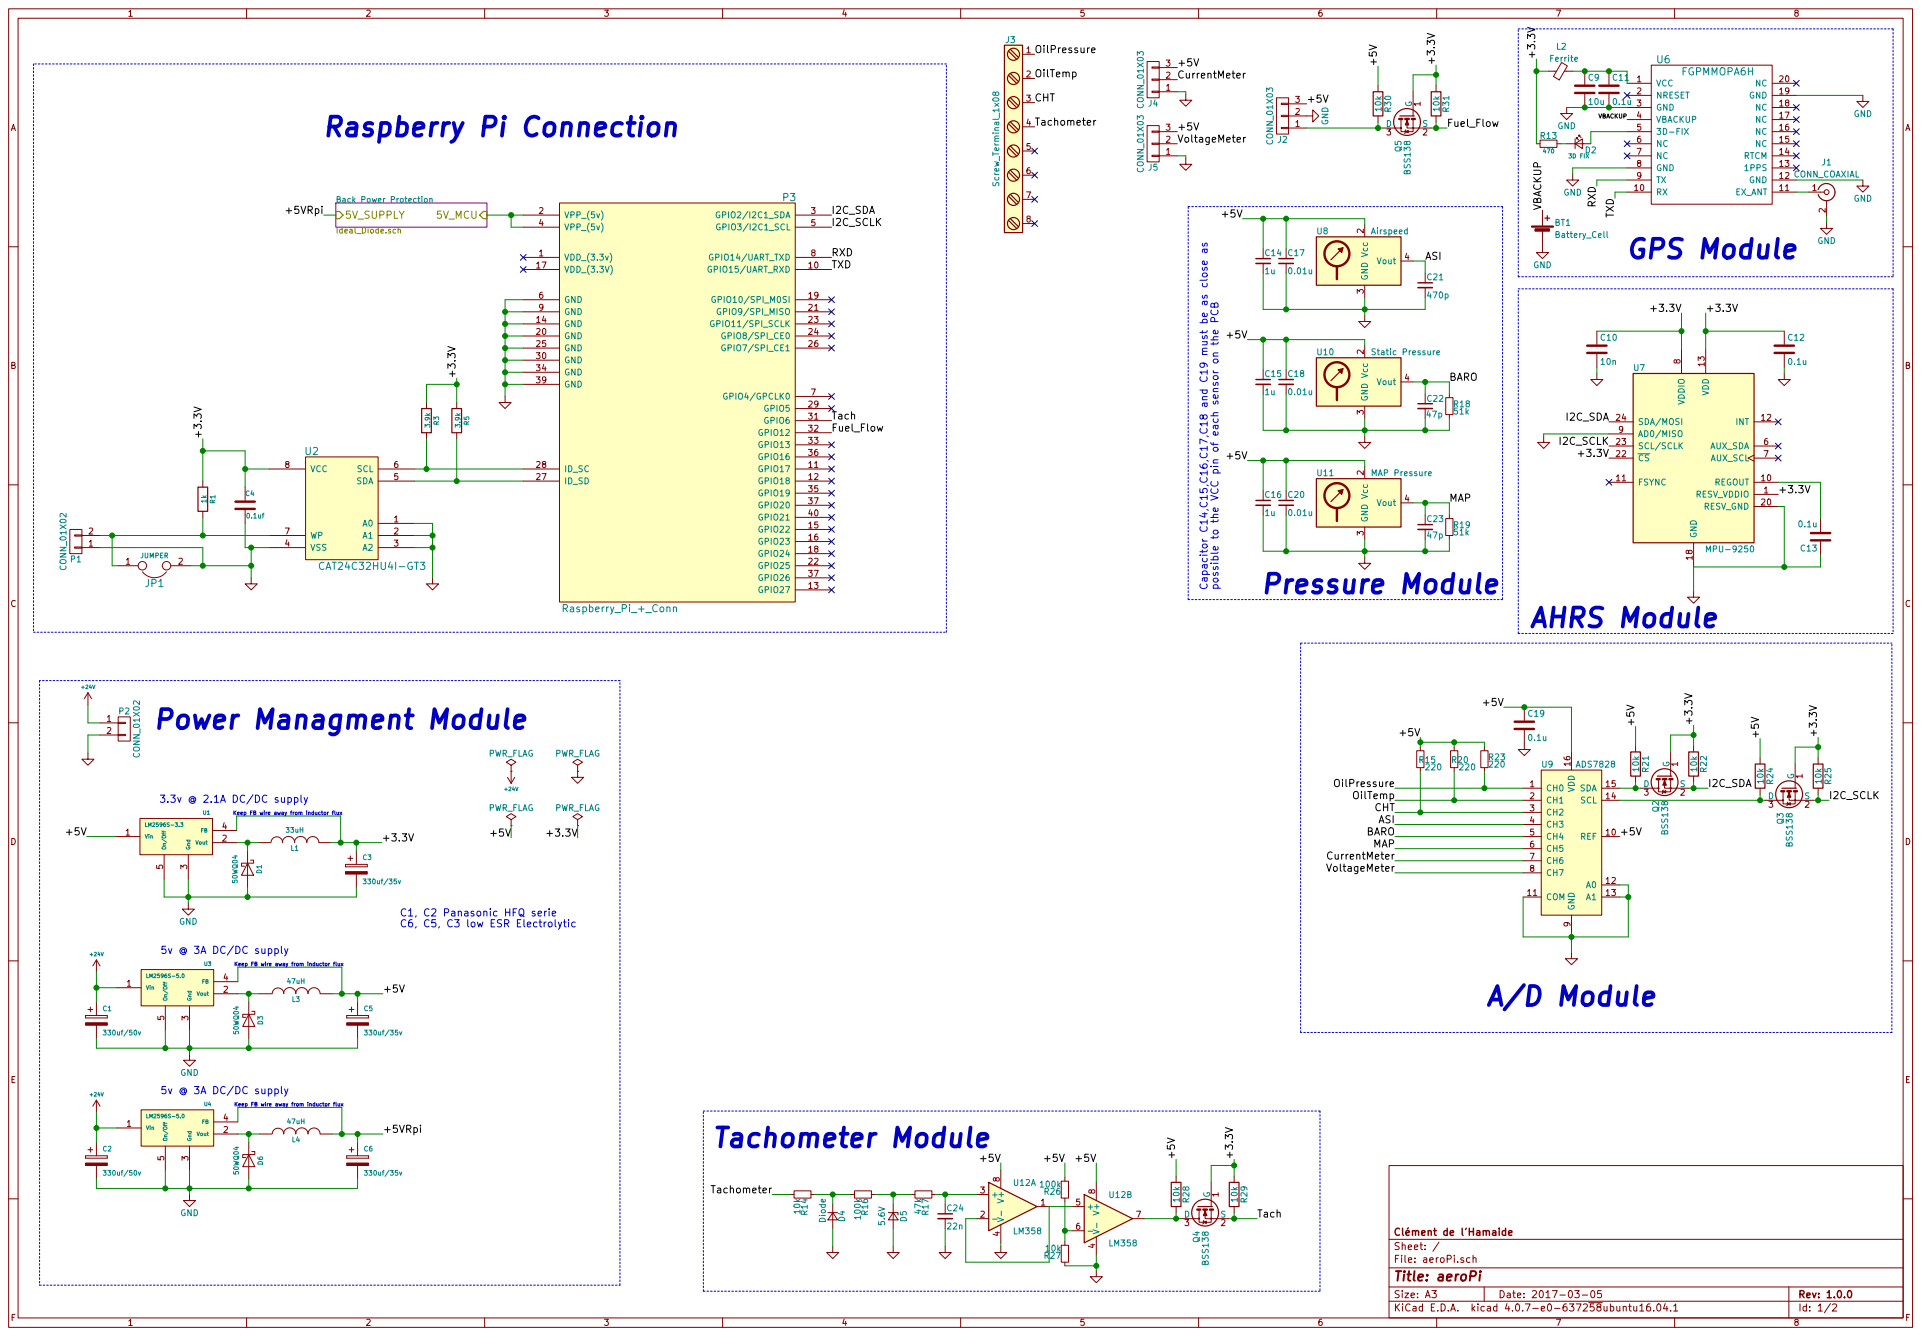
[picture p17: page 1]

BARO MAP Pressure Module

9 REF 10 COM 11 A0 12 A1 13 SCL 14 SDA 15 VDD

Keep FB wire away from inductor flux Vin 1

Id: 1/2 Title: aeroPi File: aeroPi.sch Sheet: / Clément de l'Hamaide

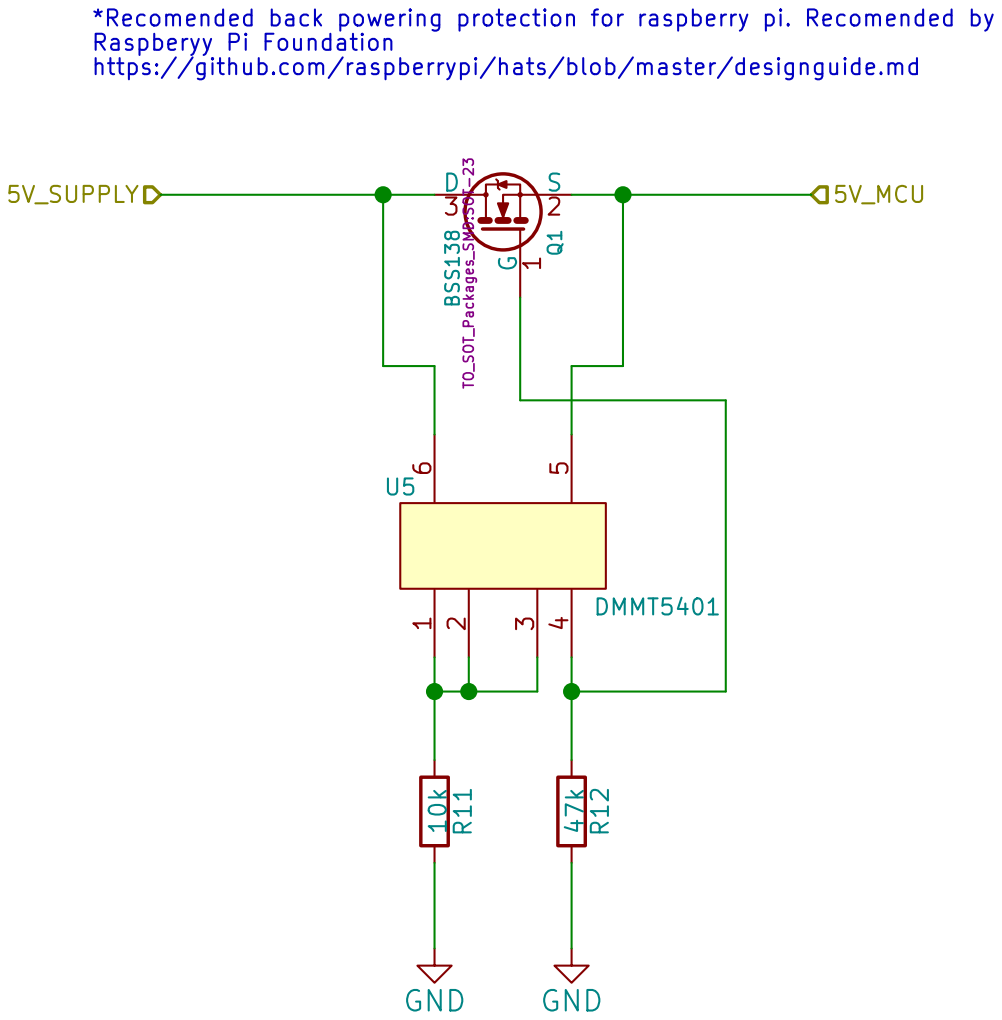
[picture p18: page 2]

*Recomended back powering protection for raspberry pi. Recomended by Raspberyy Pi Foundation
https://github.com/raspberrypi/hats/blob/master/designguide.md

File: Ideal_Diode.sch Sheet: /Back Power Protection/
Id: 2/2 Title:
