F-JJTH/aeropi/resources/circuit/aeroPi.kicad_pcb

## KiCad design resources/circuit/aeroPi.kicad_pcb (2017-10-20)

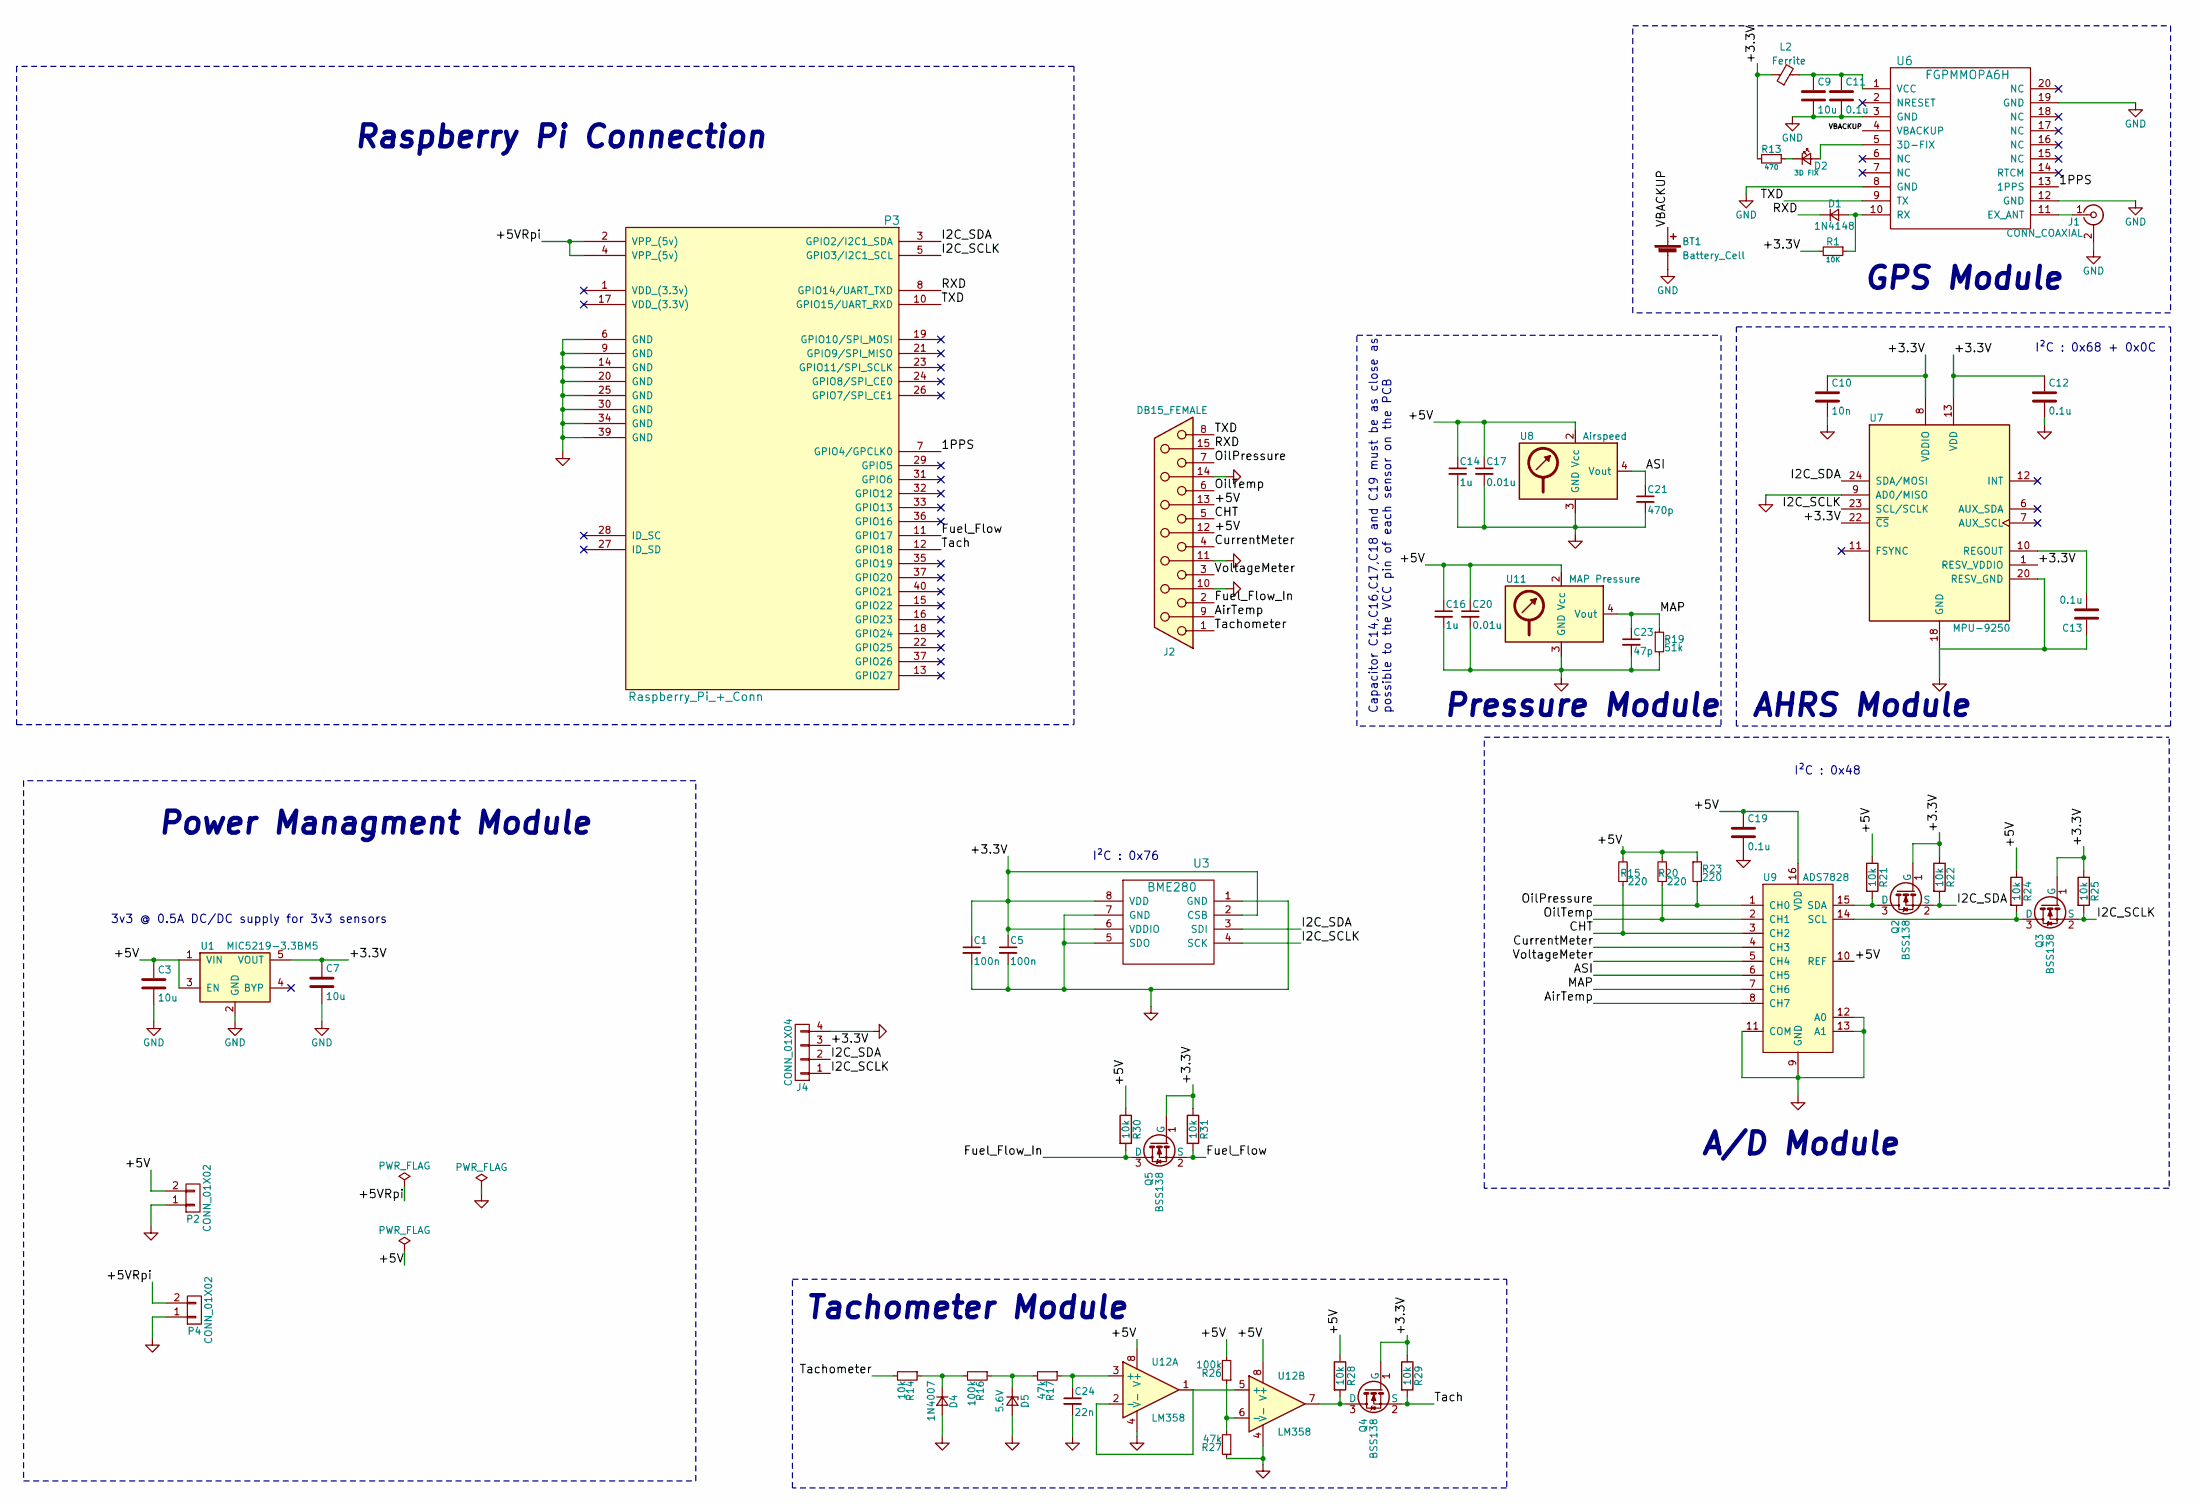
[picture p19: schematic aeroPi.sch]

Parts:
BT1: Battery_Cell; Keystone_3000_1x12mm-CoinCell
C1, C5: 100n; C_0603
C3, C7, C9: 10u; C_0603
C10: 10n; C_0603
C11, C12, C13, C19: 0.1u; C_0603
C14, C16: 1u; C_0603
C17, C20: 0.01u; C_0603
C21: 470p; C_0603
C23: 47p; C_0603
C24: 22n; C_0603
D1: 1N4148; D_SOD-323
D2: 3D FIX; D_0603
D4: 1N4007; D_SOD-323
D5: 5.6V; D_SOD-323
J1: CONN_COAXIAL; Molex_Microcoaxial_RF
J2: DB15_FEMALE; DB15FC
J4: CONN_01X04; Pin_Header_Straight_1x04_Pitch2.54mm
L2: Ferrite; R_0805
P2, P4: CONN_01X02; Pin_Header_Straight_1x02_Pitch2.54mm; Mouser Part No. 651-1904383
P3: Raspberry_Pi_+_Conn; pin_socket_20x2; Mouser Part No. 517-30340-6002
Q2, Q3, Q4, Q5: BSS138; SOT-23
R1: 10K; R_0603
R13: 470; R_0603
R14, R21, R22, R24, R25, R28, R29, R30, R31: 10k; R_0603
R15, R20, R23: 220; R_0603
R16, R26: 100k; R_0603
R17, R27: 47k; R_0603
R19: 51k; R_0603
U1: MIC5219-3.3BM5; SOT-23-5
U3: BME280
U6: FGPMMOPA6H; PA6H
U7: MPU-9250; QFN-24_3x3mm_Pitch0.4mm
U8: Airspeed; MPXV5004DP
U9: ADS7828; TSSOP-16_4.4x5mm_Pitch0.65mm
U11: MAP Pressure; MPXA6115A
U12: LM358; SOIC-8_3.9x4.9mm_Pitch1.27mm

Connections:
/1PPS: P3.7 (GPIO4/GPCLK0), U6.13 (1PPS)
/+3.3V: C1.1, C5.1, C7.1, C10.1, C12.1, J4.3, L2.1, Q2.1 (G), Q3.1 (G), Q4.1 (G), Q5.1 (G), R1.2, R13.2, R22.1, R25.1, R29.1, R31.1, U1.5 (VOUT), U3.2 (CSB), U3.6 (VDDIO), U3.8 (VDD), U7.1 (RESV_VDDIO), U7.8 (VDDIO), U7.13 (VDD), U7.22 (~CS)
/+5V: C3.1, C14.1, C16.1, C17.1, C19.1, C20.1, J2.12, J2.13, P2.2, R15.2, R20.2, R21.1, R23.1, R24.1, R26.2, R28.1, R30.1, U1.1 (VIN), U1.3 (EN), U8.2 (Vcc), U9.10 (REF), U9.16 (VDD), U11.2 (Vcc), U12.8 (V+)
/+5VRpi: P3.2 (VPP_(5v)), P3.4 (VPP_(5v)), P4.2
/ASI: C21.1, U8.4 (Vout), U9.6 (CH5)
/AirTemp: J2.9, U9.8 (CH7)
/CHT: J2.5, R15.1, U9.3 (CH2)
/CurrentMeter: J2.4, U9.4 (CH3)
/Fuel_Flow: P3.11 (GPIO17), Q5.2 (S), R31.2
/Fuel_Flow_In: J2.2, Q5.3 (D), R30.2
/I2C_SCLK: J4.1, P3.5 (GPIO3/I2C1_SCL), Q3.2 (S), R25.2, U3.4 (SCK), U7.23 (SCL/SCLK)
/I2C_SDA: J4.2, P3.3 (GPIO2/I2C1_SDA), Q2.2 (S), R22.2, U3.3 (SDI), U7.24 (SDA/MOSI)
/MAP: C23.1, R19.1, U9.7 (CH6), U11.4 (Vout)
/OilPressure: J2.7, R23.2, U9.1 (CH0)
/OilTemp: J2.6, R20.1, U9.2 (CH1)
/RXD: D1.1 (K), J2.15, P3.8 (GPIO14/UART_TXD)
/TXD: J2.8, P3.10 (GPIO15/UART_RXD), U6.9 (TX)
/Tach: P3.12 (GPIO18), Q4.2 (S), R29.2
/Tachometer: J2.1, R14.2
/VBACKUP: BT1.1 (+), U6.4 (VBACKUP)
/VoltageMeter: J2.3, U9.5 (CH4)
GND: BT1.2 (-), C1.2, C3.2, C5.2, C7.2, C9.2, C10.2, C11.2, C12.2, C13.1, C14.2, C16.2, C17.2, C19.2, C20.2, C21.2, C23.2, C24.2, D4.2 (A), D5.2 (A), J1.2 (Ext), J2.10, J2.11 (P111), J2.14, J4.4, P2.1, P3.6 (GND), P3.9 (GND), P3.14 (GND), P3.20 (GND), P3.25 (GND), P3.30 (GND), P3.34 (GND), P3.39 (GND), P4.1, R19.2, R27.1, U1.2 (GND), U3.1 (GND), U3.5 (SDO), U3.7 (GND), U6.3 (GND), U6.8 (GND), U6.12 (GND), U6.19 (GND), U7.9 (AD0/MISO), U7.18 (GND), U7.20 (RESV_GND), U8.3 (GND), U9.9 (GND), U9.11 (COM), U9.12 (A0), U9.13 (A1), U11.3 (GND), U12.4 (V-)
unnamed: C9.1, C11.1, L2.2, U6.1 (VCC)
unnamed: C13.2, U7.10 (REGOUT)
unnamed: C24.1, R17.1, U12.3 (+)
unnamed: D1.2 (A), R1.1, U6.10 (RX)
unnamed: D2.1 (K), R13.1
unnamed: D2.2 (A), U6.5 (3D-FIX)
unnamed: D4.1 (K), R14.1, R16.2
unnamed: D5.1 (K), R16.1, R17.2
unnamed: J1.1 (In), U6.11 (EX_ANT)
unnamed: Q2.3 (D), R21.2, U9.15 (SDA)
unnamed: Q3.3 (D), R24.2, U9.14 (SCL)
unnamed: Q4.3 (D), R28.2, U12.7
unnamed: R26.1, R27.2, U12.6 (-)
unnamed: U12.1, U12.2 (-), U12.5 (+)

Notes on the sheet:
Raspberry Pi Connection
Power Managment Module
GPS Module
AHRS Module
A/D Module
Pressure Module
Tachometer Module
Capacitor C14,C16,C17,C18 and C19 must be as close as possible to the VCC pin of each sensor on the PCB
3v3 @ 0.5A DC/DC supply for 3v3 sensors
I²C : 0x76
I²C : 0x68 + 0x0C
I²C : 0x48

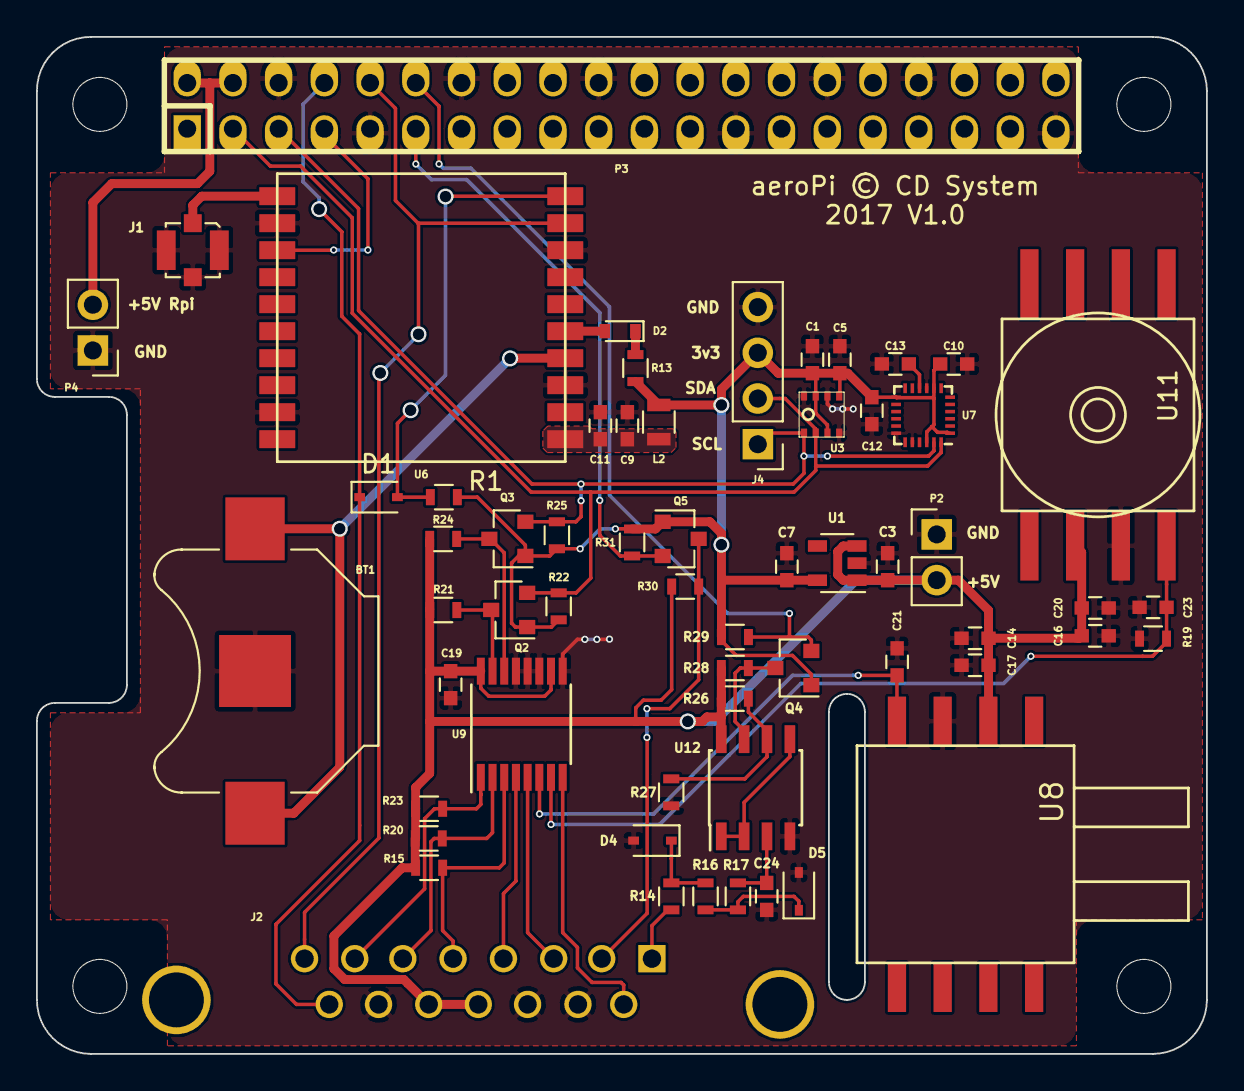
[picture p20: board aeroPi.kicad_pcb from above]

Board: 2 copper layers, 65.0 x 56.5 mm, 64 parts (0 on the bottom side), 36 nets.

Other parts of the board:
M0, M1, M2, M3: MountingHole_3mm
