F-JJTH/aeropi/resources/circuit/prototype_circuit/proto.kicad_pcb

## KiCad design resources/circuit/prototype_circuit/proto.kicad_pcb (2017-08-20)

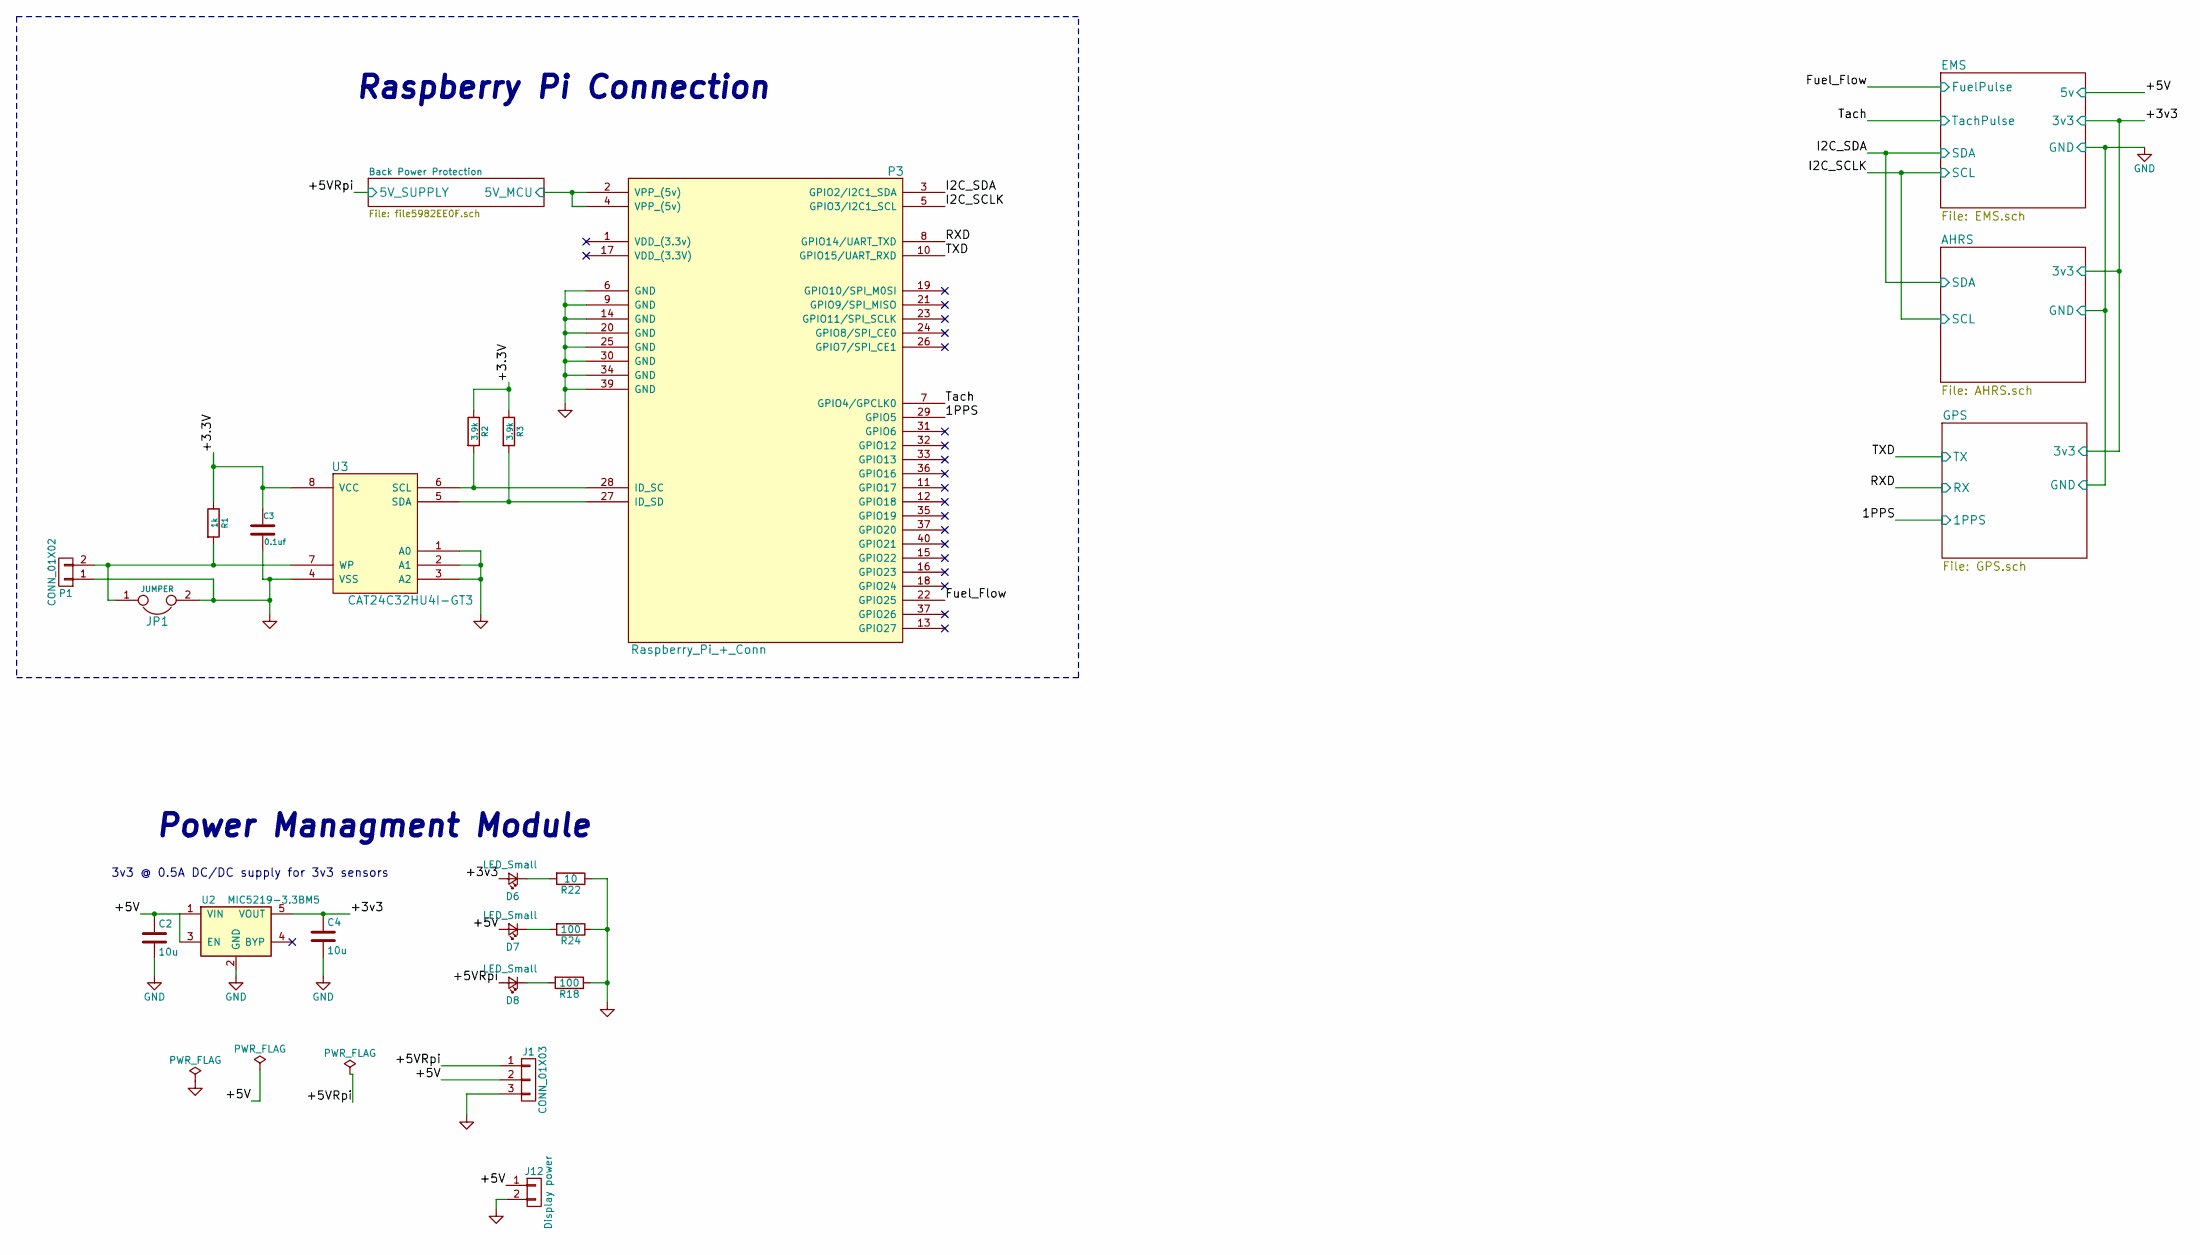
[picture p21: schematic proto.sch, aeroPi]

Parts:
C2, C4: 10u; C_0603
C3: 0.1uf; C_0603; Mouser Part No. 810-C1005X5R1H104K
D6, D7, D8: LED_Small; LED_0805
J1: CONN_01X03; Pin_Header_Straight_1x03_Pitch2.54mm
J12: Display power; Pin_Header_Straight_1x02_Pitch2.54mm
JP1: JUMPER; R_0603
P1: CONN_01X02; pin_strip_2
P3: Raspberry_Pi_+_Conn; vasch_strip_20x2; Mouser Part No. 517-30340-6002
R1: 1k; R_0603; Mouser Part No. 754-RR0510P-102D
R2, R3: 3.9k; R_0603; Mouser Part No. 71-CRCW04023K90FKED
R18, R24: 100; R_0603
R22: 10; R_0603
U2: MIC5219-3.3BM5; SOT-23-5
U3: CAT24C32HU4I-GT3; tssop-8; Mouser Part No. 698-CAT24C32YI-GT3

Connections:
/1PPS: P3.29 (GPIO5); also elsewhere on the board
/+3.3V: C3.1, R1.1, R2.1, R3.1, U3.8 (VCC)
/+3v3: C4.1, D6.2 (A), U2.5 (VOUT); also elsewhere on the board
/+5V: C2.1, D7.2 (A), J1.2, J12.1, U2.1 (VIN), U2.3 (EN); also elsewhere on the board
/+5VRpi: D8.2 (A), J1.1; also elsewhere on the board
/Back Power Protection/5V_MCU: P3.2 (VPP_(5v)), P3.4 (VPP_(5v)); also elsewhere on the board
/Fuel_Flow: P3.22 (GPIO25); also elsewhere on the board
/I2C_SCLK: P3.5 (GPIO3/I2C1_SCL); also elsewhere on the board
/I2C_SDA: P3.3 (GPIO2/I2C1_SDA); also elsewhere on the board
/RXD: P3.8 (GPIO14/UART_TXD); also elsewhere on the board
/TXD: P3.10 (GPIO15/UART_RXD); also elsewhere on the board
/Tach: P3.7 (GPIO4/GPCLK0); also elsewhere on the board
GND: C2.2, C3.2, C4.2, J1.3, J12.2, JP1.2, P1.1, P3.6 (GND), P3.9 (GND), P3.14 (GND), P3.20 (GND), P3.25 (GND), P3.30 (GND), P3.34 (GND), P3.39 (GND), R18.1, R22.1, R24.1, U2.2 (GND), U3.1 (A0), U3.2 (A1), U3.3 (A2), U3.4 (VSS); also elsewhere on the board
unnamed: D6.1 (K), R22.2
unnamed: D7.1 (K), R24.2
unnamed: D8.1 (K), R18.2
unnamed: JP1.1, P1.2, R1.2, U3.7 (WP)
unnamed: P3.27 (ID_SD), R3.2, U3.5 (SDA)
unnamed: P3.28 (ID_SC), R2.2, U3.6 (SCL)

Notes on the sheet:
Raspberry Pi Connection
Power Managment Module
3v3 @ 0.5A DC/DC supply for 3v3 sensors

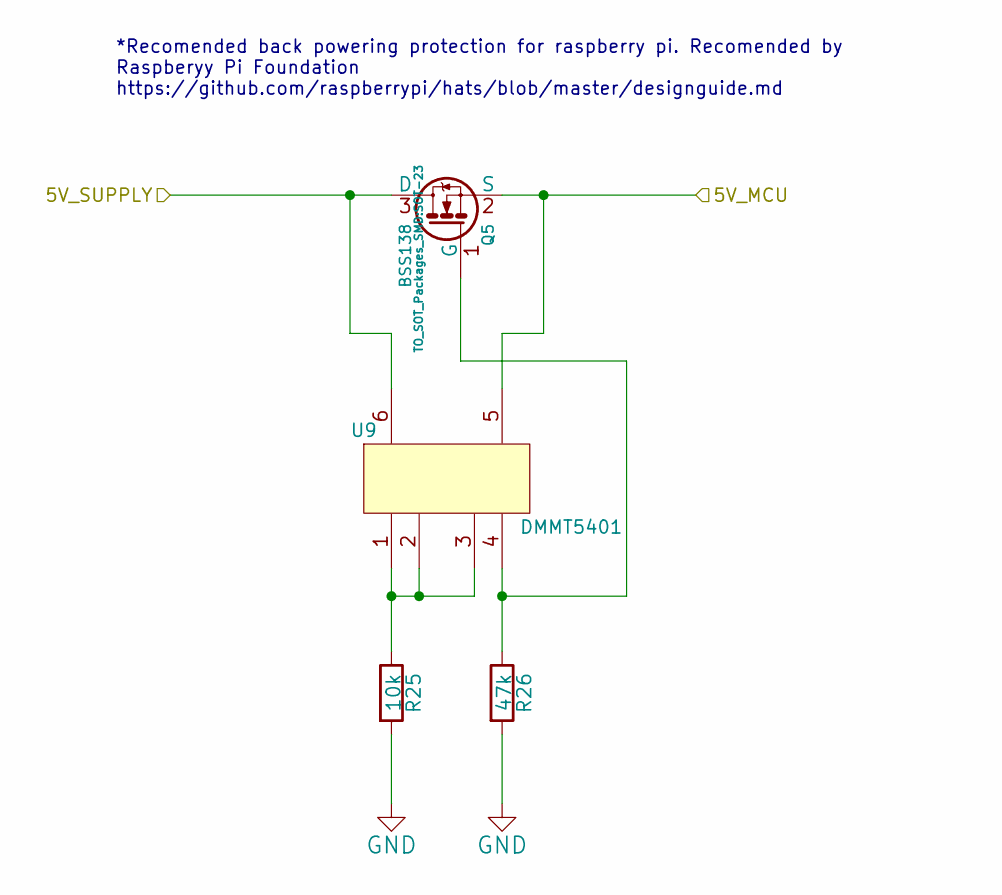
[picture p22: schematic file5982EE0F.sch]

Parts:
Q5: BSS138; SOT-23; Mouser Part No. 621-DMG2305UX-13
R25: 10k; R_0603; Mouser Part No. 71-CRCW0402-10K-E3
R26: 47k; R_0603; Mouser Part No. 667-ERJ-2RKF4702X
U9: DMMT5401; sot23-6; Mouser Part No. 621-DMMT5401-7-F

Connections:
/+5VRpi: Q5.3 (D), U9.6; also elsewhere on the board
/Back Power Protection/5V_MCU: Q5.2 (S), U9.5; also elsewhere on the board
GND: R25.2, R26.2; also elsewhere on the board
unnamed: Q5.1 (G), R26.1, U9.4
unnamed: R25.1, U9.1, U9.2, U9.3

Notes on the sheet:
*Recomended back powering protection for raspberry pi. Recomended by Raspberyy Pi Foundation https://github.com/raspberrypi/hats/blob/master/designguide.md

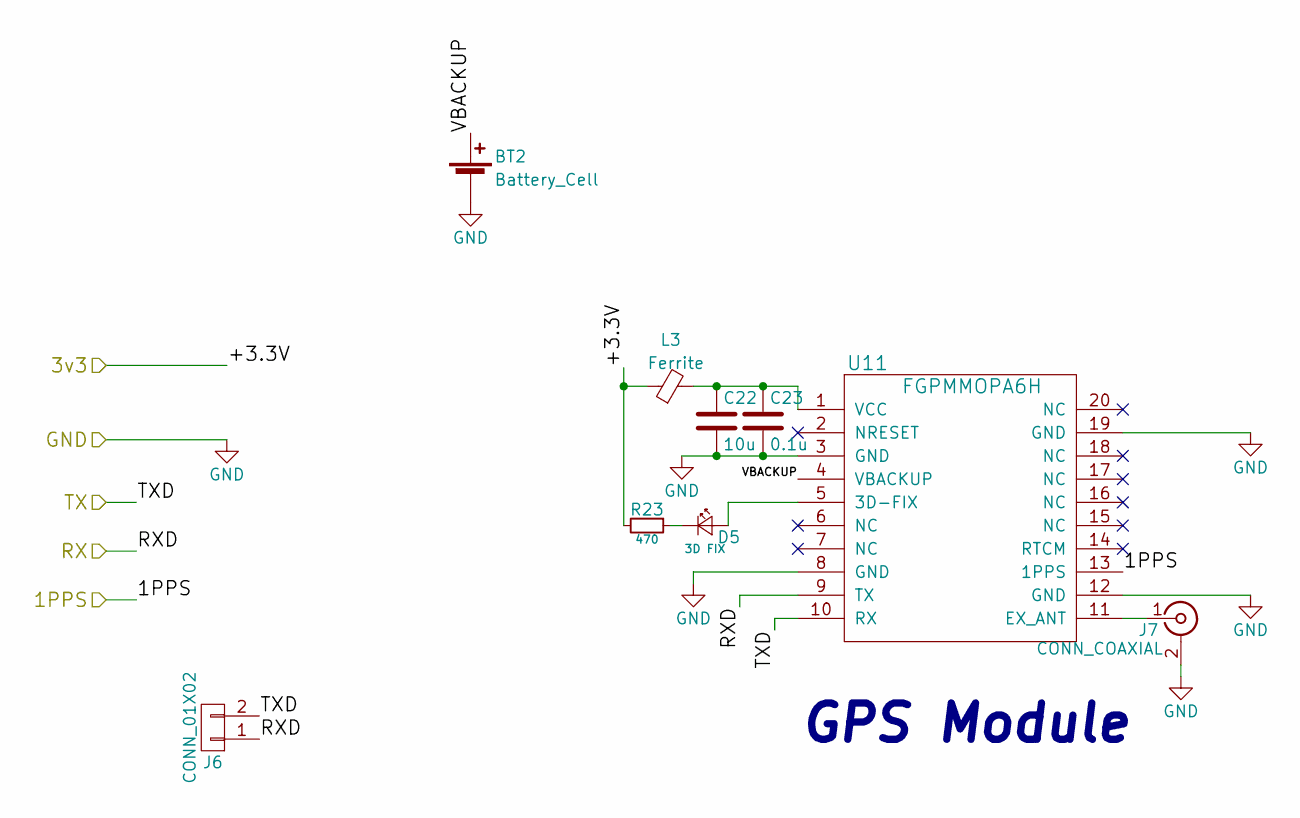
[picture p23: schematic GPS.sch]

Parts:
BT2: Battery_Cell; Keystone_3000_1x12mm-CoinCell
C22: 10u; C_0603
C23: 0.1u; C_0603
D5: 3D FIX; D_0603
J6: CONN_01X02; Pin_Header_Straight_1x02_Pitch2.54mm
J7: CONN_COAXIAL; Molex_Microcoaxial_RF
L3: Ferrite; R_0805
R23: 470; R_0603
U11: FGPMMOPA6H; PA6H

Connections:
/1PPS: U11.13 (1PPS); also elsewhere on the board
/+3v3: L3.1, R23.2; also elsewhere on the board
/GPS/VBACKUP: BT2.1 (+), U11.4 (VBACKUP)
/RXD: J6.1, U11.9 (TX); also elsewhere on the board
/TXD: J6.2, U11.10 (RX); also elsewhere on the board
GND: BT2.2 (-), C22.2, C23.2, J7.2 (Ext), U11.3 (GND), U11.8 (GND), U11.12 (GND), U11.19 (GND); also elsewhere on the board
unnamed: C22.1, C23.1, L3.2, U11.1 (VCC)
unnamed: D5.1 (K), R23.1
unnamed: D5.2 (A), U11.5 (3D-FIX)
unnamed: J7.1 (In), U11.11 (EX_ANT)

Notes on the sheet:
GPS Module

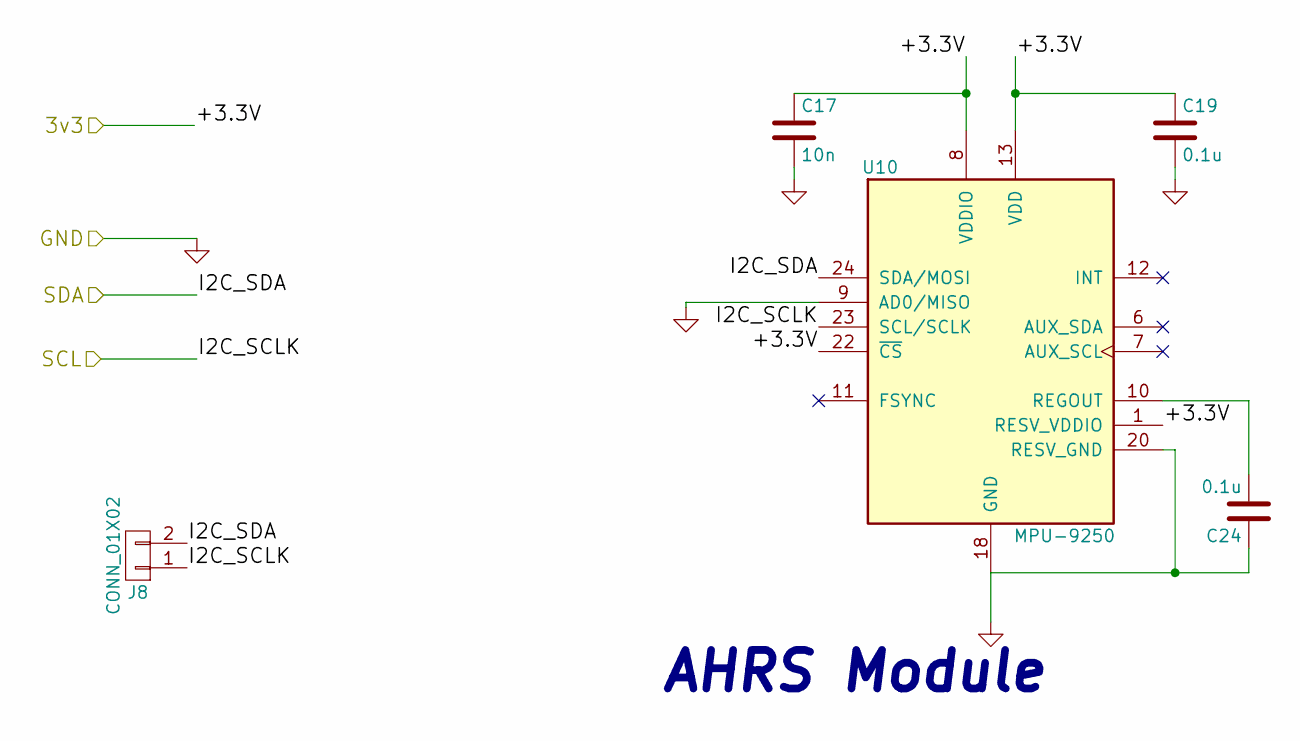
[picture p24: schematic AHRS.sch]

Parts:
C17: 10n; C_0603
C19, C24: 0.1u; C_0603
J8: CONN_01X02; Pin_Header_Straight_1x02_Pitch2.54mm
U10: MPU-9250; QFN-24_3x3mm_Pitch0.4mm

Connections:
/+3v3: C17.1, C19.1, U10.1 (RESV_VDDIO), U10.8 (VDDIO), U10.13 (VDD), U10.22 (~CS); also elsewhere on the board
/I2C_SCLK: J8.1, U10.23 (SCL/SCLK); also elsewhere on the board
/I2C_SDA: J8.2, U10.24 (SDA/MOSI); also elsewhere on the board
GND: C17.2, C19.2, C24.1, U10.9 (AD0/MISO), U10.18 (GND), U10.20 (RESV_GND); also elsewhere on the board
unnamed: C24.2, U10.10 (REGOUT)

Notes on the sheet:
AHRS Module

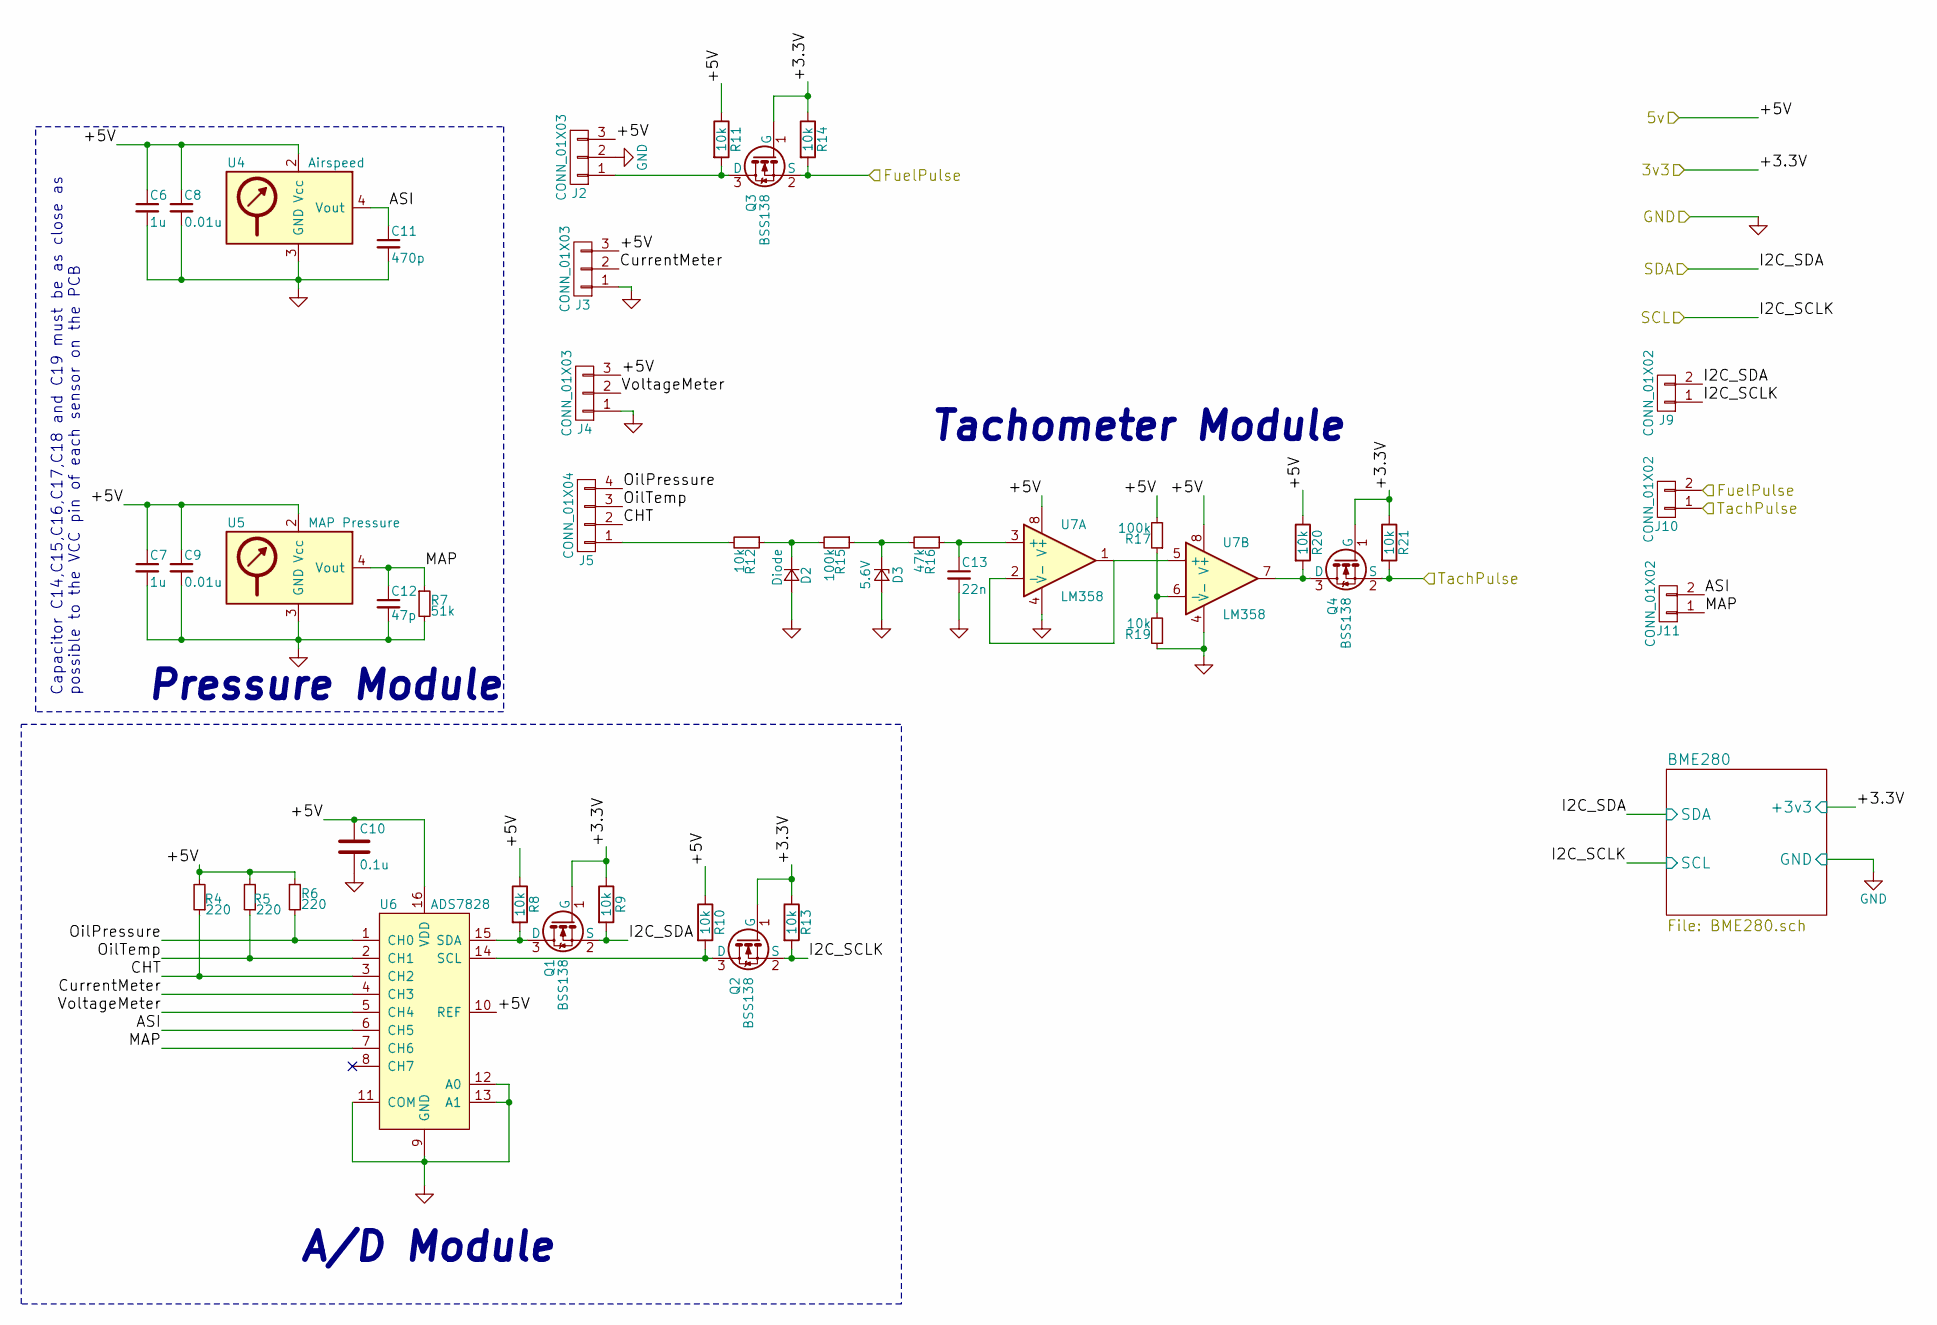
[picture p25: schematic EMS.sch]

Parts:
C6, C7: 1u; C_0603
C8, C9: 0.01u; C_0603
C10: 0.1u; C_0603
C11: 470p; C_0603
C12: 47p; C_0603
C13: 22n; C_0603
D2: Diode; D_0603
D3: 5.6V; D_SOD-323
J2, J3, J4: CONN_01X03; Pin_Header_Straight_1x03_Pitch2.54mm
J5: CONN_01X04; Pin_Header_Straight_1x04_Pitch2.54mm
J9, J10, J11: CONN_01X02; Pin_Header_Straight_1x02_Pitch2.54mm
Q1, Q2, Q3, Q4: BSS138; SOT-23
R4, R5, R6: 220; R_0603
R7: 51k; R_0603
R8, R9, R10, R11, R12, R13, R14, R19, R20, R21: 10k; R_0603
R15, R17: 100k; R_0603
R16: 47k; R_0603
U4: Airspeed; SOIC-8-N
U5: MAP Pressure; SOIC-8-N
U6: ADS7828; TSSOP-16_4.4x5mm_Pitch0.65mm
U7: LM358; SOIC-8_3.9x4.9mm_Pitch1.27mm

Connections:
/+3v3: Q1.1 (G), Q2.1 (G), Q3.1 (G), Q4.1 (G), R9.1, R13.1, R14.1, R21.1; also elsewhere on the board
/+5V: C6.1, C7.1, C8.1, C9.1, C10.1, J2.3, J3.3, J4.3, R4.2, R5.2, R6.1, R8.1, R10.1, R11.1, R17.2, R20.1, U4.2 (Vcc), U5.2 (Vcc), U6.10 (REF), U6.16 (VDD), U7.8 (V+); also elsewhere on the board
/EMS/ASI: C11.1, J11.2, U4.4 (Vout), U6.6 (CH5)
/EMS/CHT: J5.2, R4.1, U6.3 (CH2)
/EMS/CurrentMeter: J3.2, U6.4 (CH3)
/EMS/MAP: C12.1, J11.1, R7.1, U5.4 (Vout), U6.7 (CH6)
/EMS/OilPressure: J5.4, R6.2, U6.1 (CH0)
/EMS/OilTemp: J5.3, R5.1, U6.2 (CH1)
/EMS/VoltageMeter: J4.2, U6.5 (CH4)
/Fuel_Flow: J10.2, Q3.2 (S), R14.2; also elsewhere on the board
/I2C_SCLK: J9.1, Q2.2 (S), R13.2; also elsewhere on the board
/I2C_SDA: J9.2, Q1.2 (S), R9.2; also elsewhere on the board
/Tach: J10.1, Q4.2 (S), R21.2; also elsewhere on the board
GND: C6.2, C7.2, C8.2, C9.2, C10.2, C11.2, C12.2, C13.2, D2.2 (A), D3.2 (A), J2.2, J3.1, J4.1, R7.2, R19.1, U4.3 (GND), U5.3 (GND), U6.9 (GND), U6.11 (COM), U6.12 (A0), U6.13 (A1), U7.4 (V-); also elsewhere on the board
unnamed: C13.1, R16.1, U7.3 (+)
unnamed: D2.1 (K), R12.1, R15.2
unnamed: D3.1 (K), R15.1, R16.2
unnamed: J2.1, Q3.3 (D), R11.2
unnamed: J5.1, R12.2
unnamed: Q1.3 (D), R8.2, U6.15 (SDA)
unnamed: Q2.3 (D), R10.2, U6.14 (SCL)
unnamed: Q4.3 (D), R20.2, U7.7
unnamed: R17.1, R19.2, U7.6 (-)
unnamed: U7.1, U7.2 (-), U7.5 (+)

Notes on the sheet:
A/D Module
Pressure Module
Capacitor C14,C15,C16,C17,C18 and C19 must be as close as possible to the VCC pin of each sensor on the PCB
Tachometer Module

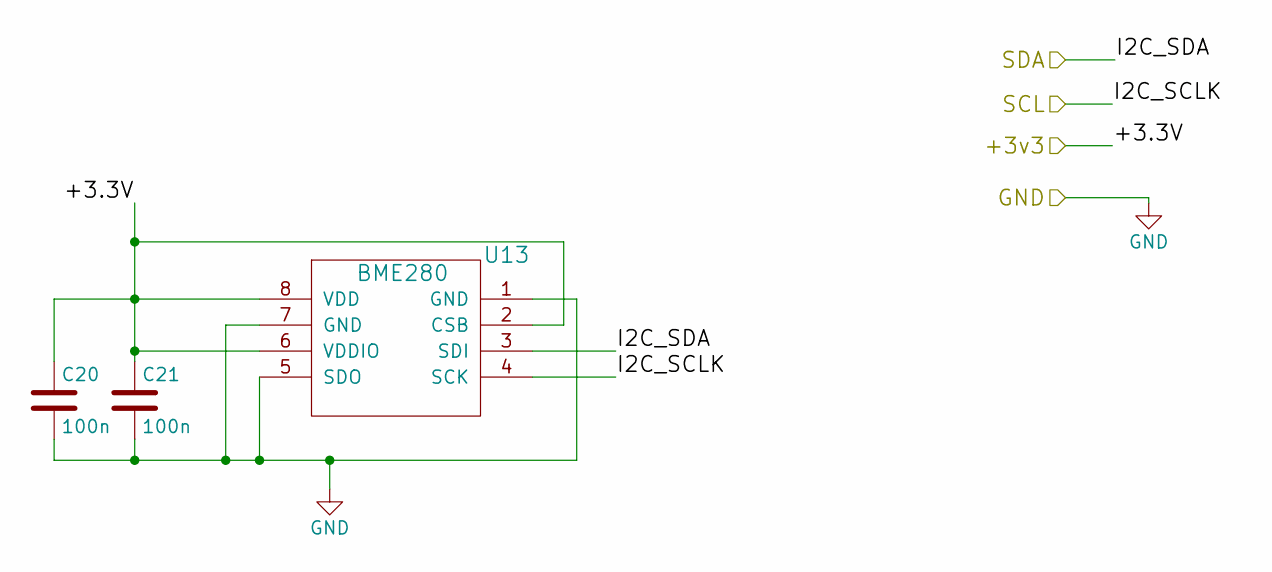
[picture p26: schematic BME280.sch]

Parts:
C20, C21: 100n; C_0603
U13: BME280

Connections:
/+3v3: C20.1, C21.1, U13.2 (CSB), U13.6 (VDDIO), U13.8 (VDD); also elsewhere on the board
/I2C_SCLK: U13.4 (SCK); also elsewhere on the board
/I2C_SDA: U13.3 (SDI); also elsewhere on the board
GND: C20.2, C21.2, U13.1 (GND), U13.5 (SDO), U13.7 (GND); also elsewhere on the board

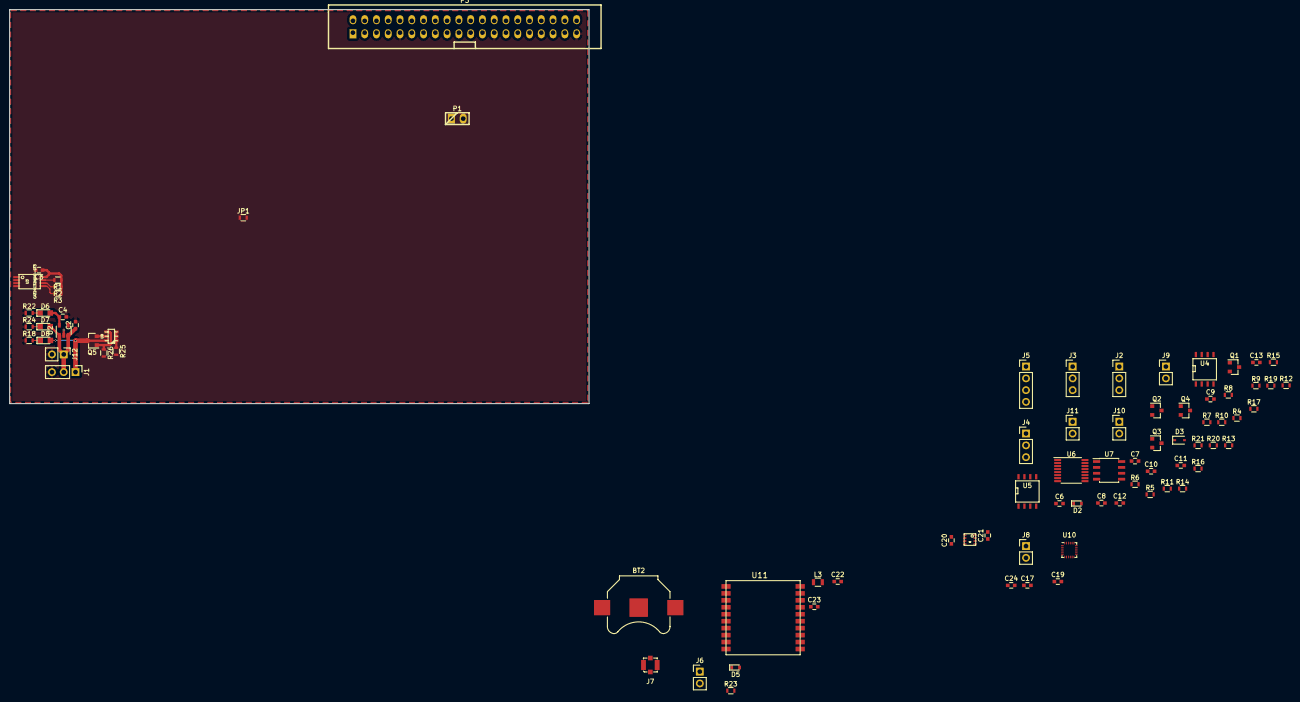
[picture p27: board proto.kicad_pcb from above]

Board: 2 copper layers, 125.0 x 85.0 mm, 82 parts (0 on the bottom side), 44 nets.
