F-JJTH/aeropi/resources/power-management/power-management.kicad_pcb

## KiCad design resources/power-management/power-management.kicad_pcb (2023-01-09)

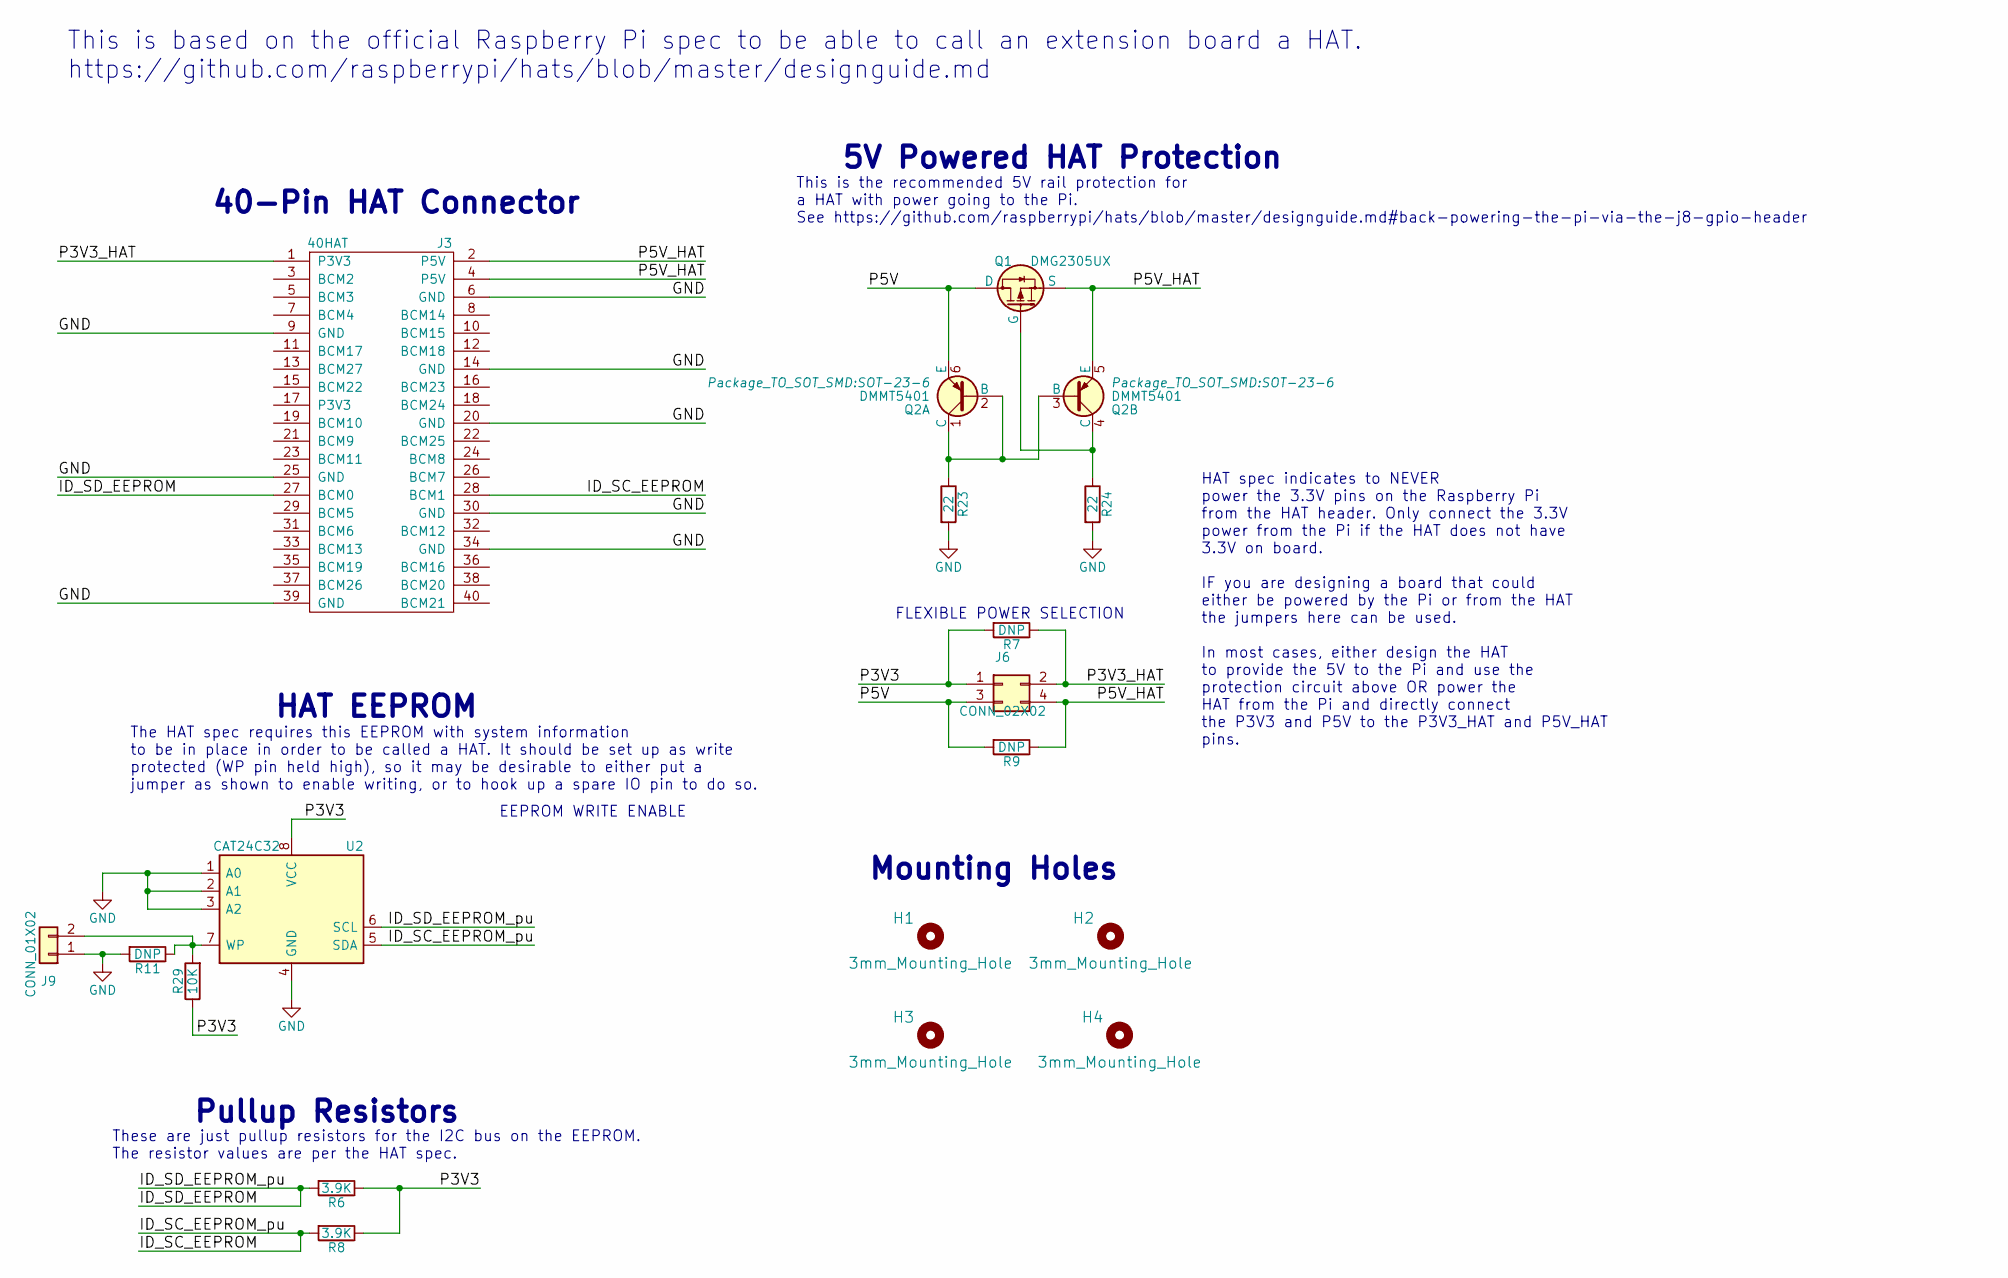
[picture p28: schematic power-management.sch, Raspberry Pi HAT]

Parts:
H1, H2, H3, H4: 3mm_Mounting_Hole; NPTH_3mm_ID
J3: 40HAT; PinSocket_2x20_P2.54mm_Vertical
J6: CONN_02X02; PinHeader_2x02_P2.54mm_Vertical
J9: CONN_01X02; PinHeader_1x02_P2.54mm_Vertical
Q1: DMG2305UX; SOT-23
Q2: DMMT5401; SOT-23-6
R6, R8: 3.9K; R_0603_1608Metric_Pad0.84x1.00mm_HandSolder; MPN RC0402JR-0722RL
R7, R9, R11: DNP; R_0603_1608Metric_Pad0.84x1.00mm_HandSolder; MPN RC0402JR-0722RL
R23, R24: 22; R_0603_1608Metric_Pad0.84x1.00mm_HandSolder; MPN RC0402JR-0722RL
R29: 10K; R_0603_1608Metric_Pad0.84x1.00mm_HandSolder; MPN RC0402JR-0722RL
U2: CAT24C32; SOIC-8_3.9x4.9mm_P1.27mm

Connections:
/ID_SC_EEPROM: J3.28 (BCM1), R8.2, U2.5 (SDA)
/ID_SD_EEPROM: J3.27 (BCM0), R6.2, U2.6 (SCL)
/P3V3: J6.1, R6.1, R7.2, R8.1, R29.1, U2.8 (VCC)
/P3V3_HAT: J3.1 (P3V3), J6.2, R7.1
/P5V: J6.3, Q1.3 (D), Q2.6 (E), R9.2
/P5V_HAT: J3.2 (P5V), J3.4 (P5V), J6.4, Q1.2 (S), Q2.5 (E), R9.1
GND: J3.6 (GND), J3.9 (GND), J3.14 (GND), J3.20 (GND), J3.25 (GND), J3.30 (GND), J3.34 (GND), J3.39 (GND), J9.1, R11.2, R23.2, R24.2, U2.1 (A0), U2.2 (A1), U2.3 (A2), U2.4 (GND)
unnamed: J9.2, R11.1, R29.2, U2.7 (WP)
unnamed: Q1.1 (G), Q2.4 (C), R24.1
unnamed: Q2.1 (C), Q2.2 (B), Q2.3 (B), R23.1

Notes on the sheet:
FLEXIBLE POWER SELECTION
5V Powered HAT Protection
This is the recommended 5V rail protection for a HAT with power going to the Pi. See https://github.com/raspberrypi/hats/blob/master/designguide.md#back-powering-the-pi-via-the-j8-gpio-header
EEPROM WRITE ENABLE
Pullup Resistors
HAT EEPROM
Mounting Holes
40-Pin HAT Connector
HAT spec indicates to NEVER power the 3.3V pins on the Raspberry Pi from the HAT header. Only connect the 3.3V power from the Pi if the HAT does not have 3.3V on board. IF you are designing a board that could either be powered by the Pi or from the HAT the jumpers here can be used. In most cases, e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
The HAT spec requires this EEPROM with system information to be in place in order to be called a HAT. It should be set up as write protected (WP pin held high), so it may be desirable to either put a jumper as shown to enable writing, or to hook up a spare IO pin to do so.
These are just pullup resistors for the I2C bus on the EEPROM. The resistor values are per the HAT spec.
This is based on the official Raspberry Pi spec to be able to call an extension board a HAT. https://github.com/raspberrypi/hats/blob/master/designguide.md

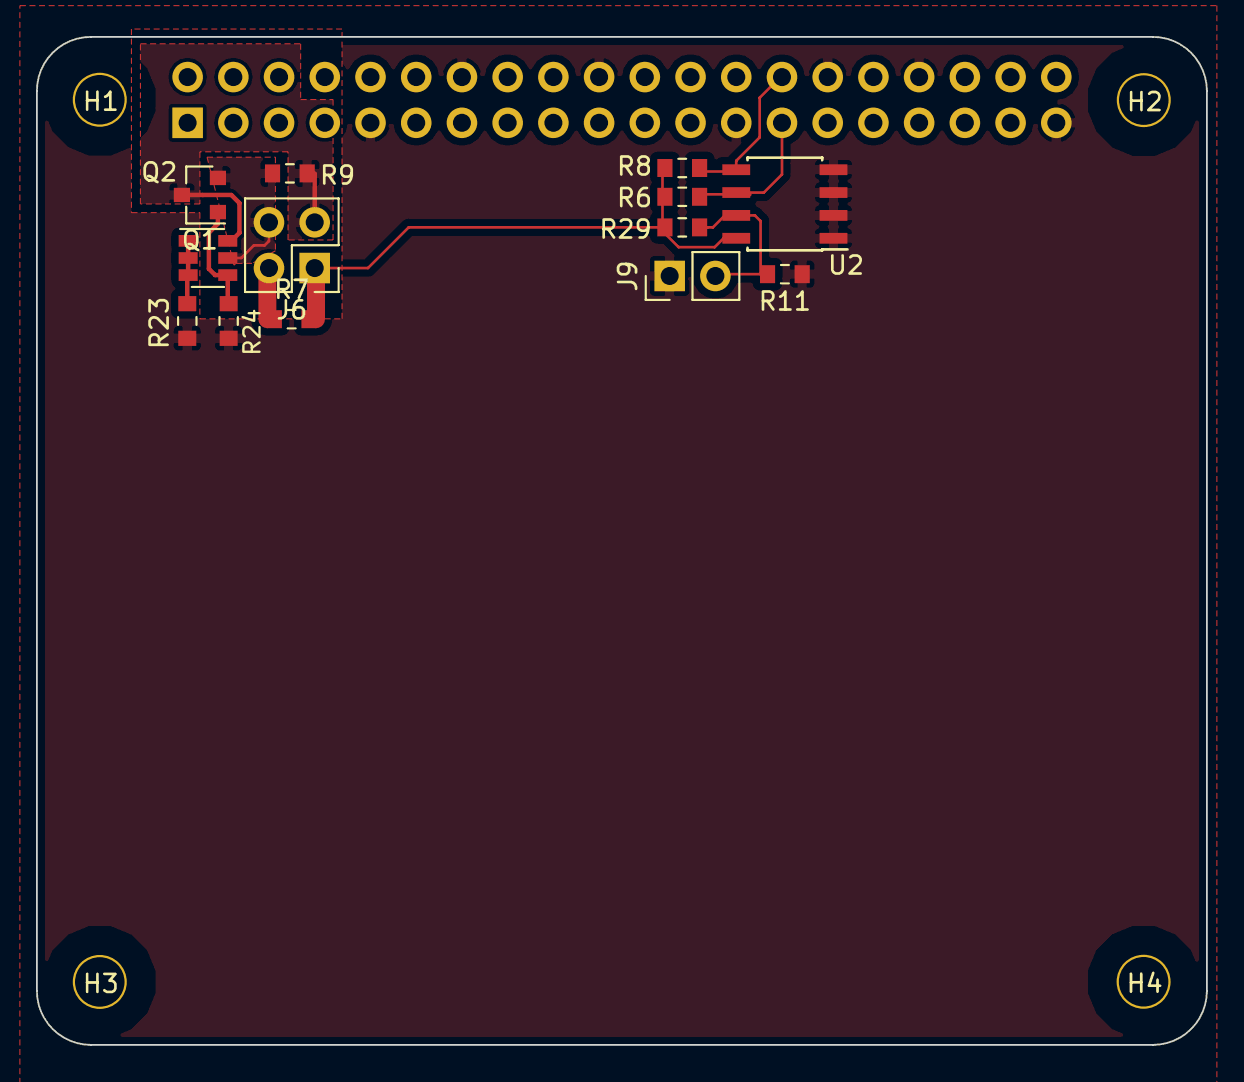
[picture p29: board power-management.kicad_pcb from above]

Board: 4 copper layers, 65.0 x 56.0 mm, 18 parts (1 on the bottom side), 10 nets.
