F-JJTH/aeropi/(commit log)

2016-04-14 Add wire diagram
2016-04-20 Add calibration file
2016-04-20 Create 2 thread and implement JSON encodage
2016-04-21 Adjust RTI calibration
2016-04-21 Implement websocket in multi threaded architecture
2016-05-07 Setup socket on all interface
2016-05-14 Implement calibration for AI
2016-05-25 Implement slip ball + compass indication from compass instead of GPS + animation more smooth
    [server.py]
2016-06-01 Implement persistent option + multiple bugfix
    [server.py]
2016-06-14 fix typo, save and restore last position btw session
    [server.py]
2016-06-15 display ground elevation
2016-06-16 Fix elevation profil and NextControl button
2017-04-08 Do not exit server if something does not init correctly
    [server.py]
2017-04-08 Make thread optional
2017-04-08 Display fuel flow and RPM to HCI
2017-04-09 Change RPM & fuel sensor pin + implemente voltage sensor
2017-05-08 Ajout de ressources
    [Ideal_Diode.sch, aeroPi.kicad_pcb, aeroPi.sch]
2017-05-09 Work on schematic & PCB
    [Ideal_Diode.sch, aeroPi.kicad_pcb, aeroPi.sch]
2017-05-11 Schematic: split analog part
    [Analog_Sensors.sch, Ideal_Diode.sch, aeroPi.sch]
2017-05-12 Schematic work
    [Analog_Sensors.sch, Ideal_Diode.sch, aeroPi.sch]
2017-05-19 Another RPM reading solution
    [Analog_Sensors.sch, Ideal_Diode.sch, aeroPi.sch]
2017-06-11 Work on schematic
    [aeroPi.sch]
2017-06-15 Implement RPM and fuel flow measure
2017-06-15 Clear PCB network + clean schematic
    [Analog_Sensors.sch, Ideal_Diode.sch, aeroPi.kicad_pcb, aeroPi.sch]
2017-08-20 Work on circuit & PCB
    [AHRS.sch, Analog_Sensors.sch, BME280.sch, EMS.sch, GPS.sch, Ideal_Diode.sch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]
2017-10-20 Work on circuit and add documentation + 3D model
    [3d-model-small.stl, 3d-model.stl, Ideal_Diode.sch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]
2017-12-26 version before canvas gauge
    [basulm_1130.csv]
2017-12-26 Switch to canvas gauge + bootstrap
2018-02-18 autozoom switch fix
2018-03-10 schema wip
    [aeroPi.sch]
2018-03-30 Expose current/next airspace + cleanup/performance
2018-04-01 Calibrate voltmeter/current meter
2018-04-16 new calibration
2018-04-20 buck calculator
    [buck_calculator.ods]
2018-04-20 expose raw IMU data
2018-04-20 display raw imu data for debug
2018-04-21 debug imu
2023-01-09 Add electronic data
    [3d-model-small.stl, 3d-model.stl, AHRS.sch, Analog_Sensors.sch, BME280.sch, EMS.sch, GPS.sch, Ideal_Diode.sch]
