F-JJTH/aeropi/(notices)

Notices in the files:
src/madgwick_ahrs.py:
it under the terms of the GNU Lesser General Public License as published by
resources/circuit/aeroPi_almostfinal.kicad_pcb:
License: CERN OHL V1.2
CERN OHL V1.2
resources/circuit/aeroPi.kicad_pcb:
aeroPi © CD System
